bayavahmed/PCB_LIBS/KiCADLibrary/Kütüphane İlk Entegrasyon.docx

KiCad’e AKL pluginini yükle.

Sembol Kütüphanelerini kicade ekle.

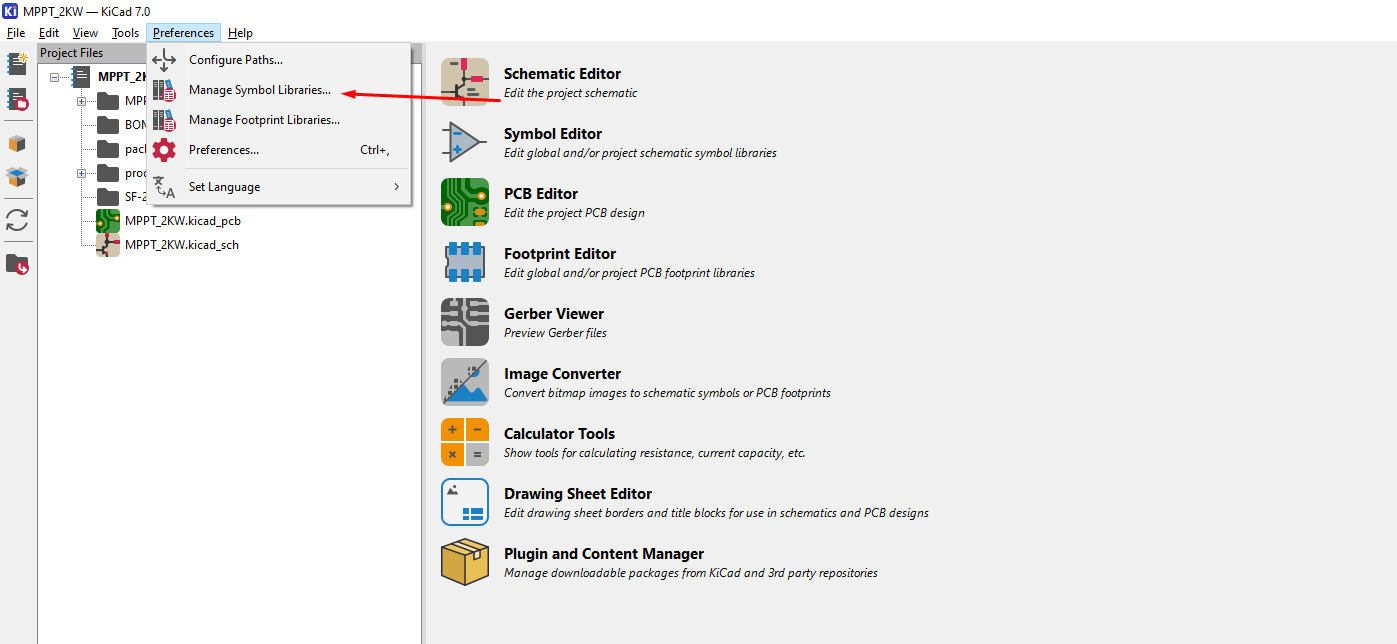
[picture p1: figure]
metin içeren bir resim Açıklama otomatik olarak oluşturuldu

AKL Kütüphanesi:

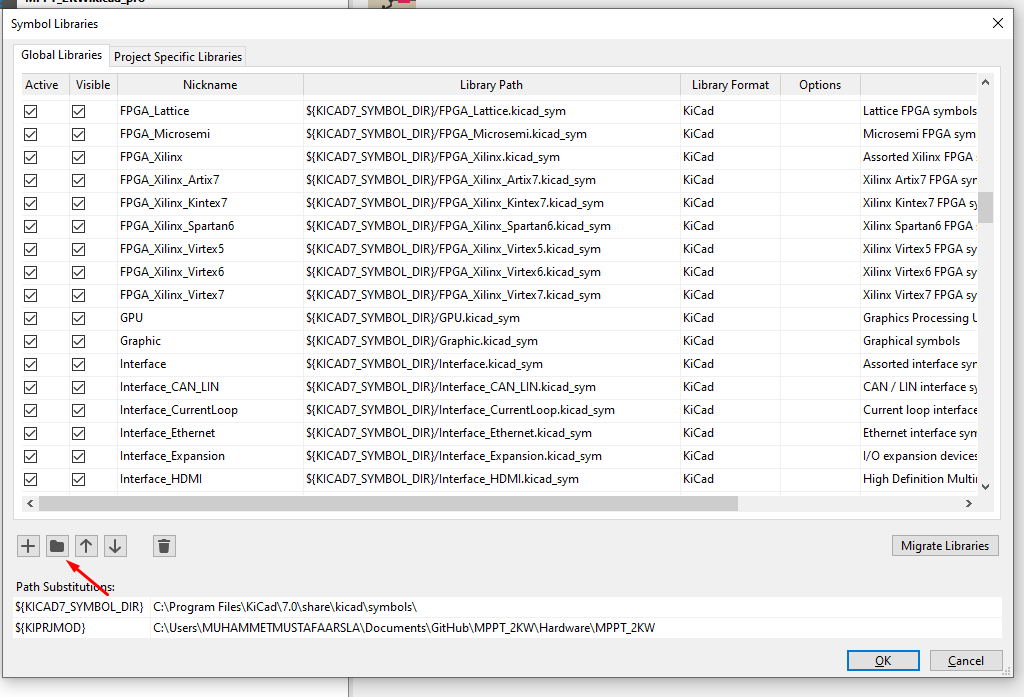
[picture p2: figure]
metin içeren bir resim Açıklama otomatik olarak oluşturuldu

\Documents\KiCad\7.0\3rdparty\symbols\com_github_dawidcislo_alternate-kicad-library

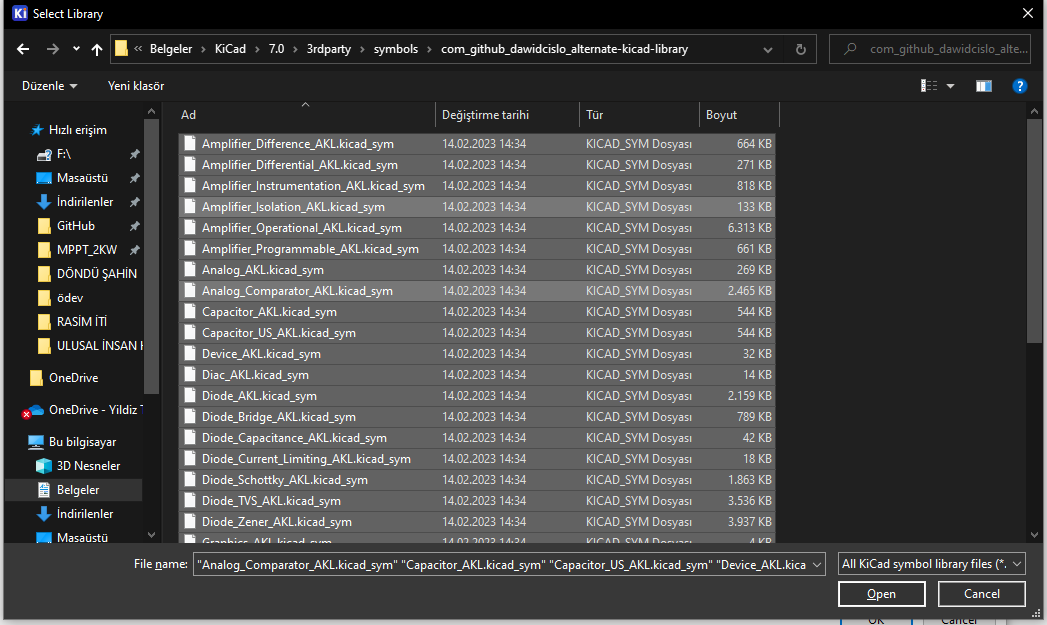
[picture p3: figure]

Hepsini seç

Personal kütüphanesi ekle.

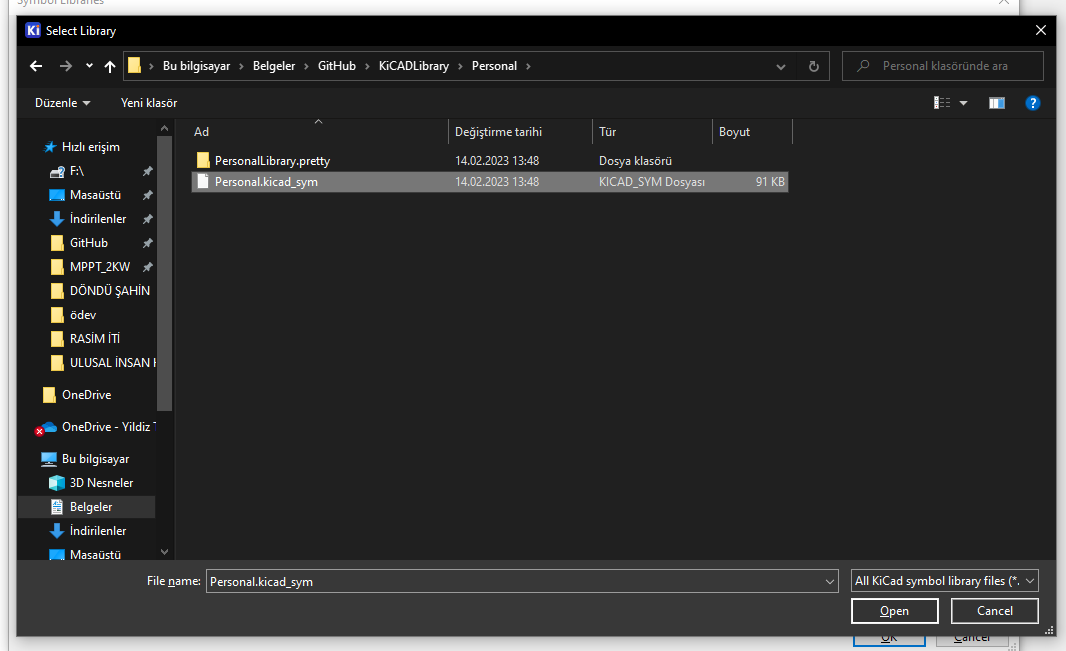
[picture p4: figure]
metin, ekran, ekran görüntüsü, iç mekan içeren bir resim Açıklama otomatik olarak oluşturuldu

~/Documents/GitHub/KiCADLibrary/Personal/Personal.kicad_sym

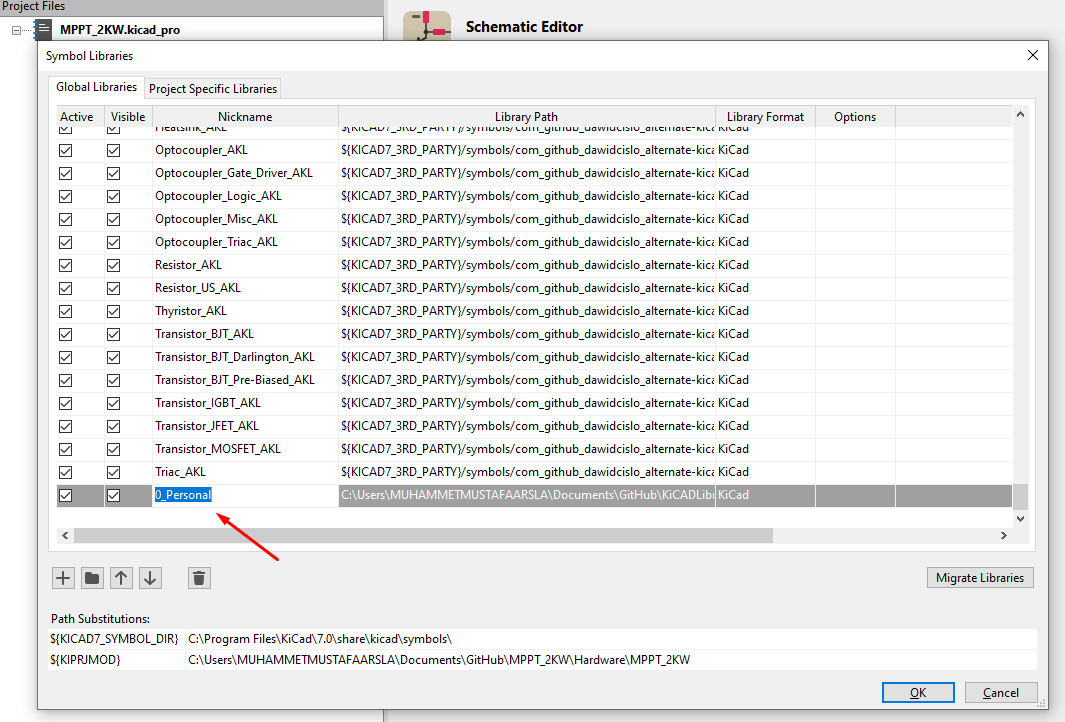
[picture p5: figure]
metin içeren bir resim Açıklama otomatik olarak oluşturuldu

İsmini “0_Personal” olarak değiştir.

SamacSYS kütüphanesini de ekle.

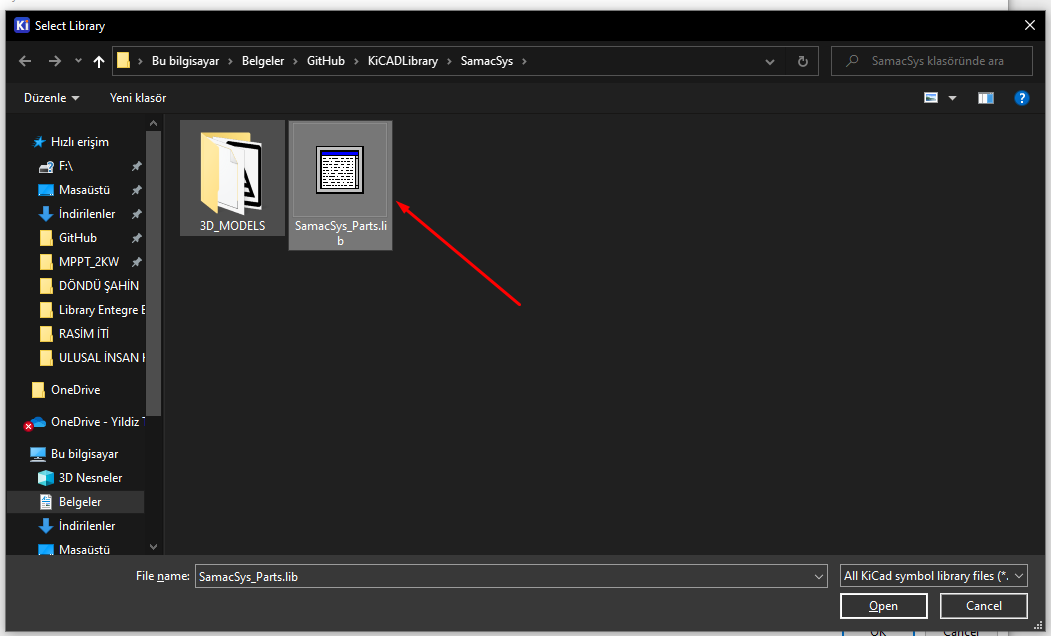
[picture p6: figure]

~~\Documents\GitHub\KiCADLibrary\SamacSys

Footprint Kütüphaneleri eklenmeli:

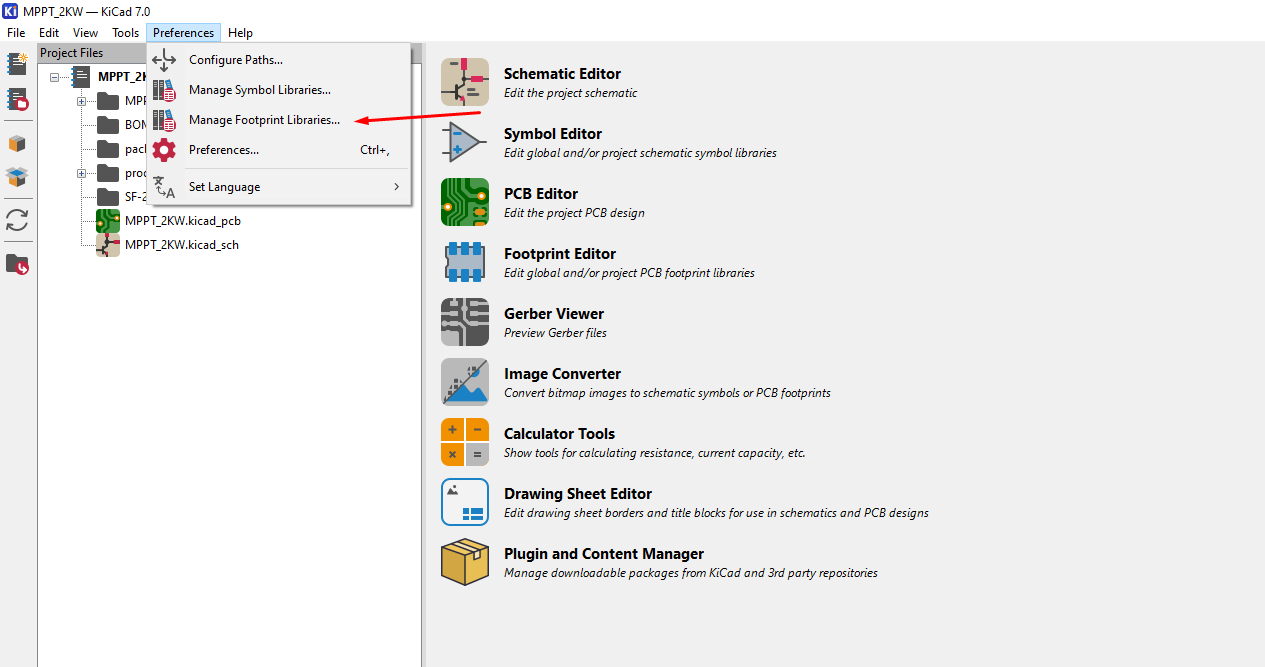
[picture p7: figure]

AKL kütüphanesi eklenmeli. Klasör seçeneğinden eklenir. Hepsini seç.

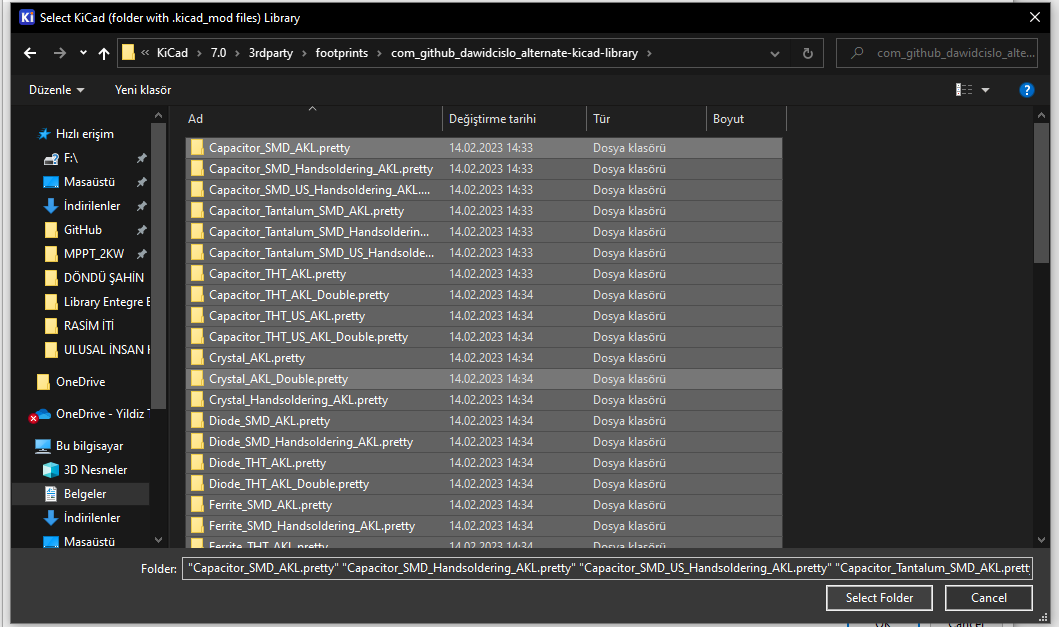
[picture p8: figure]

~ \Documents\KiCad\7.0\3rdparty\footprints\com_github_dawidcislo_alternate-kicad-library

Personal Kütüphanesi eklenmeli ve ismi 0_Personal olarak ayarlanmalı. Klasör seçeneğinden eklenir.

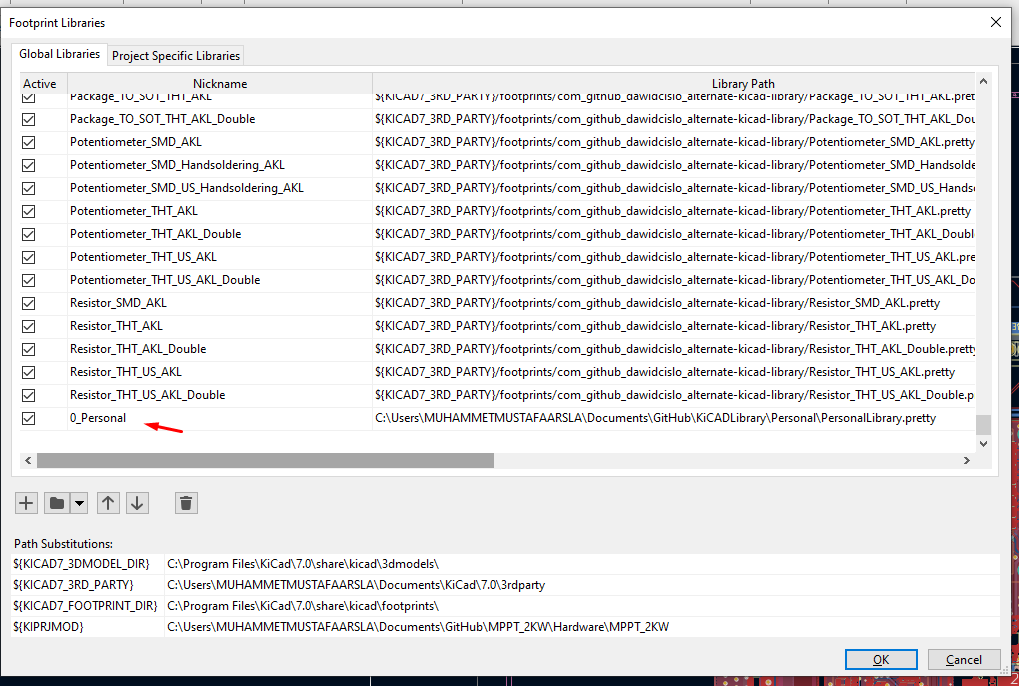
[picture p9: figure]

~~\Documents\GitHub\KiCADLibrary\Personal\PersonalLibrary.pretty

SamaySys kütüphanesini eklemek için klasör yanındaki seçenekten KiCad Legacy seçeneği seçilmeli:

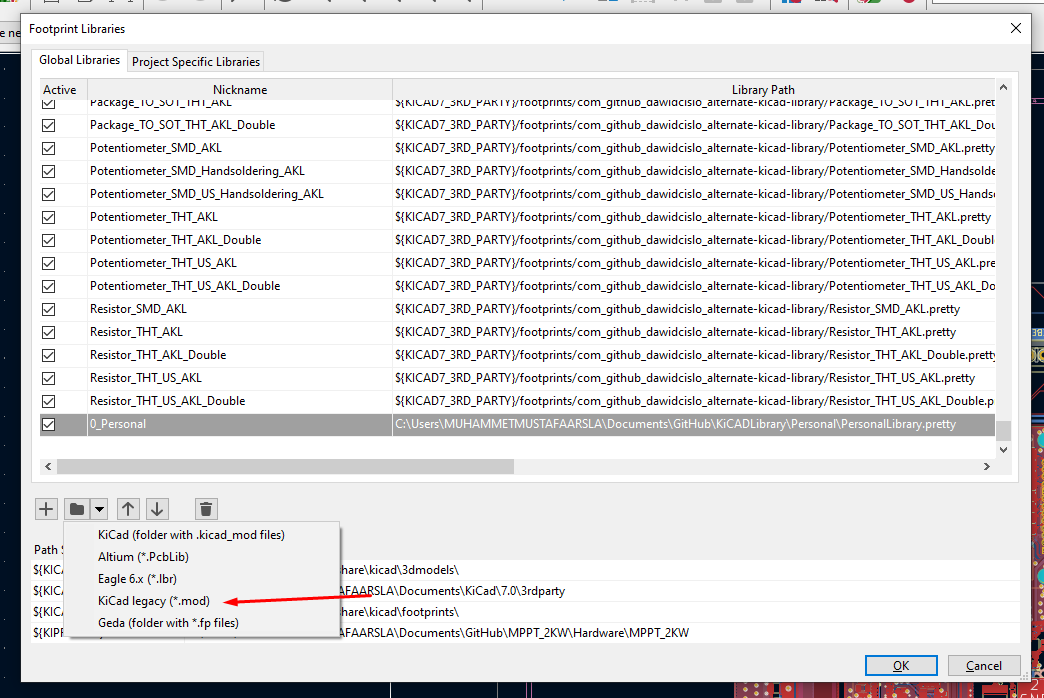
[picture p10: figure]
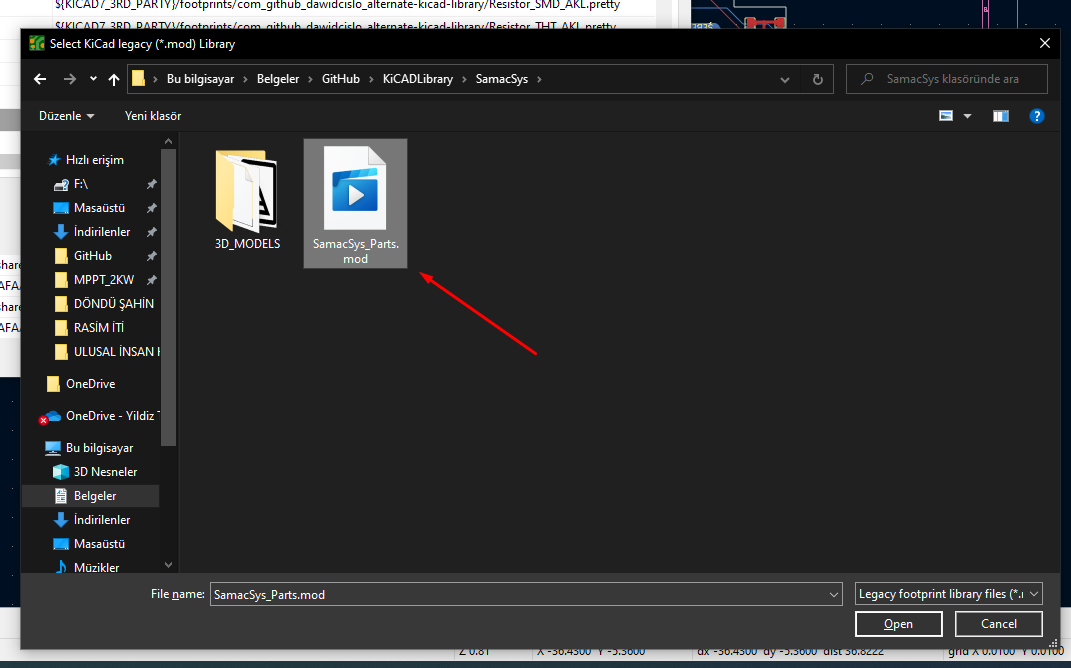
[picture p11: figure]

~\Documents\GitHub\KiCADLibrary\SamacSys\SamacSys_Parts.mod

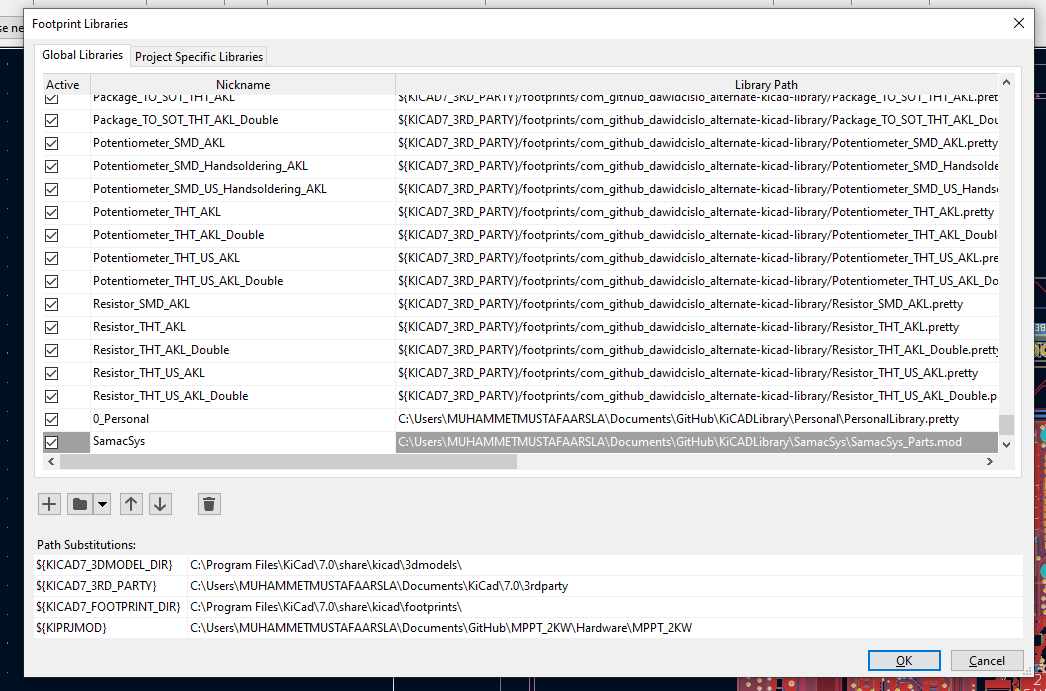
[picture p12: figure]
metin içeren bir resim Açıklama otomatik olarak oluşturuldu

İsmini “SamacSys” olarak değiştir.
