bayavahmed/PCB_LIBS/KiCADLibrary/Sembol Ekleme Formatı.xlsx

Component | Value | Footprint | Datasheet | Part Name | Desciription
Direnç | Direncin değerini giriniz. | Sembol için Footprint ekleyiniz. | Gerekli değil. | Digikeyden örnek bir ürün kodu giriniz. | Digikeyden örnek bir componentin özelliklerini giriniz.
Kondansatör | Kapasitenin değerini ve voltajını giriniz. | Sembol için Footprint ekleyiniz. | Gerekli değil. | Digikeyden örnek bir ürün kodu giriniz. | Digikeyden örnek bir componentin özelliklerini giriniz.
Endüktans | Endüktans değerini ve Akımını giriniz. | Sembol için Footprint ekleyiniz. | Gerekli değil. | Digikeyden örnek bir ürün kodu giriniz. | Digikeyden örnek bir componentin özelliklerini giriniz.
Buzzer | Part nameyi girebilirsiniz. | Sembol için Footprint ekleyiniz. | Digikey datasheet adresini giriniz. | Digikeyden örnek bir ürün kodu giriniz. | Digikeyden örnek bir componentin özelliklerini giriniz.
Entegreler | Part nameyi girebilirsiniz. | Sembol için Footprint ekleyiniz. | Digikey datasheet adresini giriniz. | Digikeyden örnek bir ürün kodu giriniz. | Digikeyden örnek bir componentin özelliklerini giriniz.
Mosfet | Part nameyi girebilirsiniz. | Sembol için Footprint ekleyiniz. | Digikey datasheet adresini giriniz. | Digikeyden örnek bir ürün kodu giriniz. | Digikeyden örnek bir componentin özelliklerini giriniz.
Diyot | Part nameyi girebilirsiniz. | Sembol için Footprint ekleyiniz. | Digikey datasheet adresini giriniz. | Digikeyden örnek bir ürün kodu giriniz. | Digikeyden örnek bir componentin özelliklerini giriniz.
FerriteBeat | Akım değerini ve omajını yazınız. | Sembol için Footprint ekleyiniz. | Digikey datasheet adresini giriniz. | Digikeyden örnek bir ürün kodu giriniz. | Digikeyden örnek bir componentin özelliklerini giriniz.
Konnector | Marka ve Model giriniz. | Sembol için Footprint ekleyiniz. | Digikey datasheet adresini giriniz. | Digikeyden örnek bir ürün kodu giriniz. | Digikeyden örnek bir componentin özelliklerini giriniz.
Relay | Akım ve Sürme Gerilimi | Sembol için Footprint ekleyiniz. | Digikey datasheet adresini giriniz. | Digikeyden örnek bir ürün kodu giriniz. | Digikeyden örnek bir componentin özelliklerini giriniz.
Kristal | Çalışma frekansını giriniz. | Sembol için Footprint ekleyiniz. | Digikey datasheet adresini giriniz. | Digikeyden örnek bir ürün kodu giriniz. | Digikeyden örnek bir componentin özelliklerini giriniz.
 |  |  |  | Not: Digikey yerine özdisan da olur.
