bayavahmed/PCB_LIBS/AltiumLibrary/steps/User Library-TO-92_Str.sldasm

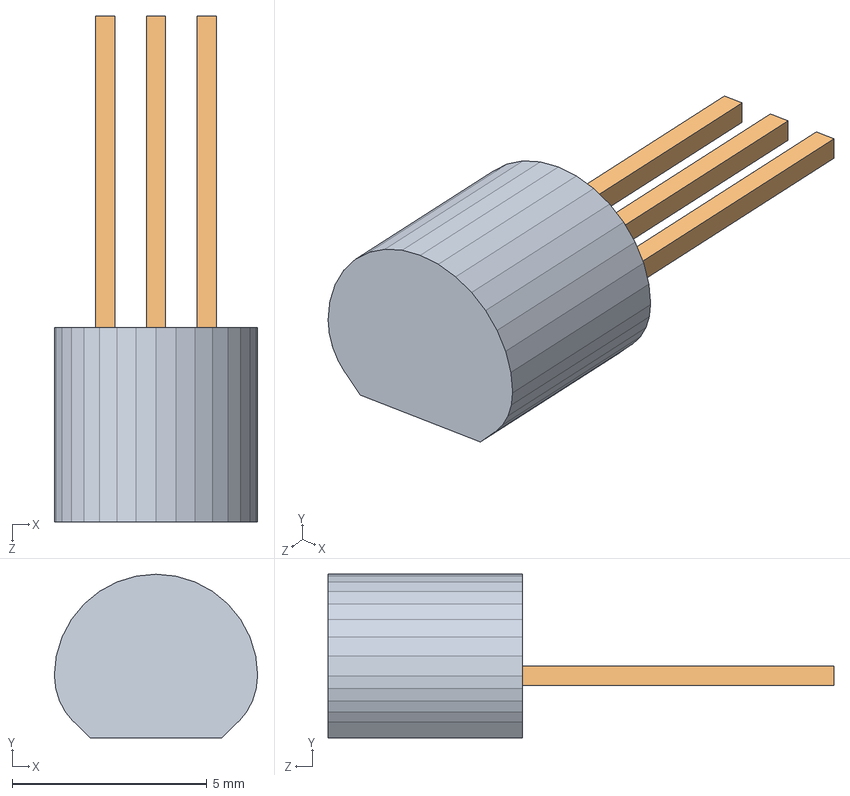
[picture p13: CAD file, 2025-12-09]
AltiumLibrary/steps/User Library-TO-92_Str.sldasm
5.23 x 4.20 x 13.0 mm
User Library-TO-92_Str_Extruded
User Library-TO-92_Str_Extruded_2 x 3
