bayavahmed/PCB_LIBS/AltiumLibrary/steps/User Library-S10K275.sldasm

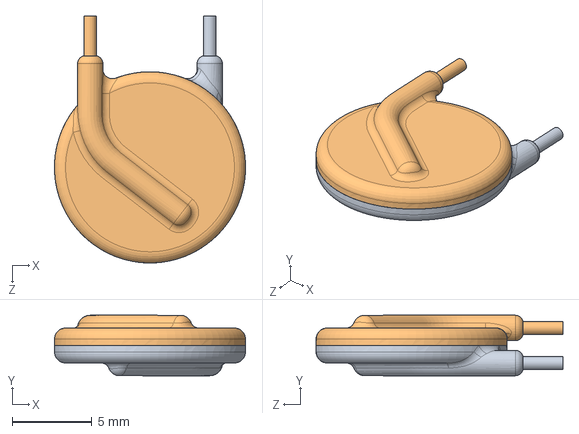
[picture p14: CAD file, 2025-12-09]
AltiumLibrary/steps/User Library-S10K275.sldasm
12.0 x 3.80 x 15.5 mm
User Library-S10K275_1
User Library-S10K275_2
