bayavahmed/PCB_LIBS/AltiumLibrary/steps/DEV09S364GTLF--3DModel-STEP-56544/DEV09S364GTLF--3DModel-STEP-56544.STEP

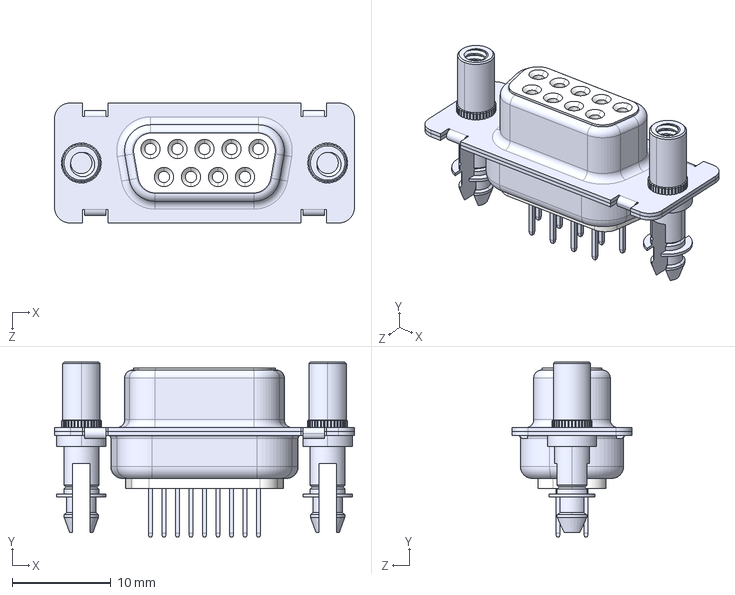
[picture p15: CAD file, 2025-12-09]
AltiumLibrary/steps/DEV09S364GTLF--3DModel-STEP-56544/DEV09S364GTLF--3DModel-STEP-56544.STEP
30.4 x 17.8 x 12.2 mm
