bayavahmed/PCB_LIBS/AltiumLibrary/steps/duba_step/275-DUBA-BASLIGI.DXF

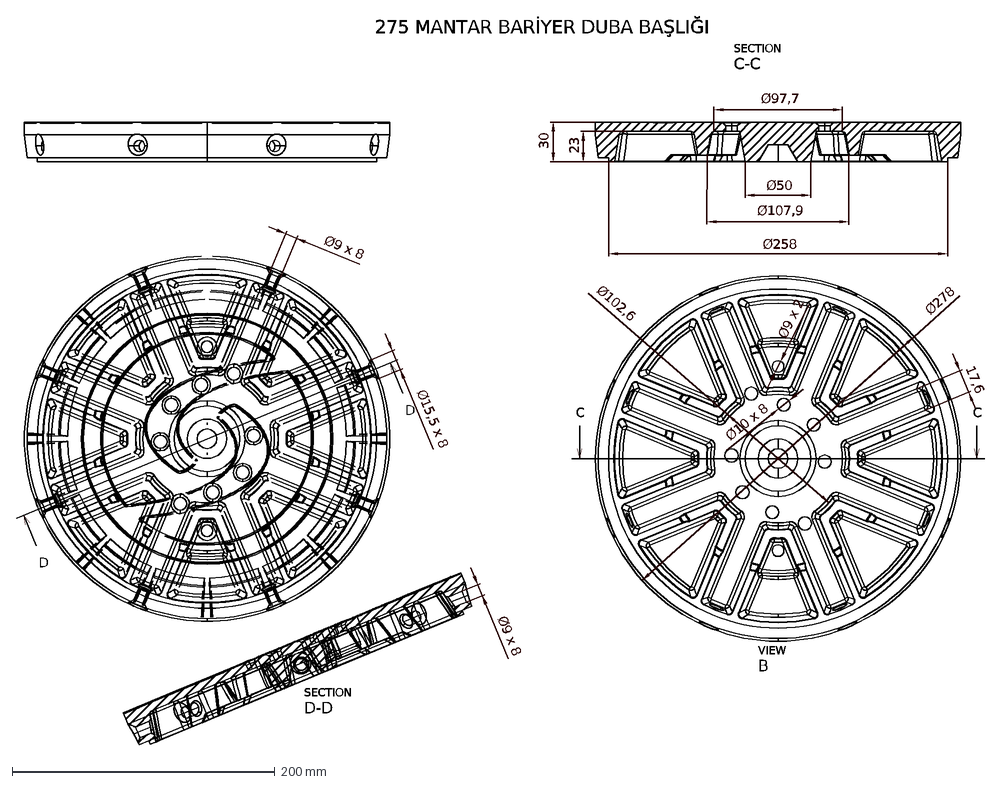
[picture p16: CAD file, 2025-12-09]
AltiumLibrary/steps/duba_step/275-DUBA-BASLIGI.DXF
VIEW B
C
D
SECTION D-D
SECTION C-C
275 MANTAR BARİYER DUBA BAŞLIĞI
Ø278
30
Ø97,7
Ø258
23
Ø107,9
Ø50
Ø9 x 8
Ø15,5 x 8
Ø102,6
17,6
Ø10 x 8
Ø9 x 2
