bayavahmed/PCB_LIBS/AltiumLibrary/steps/STL/G-188-L.stp

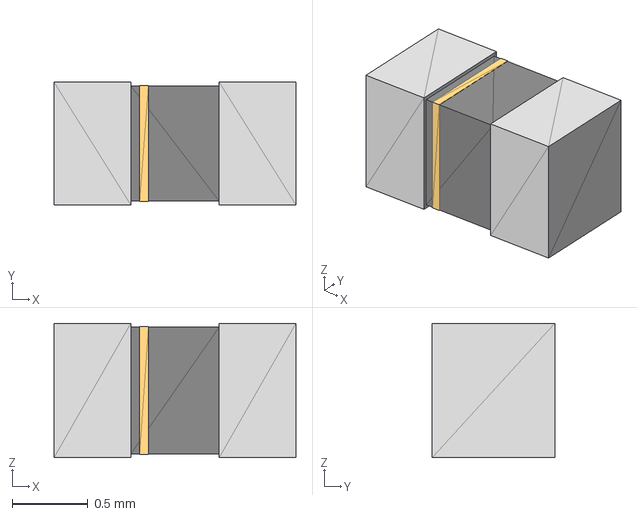
[picture p17: CAD file, 2025-12-09]
AltiumLibrary/steps/STL/G-188-L.stp
1.60 x 0.812 x 0.889 mm
