bayavahmed/PCB_LIBS/KiCADLibrary/Personal/3DMODELS/TB-1712-M5-NOCOVER.step

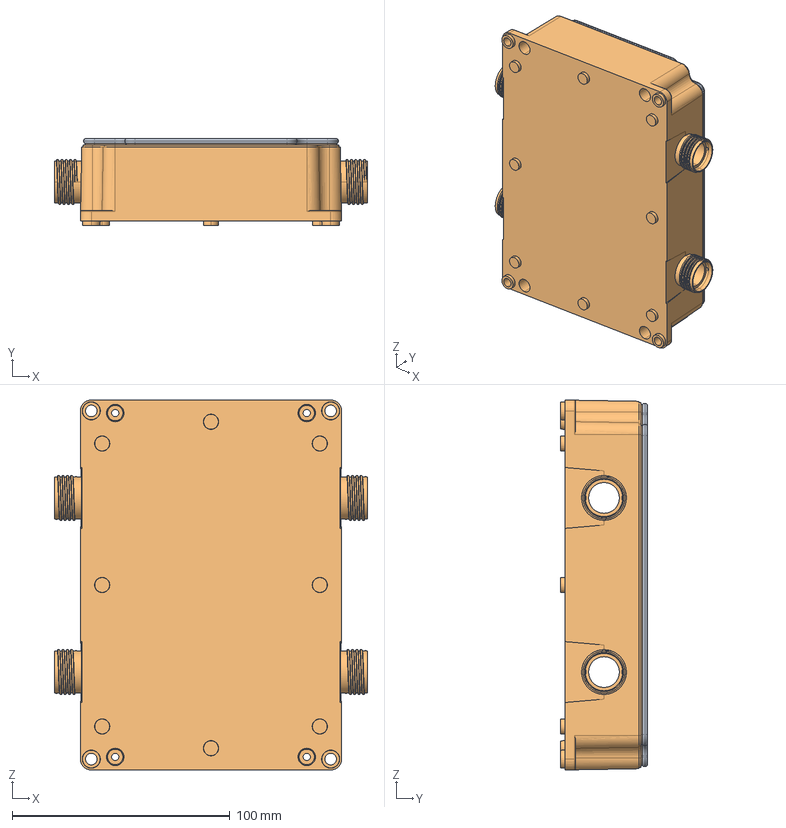
[picture p18: CAD file, 2026-03-17]
KiCADLibrary/Personal/3DMODELS/TB-1712-M5-NOCOVER.step
144.0 x 40.0 x 170.0 mm
TB-1712 - Kopya_M5
TB-1712 - Kopya_M006
