bayavahmed/PCB_LIBS/KiCADLibrary/SamacSys/3D_MODELS/MC3479P.step

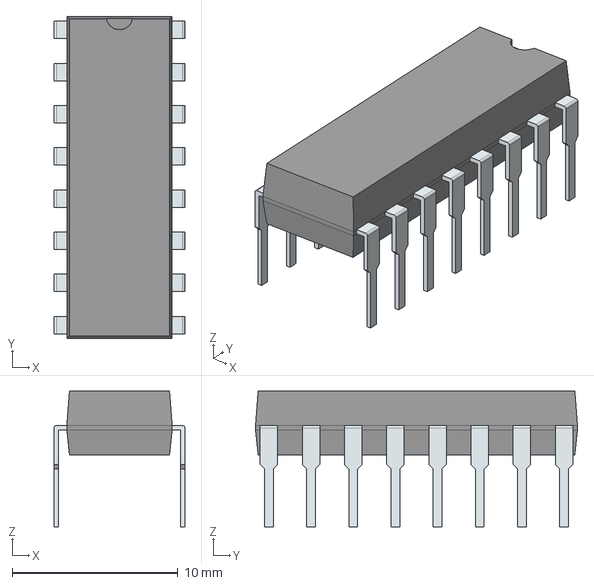
[picture p19: CAD file, 2025-12-09]
KiCADLibrary/SamacSys/3D_MODELS/MC3479P.step
7.88 x 19.4 x 8.19 mm
PinsArrayLR
