bayavahmed/PCB_LIBS/AltiumLibrary/steps/duba_step/DUBA-BASLIGI-Q220.stp

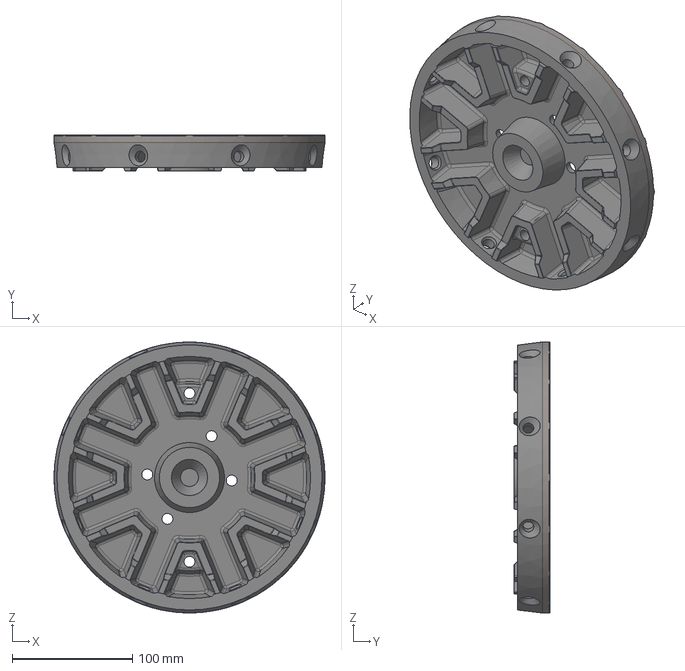
[picture p20: CAD file, 2025-12-09]
AltiumLibrary/steps/duba_step/DUBA-BASLIGI-Q220.stp
225.0 x 30.0 x 225.0 mm
