bayavahmed/PCB_LIBS/AltiumLibrary/steps/pxc_1770908_00_PTSM-0-5-4-2-5-H-THR-R32_3D.stp

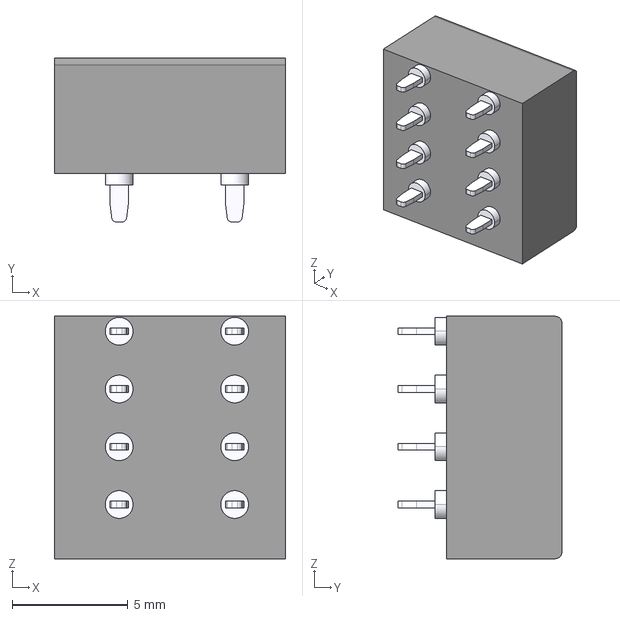
[picture p21: CAD file, 2025-12-09]
AltiumLibrary/steps/pxc_1770908_00_PTSM-0-5-4-2-5-H-THR-R32_3D.stp
10.0 x 7.10 x 10.5 mm
