bayavahmed/PCB_LIBS/KiCADLibrary/Personal/3DMODELS/TB-1712-M5.STEP

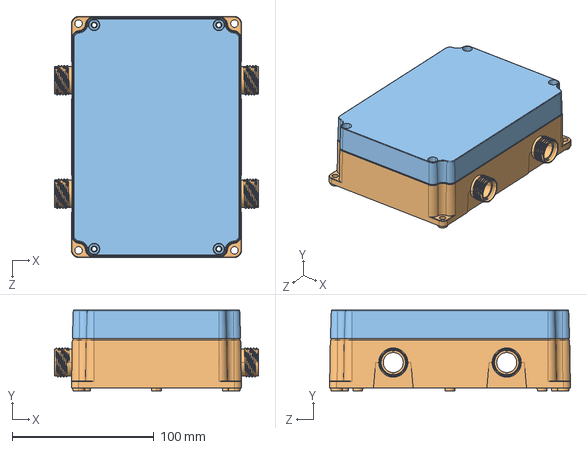
[picture p22: CAD file, 2026-03-17]
KiCADLibrary/Personal/3DMODELS/TB-1712-M5.STEP
144.0 x 57.0 x 170.0 mm
TB-1712 - Kopya_M5
TB-1712-P-2
