bayavahmed/PCB_LIBS/AltiumLibrary/steps/cap20.step

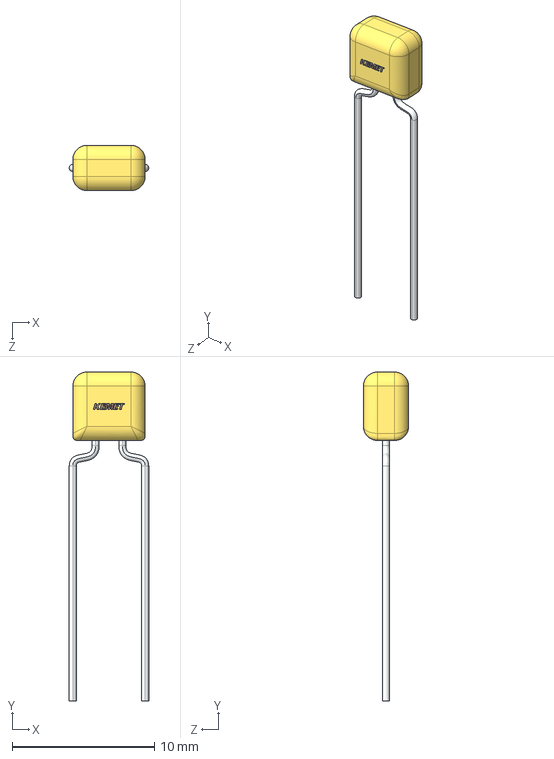
[picture p23: CAD file, 2025-12-09]
AltiumLibrary/steps/cap20.step
5.59 x 23.1 x 3.19 mm
