bayavahmed/PCB_LIBS/AltiumLibrary/steps/duba_step/220-DUBA-BASLIGI.DXF

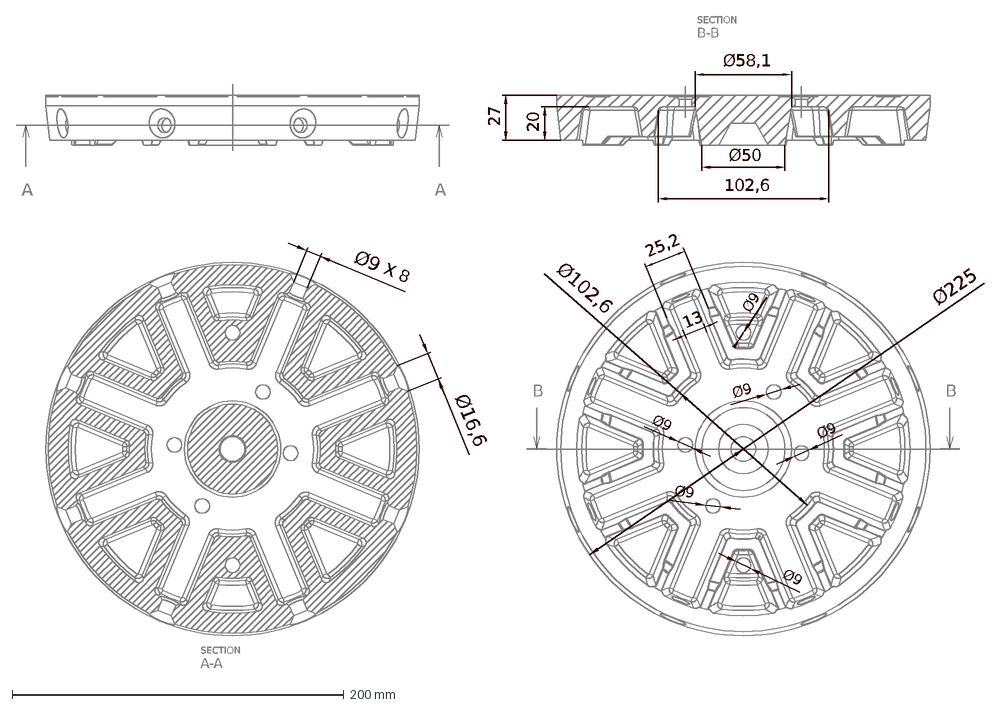
[picture p24: CAD file, 2025-12-09]
AltiumLibrary/steps/duba_step/220-DUBA-BASLIGI.DXF
B
SECTION B-B
A
SECTION A-A
Ø9 X 8
Ø225
Ø102,6
20
Ø9
Ø58,1
Ø50
27
102,6
25,2
13
Ø16,6
