bayavahmed/PCB_LIBS/KiCADLibrary/Personal/3DMODELS/WURTH_USB3_A_F_692122030100.stp

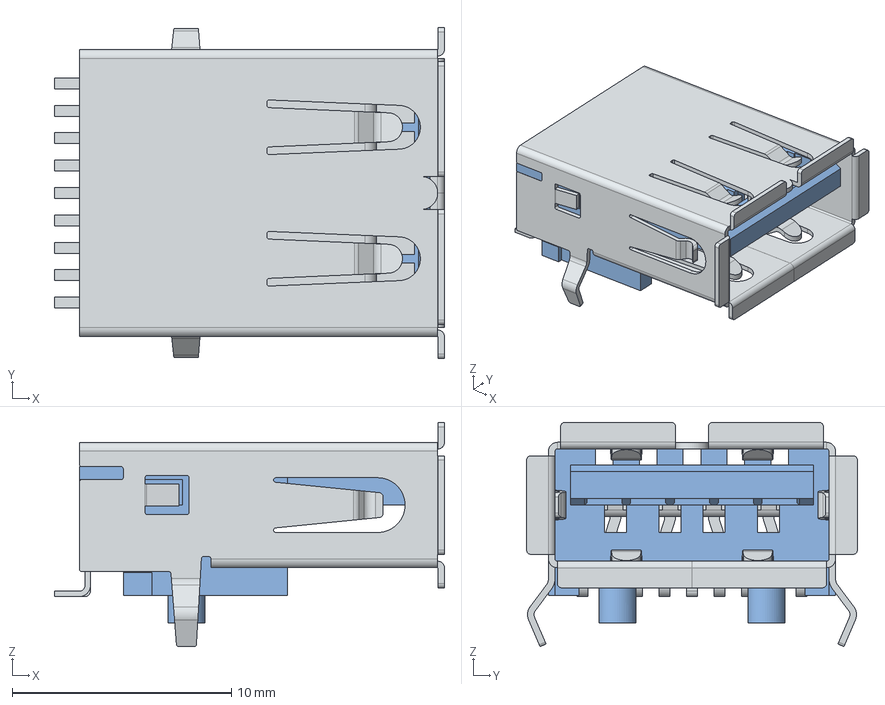
[picture p25: CAD file, 2026-01-18]
KiCADLibrary/Personal/3DMODELS/WURTH_USB3_A_F_692122030100.stp
17.8 x 15.1 x 10.2 mm
pin1
pin3
pin7 x 2
pin2
pin4
pin5
pin6 x 2
Shielding
Housing
