bayavahmed/PCB_LIBS/AltiumLibrary/steps/D-SUB_PCB.stp

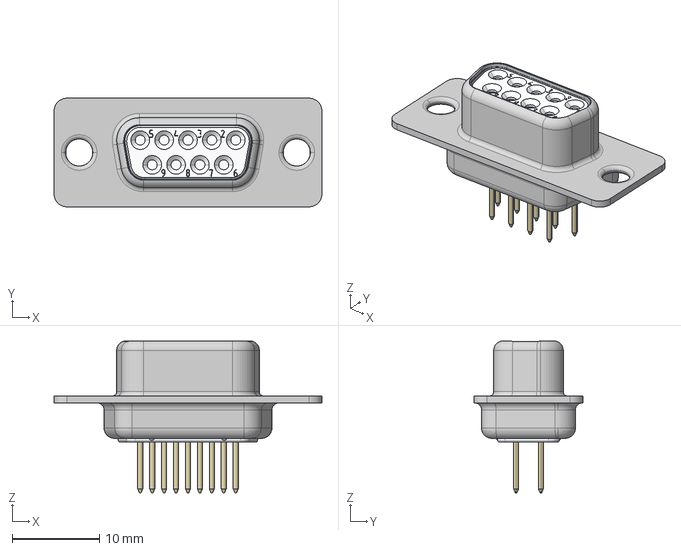
[picture p26: CAD file, 2025-12-09]
AltiumLibrary/steps/D-SUB_PCB.stp
30.8 x 12.5 x 17.4 mm
