bayavahmed/PCB_LIBS/KiCADLibrary/SamacSys/3D_MODELS/NFM18PC105R0J3D.step

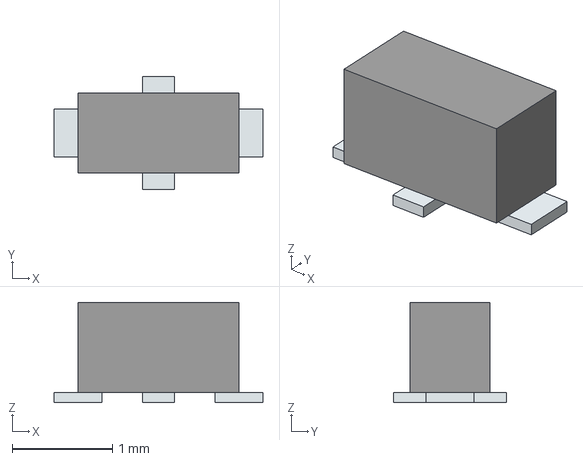
[picture p27: CAD file, 2025-12-09]
KiCADLibrary/SamacSys/3D_MODELS/NFM18PC105R0J3D.step
2.08 x 1.12 x 1.00 mm
Pins
