bayavahmed/PCB_LIBS/AltiumLibrary/steps/molex_009481054.stp

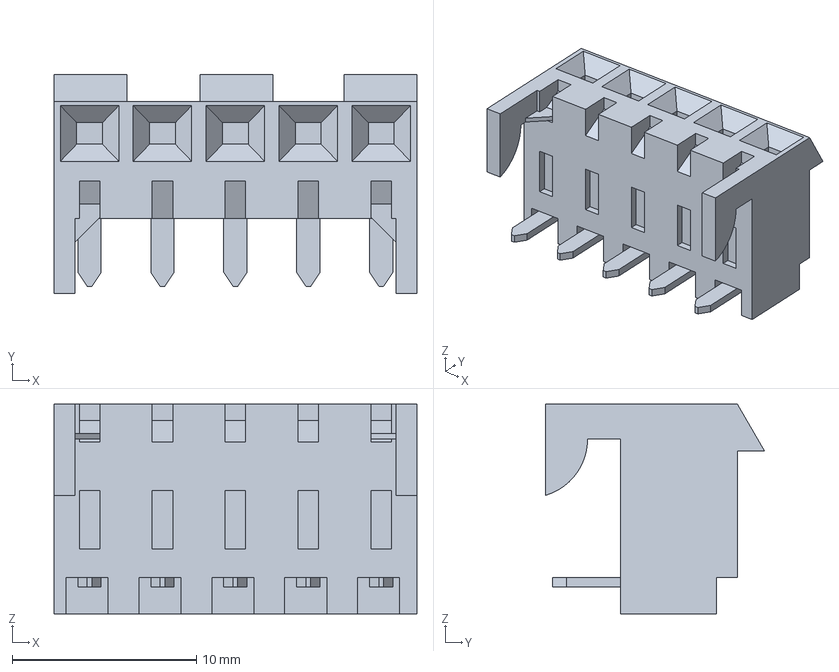
[picture p28: CAD file, 2025-12-09]
AltiumLibrary/steps/molex_009481054.stp
19.7 x 11.9 x 11.4 mm
