bayavahmed/PCB_LIBS/KiCADLibrary/Personal/3DMODELS/MS3102E16-10P.STEP

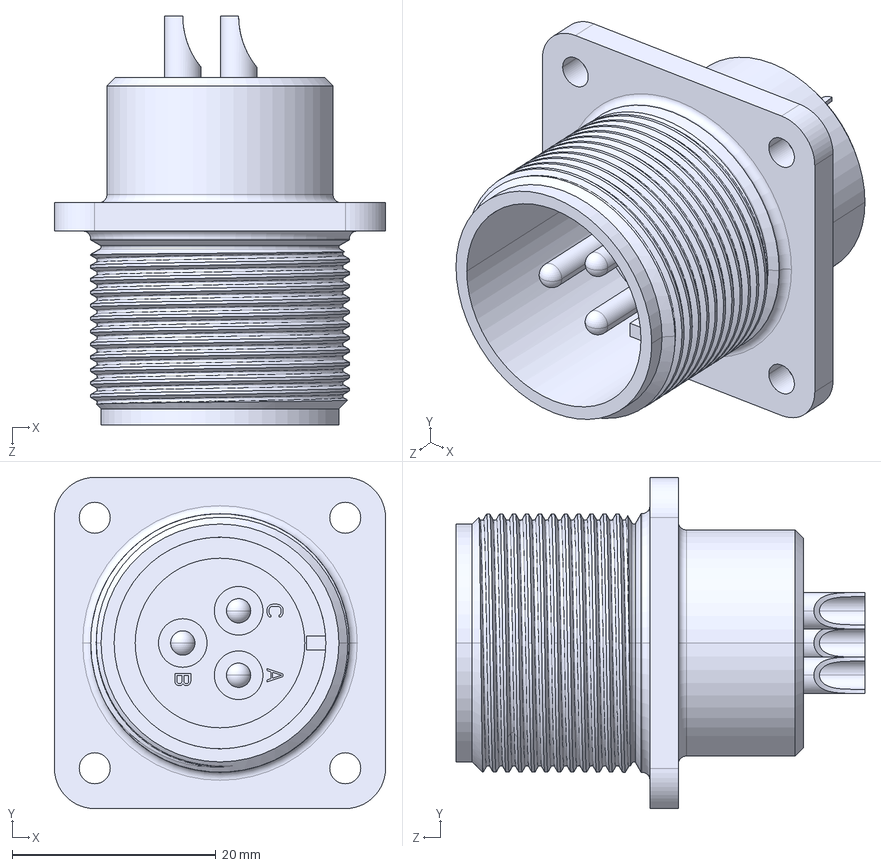
[picture p29: CAD file, 2025-12-09]
KiCADLibrary/Personal/3DMODELS/MS3102E16-10P.STEP
32.5 x 32.5 x 40.2 mm
