bayavahmed/PCB_LIBS/AltiumLibrary/steps/SFH11-xxPC-D03-RA-BK.STEP

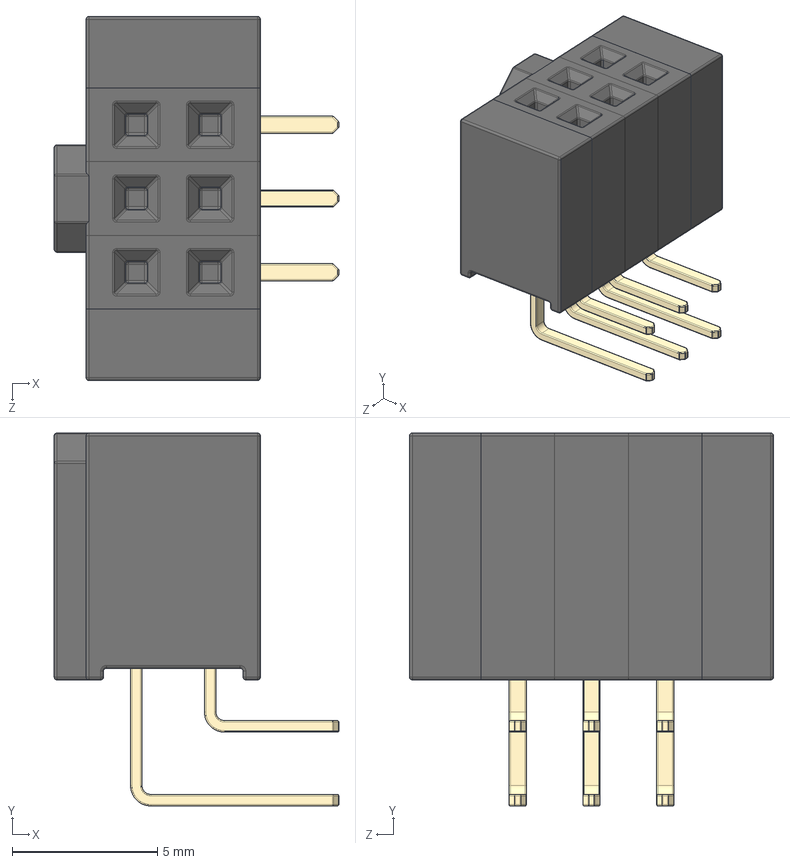
[picture p30: CAD file, 2025-12-09]
AltiumLibrary/steps/SFH11-xxPC-D03-RA-BK.STEP
9.80 x 12.8 x 12.5 mm
body section with RA gold pins x 3
end x 2
Polarizing Key
