bayavahmed/PCB_LIBS/KiCADLibrary/Personal/3DMODELS/HH-044_UST.step

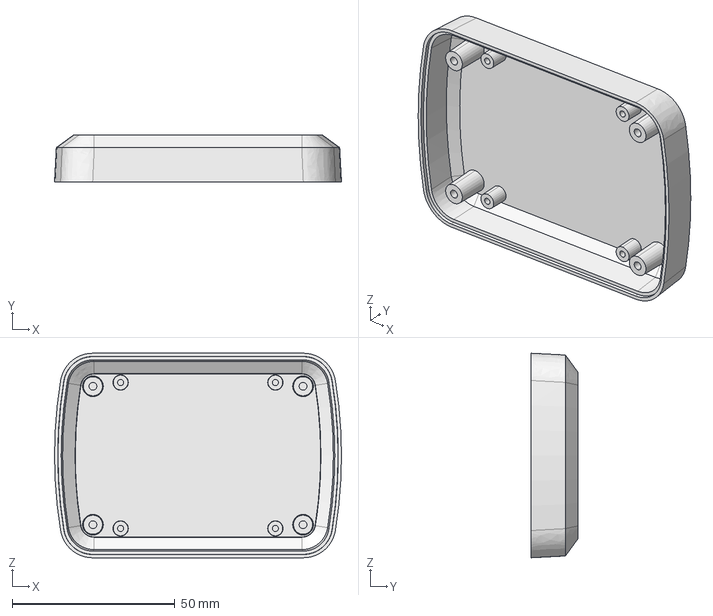
[picture p31: CAD file, 2025-12-09]
KiCADLibrary/Personal/3DMODELS/HH-044_UST.step
88.1 x 14.3 x 62.8 mm
