bayavahmed/PCB_LIBS/KiCADLibrary/SamacSys/3D_MODELS/MJTP1212.step

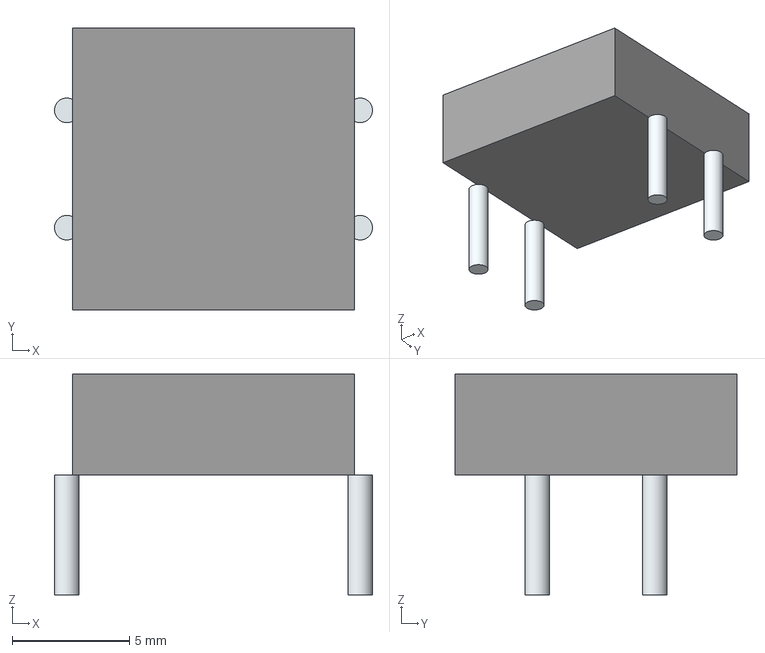
[picture p32: CAD file, 2025-12-09]
KiCADLibrary/SamacSys/3D_MODELS/MJTP1212.step
13.5 x 12.0 x 9.40 mm
Leads x 4
