bayavahmed/PCB_LIBS/AltiumLibrary/steps/STEP-WE-MK-0603A-rev1.stp

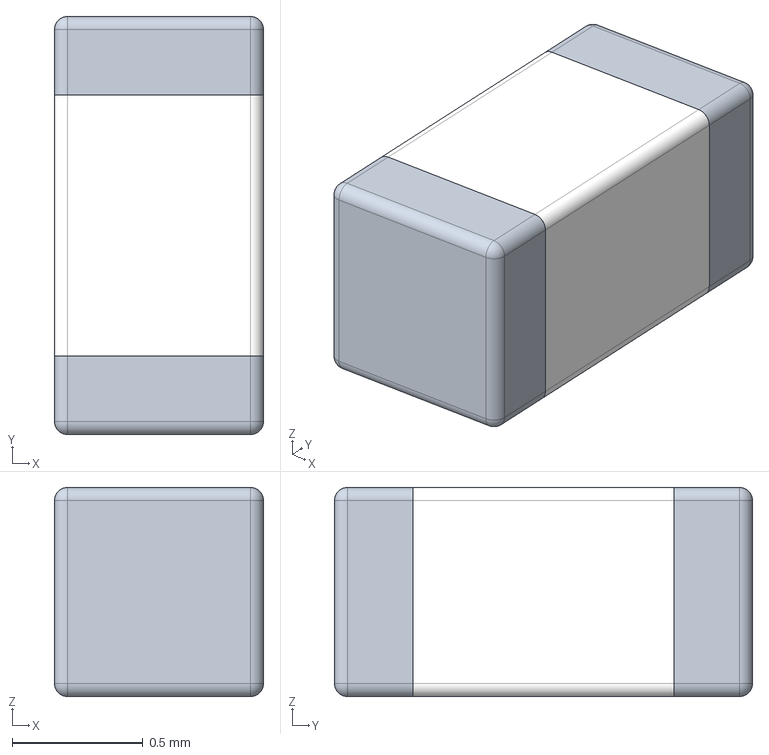
[picture p33: CAD file, 2025-12-09]
AltiumLibrary/steps/STEP-WE-MK-0603A-rev1.stp
0.8 x 1.60 x 0.8 mm
