bayavahmed/PCB_LIBS/KiCADLibrary/Personal/3DMODELS/D2F-L3.stp

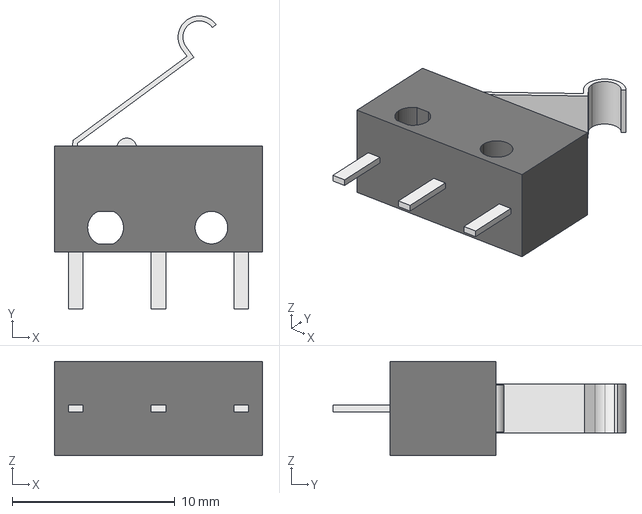
[picture p34: CAD file, 2025-12-09]
KiCADLibrary/Personal/3DMODELS/D2F-L3.stp
12.8 x 18.0 x 5.80 mm
