bayavahmed/PCB_LIBS/KiCADLibrary/SamacSys/3D_MODELS/M031LD2AE.step

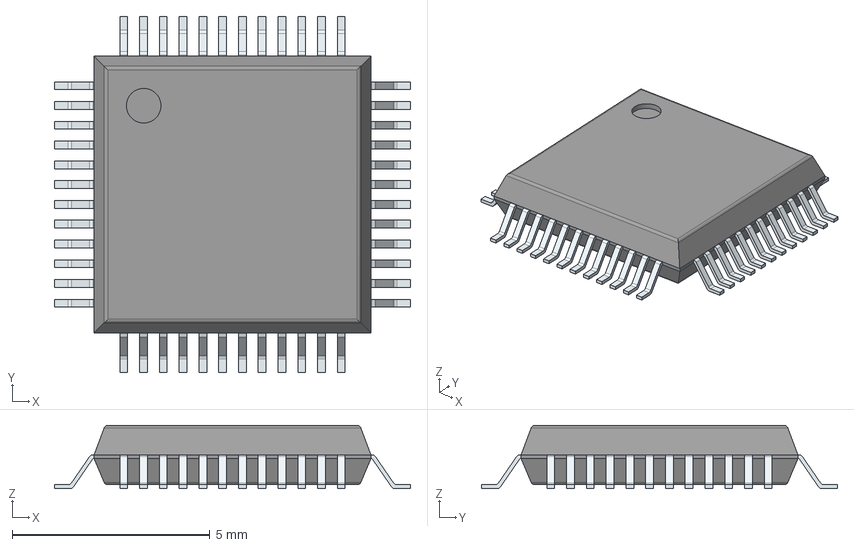
[picture p35: CAD file, 2025-12-09]
KiCADLibrary/SamacSys/3D_MODELS/M031LD2AE.step
9.00 x 9.00 x 1.60 mm
PinsArrayLR
PinsArrayTB
