bayavahmed/PCB_LIBS/AltiumLibrary/steps/FB_0603-1.STEP

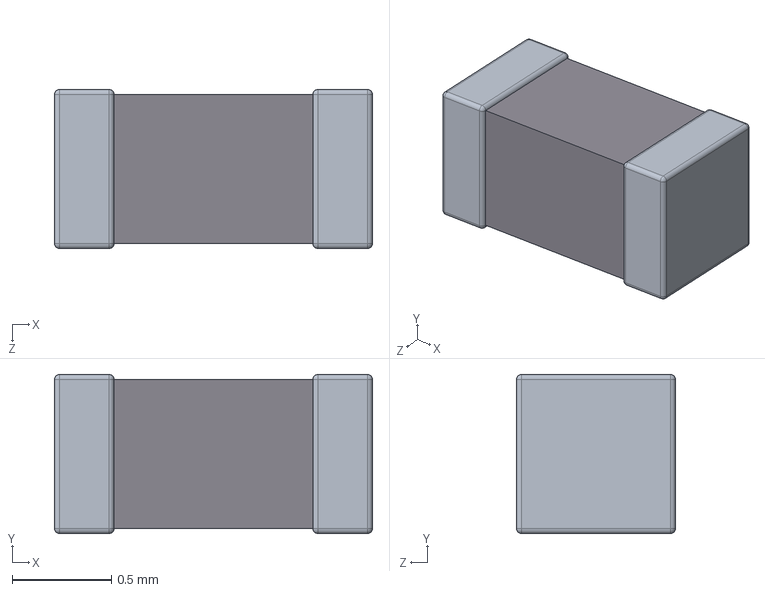
[picture p36: CAD file, 2025-12-09]
AltiumLibrary/steps/FB_0603-1.STEP
1.60 x 0.8 x 0.8 mm
User Library-FB_1608-1_Pad001
User Library-FB_1608-1_Cut
