bayavahmed/PCB_LIBS/KiCADLibrary/Personal/3DMODELS/RF-022.STEP

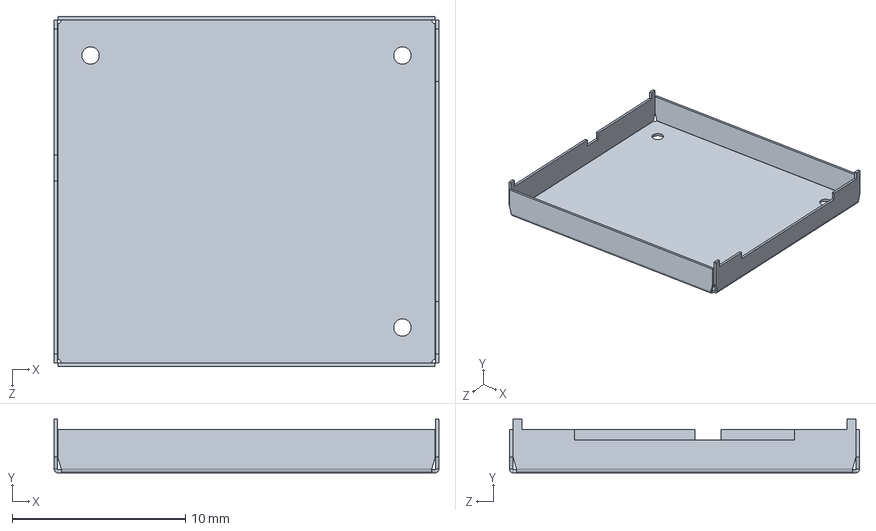
[picture p37: CAD file, 2025-12-09]
KiCADLibrary/Personal/3DMODELS/RF-022.STEP
22.2 x 3.10 x 20.2 mm
