bayavahmed/PCB_LIBS/AltiumLibrary/steps/CAP_UHC_4X7_NCH.step

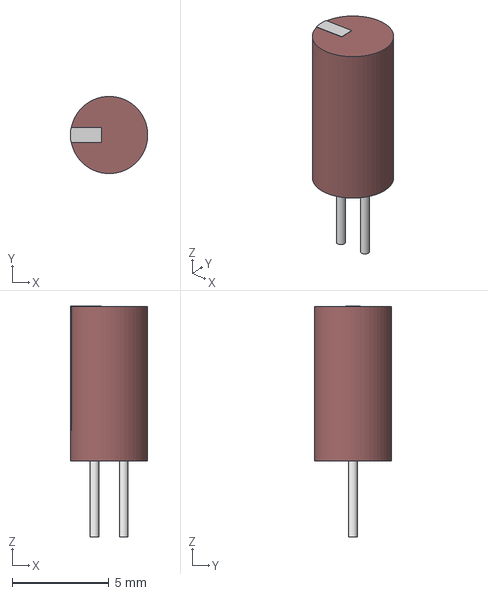
[picture p38: CAD file, 2025-12-09]
AltiumLibrary/steps/CAP_UHC_4X7_NCH.step
4.00 x 3.99 x 11.9 mm
