bayavahmed/PCB_LIBS/KiCADLibrary/Personal/3DMODELS/250-206.stp

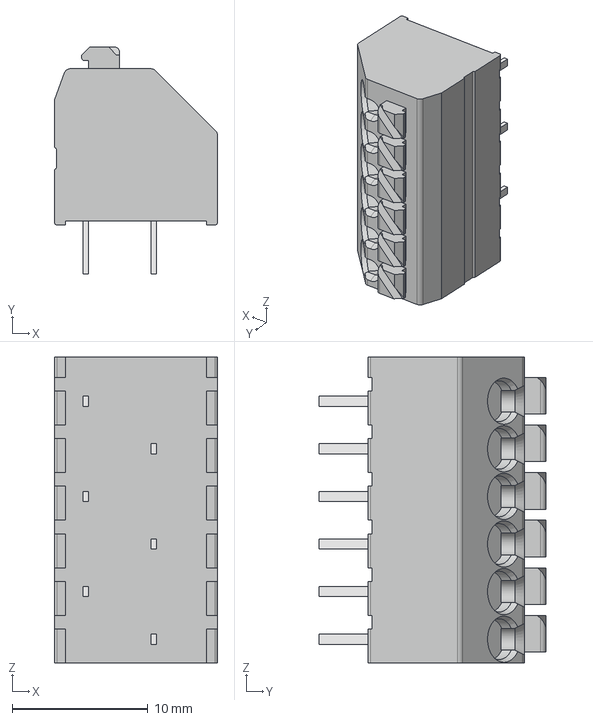
[picture p39: CAD file, 2025-12-09]
KiCADLibrary/Personal/3DMODELS/250-206.stp
12.0 x 16.7 x 22.5 mm
