bayavahmed/PCB_LIBS/AltiumLibrary/steps/SOD523F.step

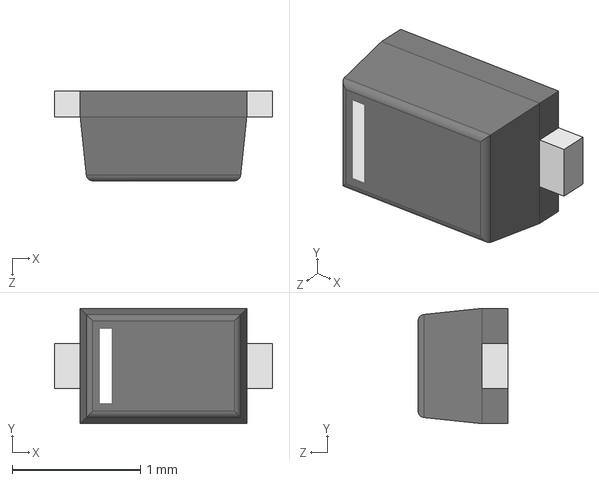
[picture p41: CAD file, 2025-12-09]
AltiumLibrary/steps/SOD523F.step
1.70 x 0.9 x 0.7 mm
