bayavahmed/PCB_LIBS/KiCADLibrary/Personal/3DMODELS/ss-01gl2d.stp

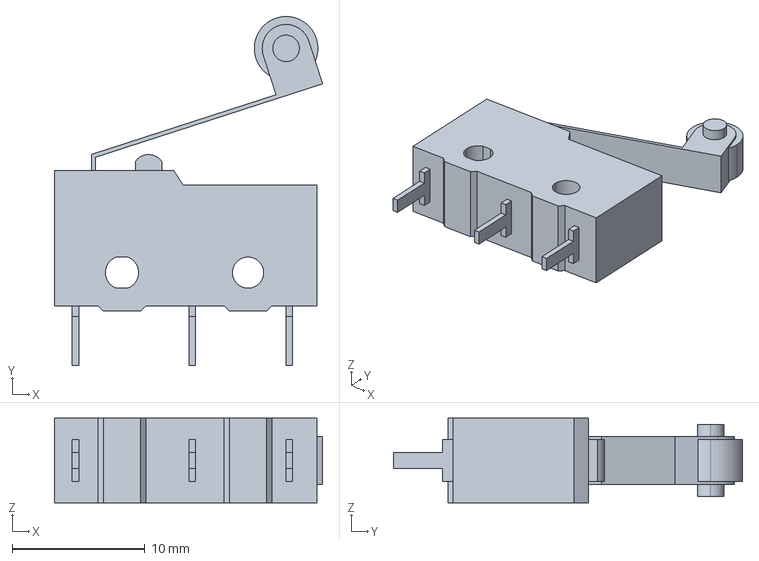
[picture p42: CAD file, 2025-12-09]
KiCADLibrary/Personal/3DMODELS/ss-01gl2d.stp
20.2 x 26.3 x 6.40 mm
