bayavahmed/PCB_LIBS/KiCADLibrary/SamacSys/3D_MODELS/PD3S120L-7.step

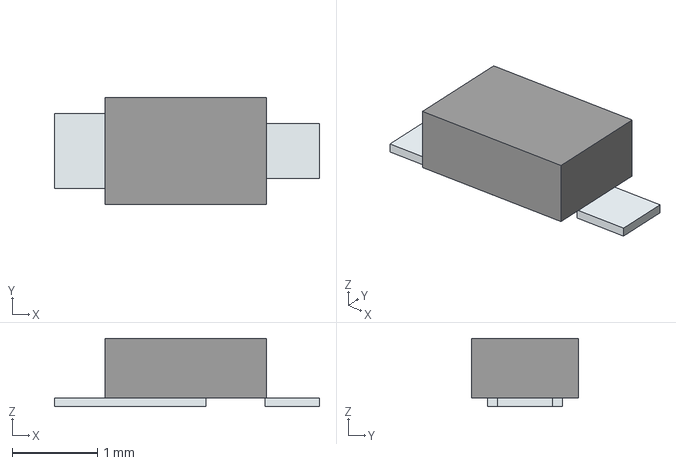
[picture p43: CAD file, 2025-12-09]
KiCADLibrary/SamacSys/3D_MODELS/PD3S120L-7.step
3.11 x 1.25 x 0.8 mm
Pins
