bayavahmed/PCB_LIBS/AltiumLibrary/steps/c-1-770969-1-e-3d.stp

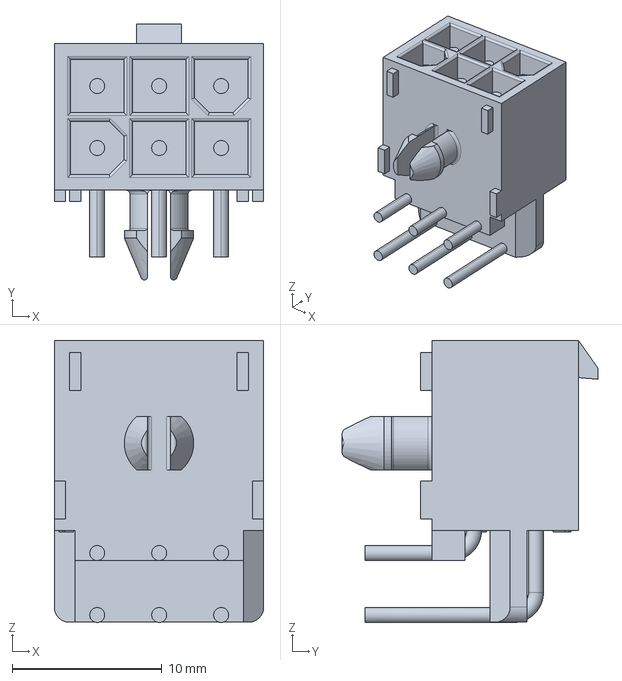
[picture p44: CAD file, 2025-12-09]
AltiumLibrary/steps/c-1-770969-1-e-3d.stp
14.0 x 17.1 x 18.8 mm
