bayavahmed/PCB_LIBS/KiCADLibrary/Personal/3DMODELS/driverBox.step

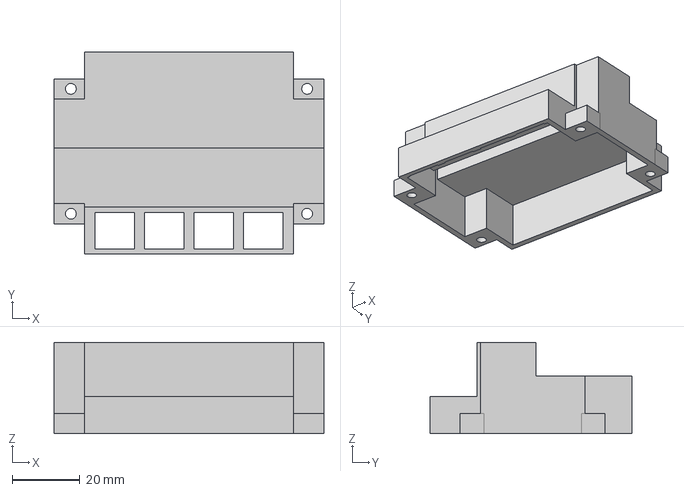
[picture p45: CAD file, 2025-12-09]
KiCADLibrary/Personal/3DMODELS/driverBox.step
80.0 x 60.0 x 27.0 mm
