bayavahmed/PCB_LIBS/AltiumLibrary/steps/DS1040-01 (DIP_switch).stp

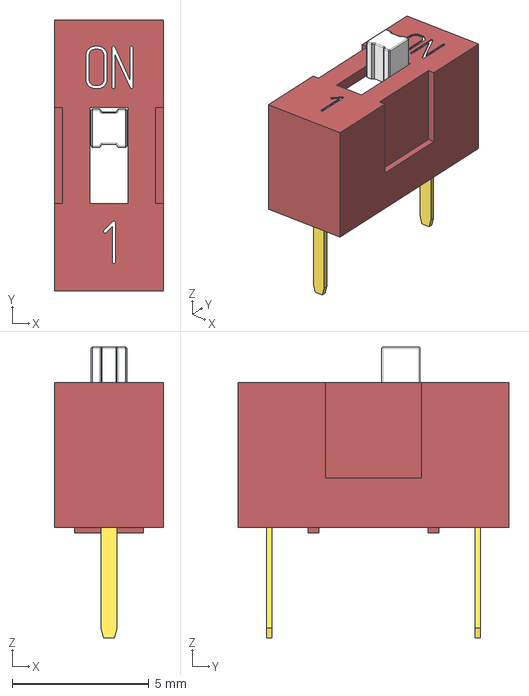
[picture p46: CAD file, 2025-12-09]
AltiumLibrary/steps/DS1040-01 (DIP_switch).stp
4.00 x 9.90 x 10.7 mm
