bayavahmed/PCB_LIBS/KiCADLibrary/Personal/3DMODELS/User Library-TB5_08-3R.step

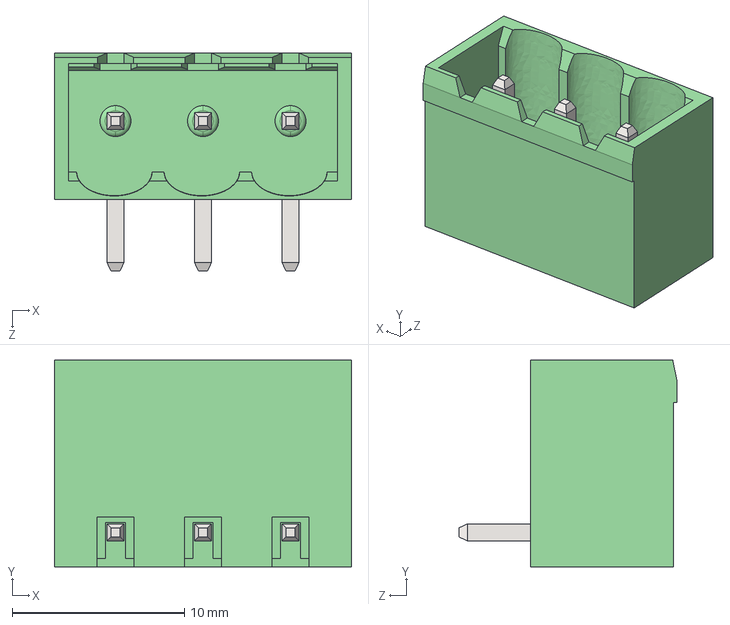
[picture p47: CAD file, 2025-12-09]
KiCADLibrary/Personal/3DMODELS/User Library-TB5_08-3R.step
17.2 x 12.0 x 12.7 mm
