bayavahmed/PCB_LIBS/KiCADLibrary/SamacSys/3D_MODELS/NUC131SD2AE.step

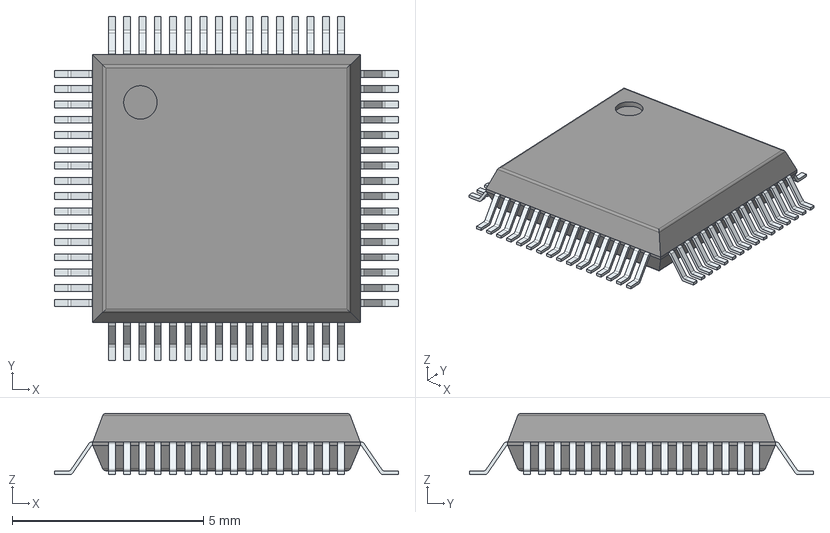
[picture p48: CAD file, 2025-12-09]
KiCADLibrary/SamacSys/3D_MODELS/NUC131SD2AE.step
9.00 x 9.00 x 1.60 mm
PinsArrayLR
PinsArrayTB
