bayavahmed/PCB_LIBS/AltiumLibrary/steps/res_1206.step

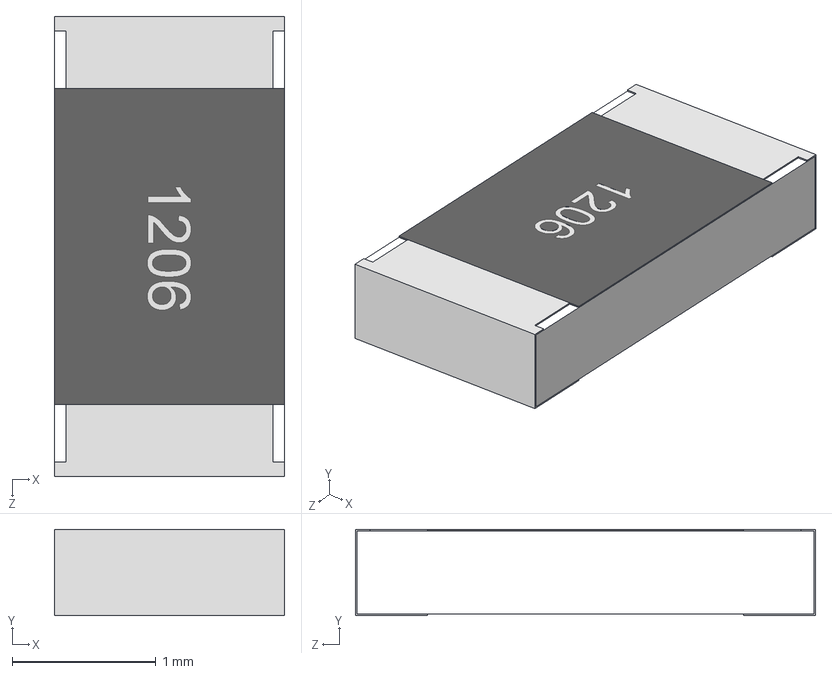
[picture p49: CAD file, 2025-12-09]
AltiumLibrary/steps/res_1206.step
1.60 x 0.6 x 3.20 mm
