bayavahmed/PCB_LIBS/KiCADLibrary/Personal/3DMODELS/BCAAPC.step

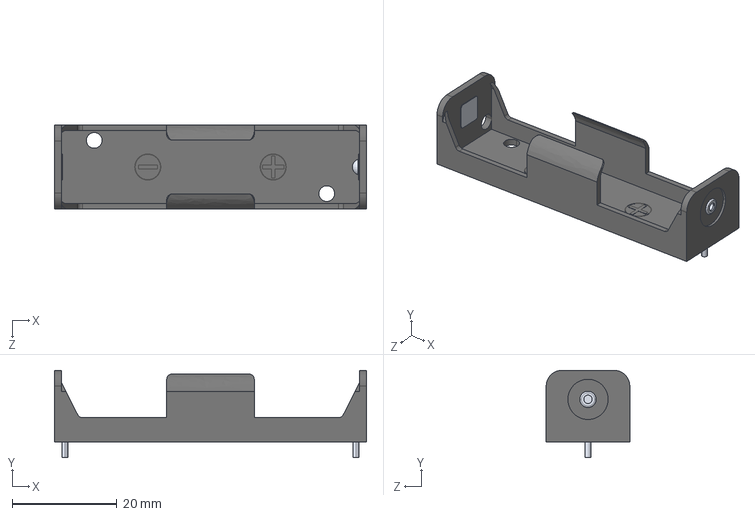
[picture p50: CAD file, 2025-12-09]
KiCADLibrary/Personal/3DMODELS/BCAAPC.step
59.7 x 16.7 x 16.0 mm
