bayavahmed/PCB_LIBS/KiCADLibrary/SamacSys/3D_MODELS/2222.step

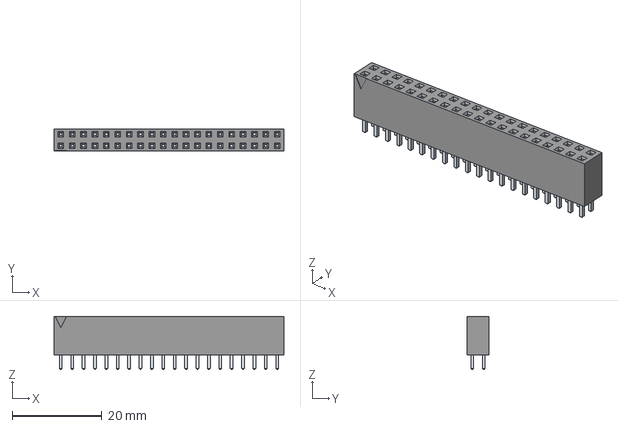
[picture p51: CAD file, 2025-12-09]
KiCADLibrary/SamacSys/3D_MODELS/2222.step
51.3 x 5.00 x 11.9 mm
LeadsArray
