bayavahmed/PCB_LIBS/AltiumLibrary/steps/DCJ250-10-A-K1-K.stp

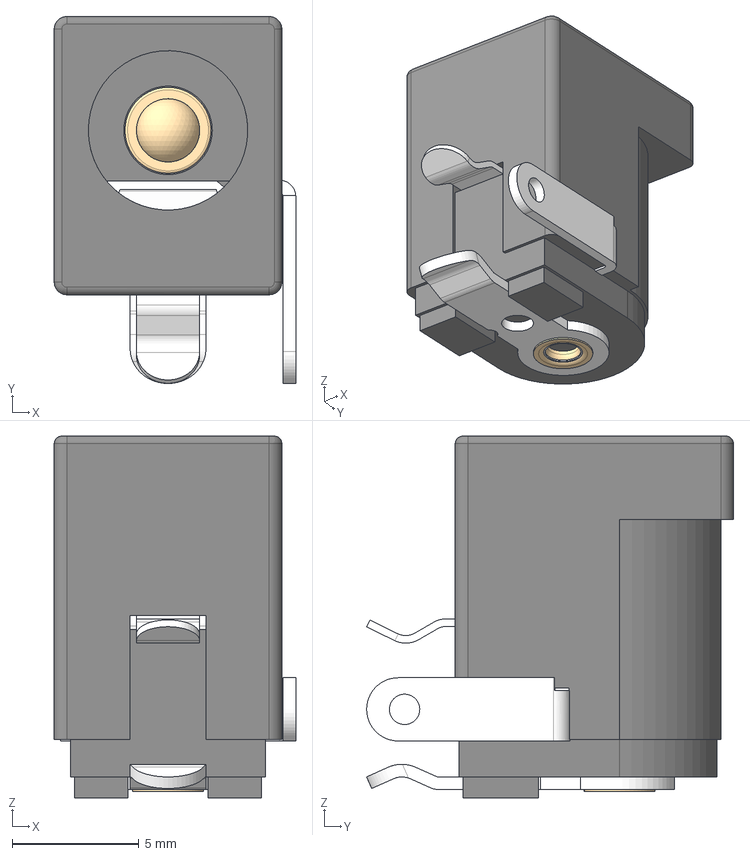
[picture p52: CAD file, 2025-12-09]
AltiumLibrary/steps/DCJ250-10-A-K1-K.stp
9.55 x 14.5 x 14.3 mm
?2??1
?D3y-¨¤-¨¦¨¬3 x 2
?D3y-Dy¡Áa2
?D3y-¨¤-¨¦¨¬1
¨ª1¨¬¡§-¨¤-¨¦¨¬1
