bayavahmed/PCB_LIBS/KiCADLibrary/SamacSys/3D_MODELS/J115F1K1AH12VDCSK2.25.step

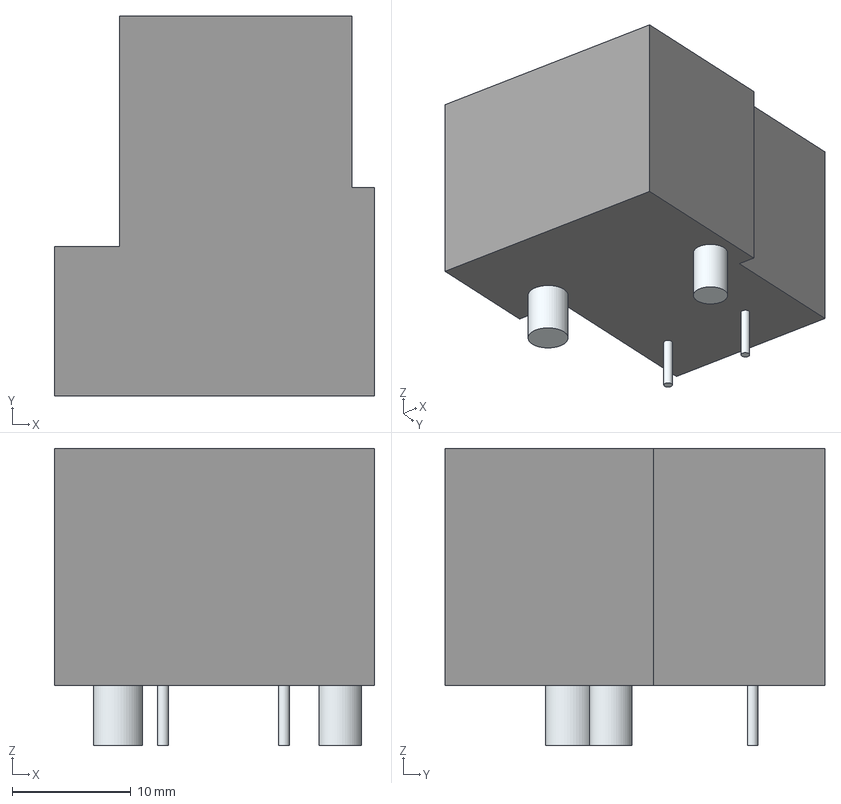
[picture p53: CAD file, 2025-12-09]
KiCADLibrary/SamacSys/3D_MODELS/J115F1K1AH12VDCSK2.25.step
27.0 x 32.0 x 25.1 mm
Leads
