bayavahmed/PCB_LIBS/AltiumLibrary/steps/QFN4_3P2X2P5_MCH-L.step

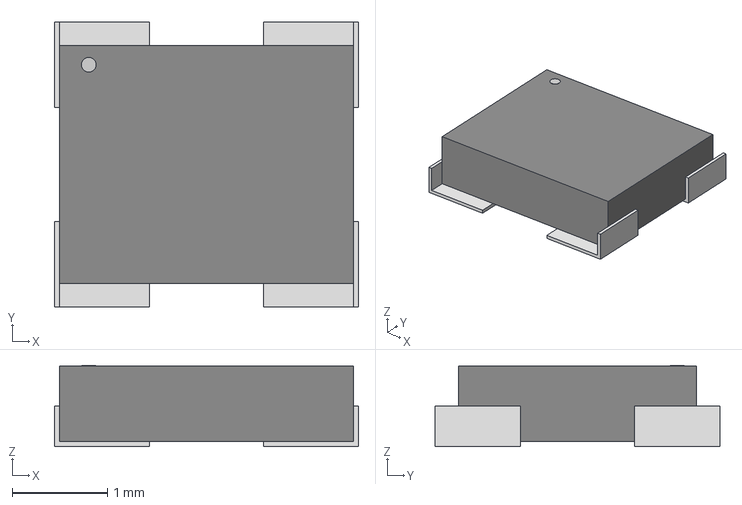
[picture p54: CAD file, 2025-12-09]
AltiumLibrary/steps/QFN4_3P2X2P5_MCH-L.step
3.20 x 3.00 x 0.853 mm
