bayavahmed/PCB_LIBS/KiCADLibrary/Personal/3DMODELS/SW_Push_Tact.STEP

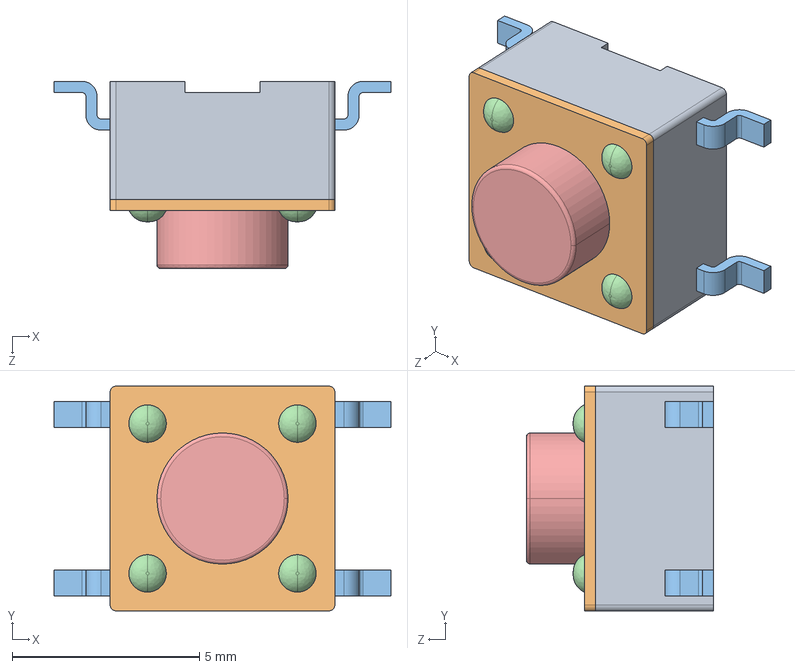
[picture p55: CAD file, 2025-12-09]
KiCADLibrary/Personal/3DMODELS/SW_Push_Tact.STEP
9.00 x 6.00 x 5.00 mm
