bayavahmed/PCB_LIBS/KiCADLibrary/SamacSys/3D_MODELS/DGD0506AM10-13.step

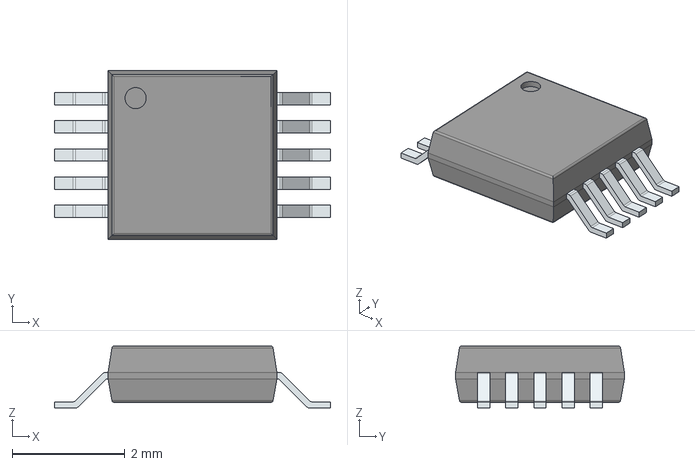
[picture p56: CAD file, 2025-12-09]
KiCADLibrary/SamacSys/3D_MODELS/DGD0506AM10-13.step
4.90 x 3.00 x 1.10 mm
PinsArrayLR
