bayavahmed/PCB_LIBS/AltiumLibrary/steps/7.62mm_4way_90DRC.stp

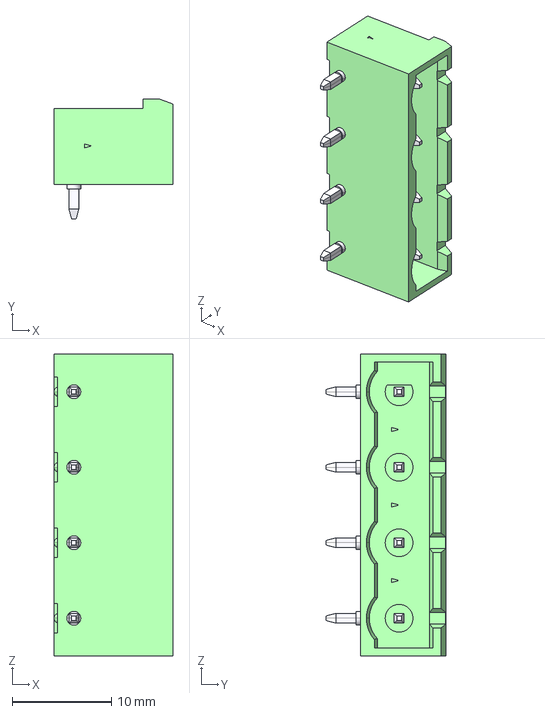
[picture p57: CAD file, 2025-12-09]
AltiumLibrary/steps/7.62mm_4way_90DRC.stp
12.0 x 12.1 x 30.5 mm
