bayavahmed/PCB_LIBS/KiCADLibrary/Personal/3DMODELS/250-205.stp

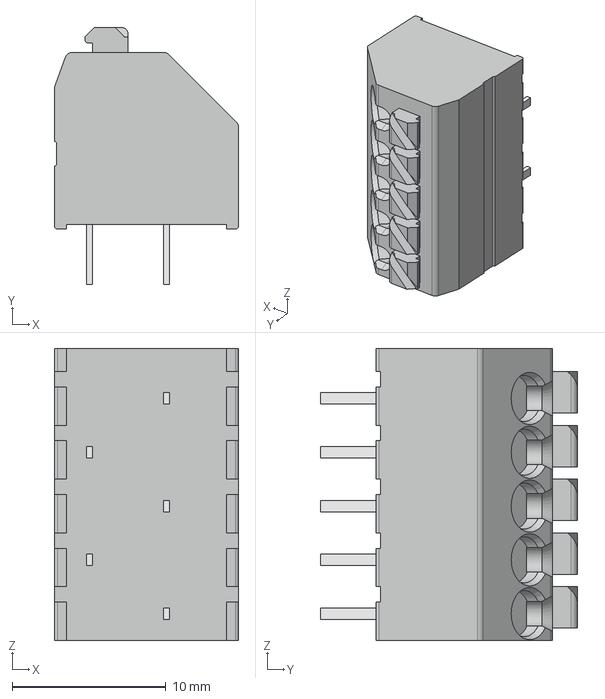
[picture p58: CAD file, 2025-12-09]
KiCADLibrary/Personal/3DMODELS/250-205.stp
12.0 x 16.7 x 19.0 mm
