bayavahmed/PCB_LIBS/AltiumLibrary/steps/TSSOP-16.STEP

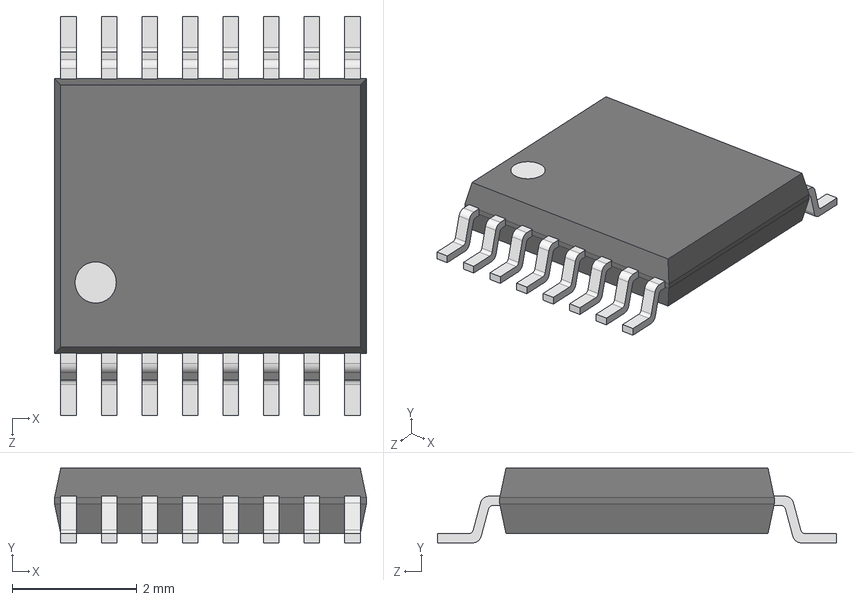
[picture p59: CAD file, 2025-12-09]
AltiumLibrary/steps/TSSOP-16.STEP
5.00 x 1.20 x 6.40 mm
_X2_041A043E0440043F04430441_X0_
_X2_041C04350442043A0430_X0_
_X2_041D043E0436043A0430_X0_ x 8
