bayavahmed/PCB_LIBS/KiCADLibrary/SamacSys/3D_MODELS/ATMEGA16A-AU.step

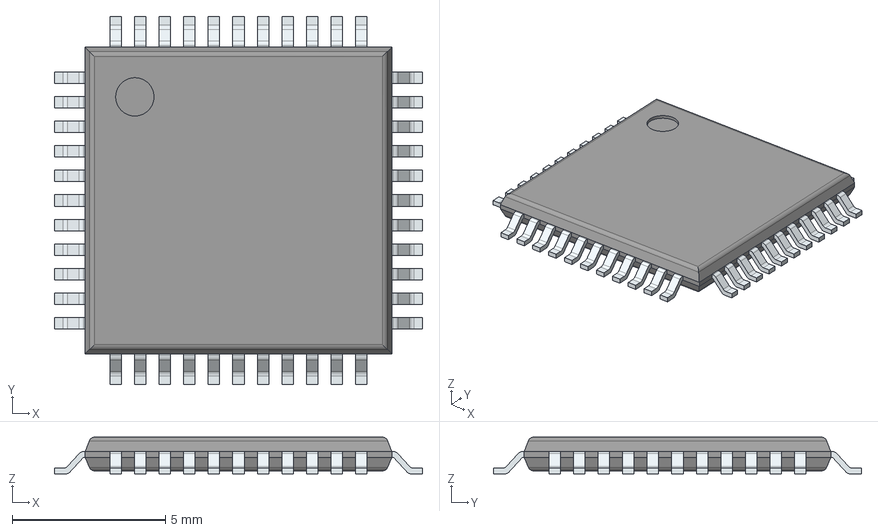
[picture p60: CAD file, 2025-12-09]
KiCADLibrary/SamacSys/3D_MODELS/ATMEGA16A-AU.step
12.0 x 12.0 x 1.20 mm
PinsArrayLR
PinsArrayTB
