bayavahmed/PCB_LIBS/AltiumLibrary/steps/TO-220AB.STEP

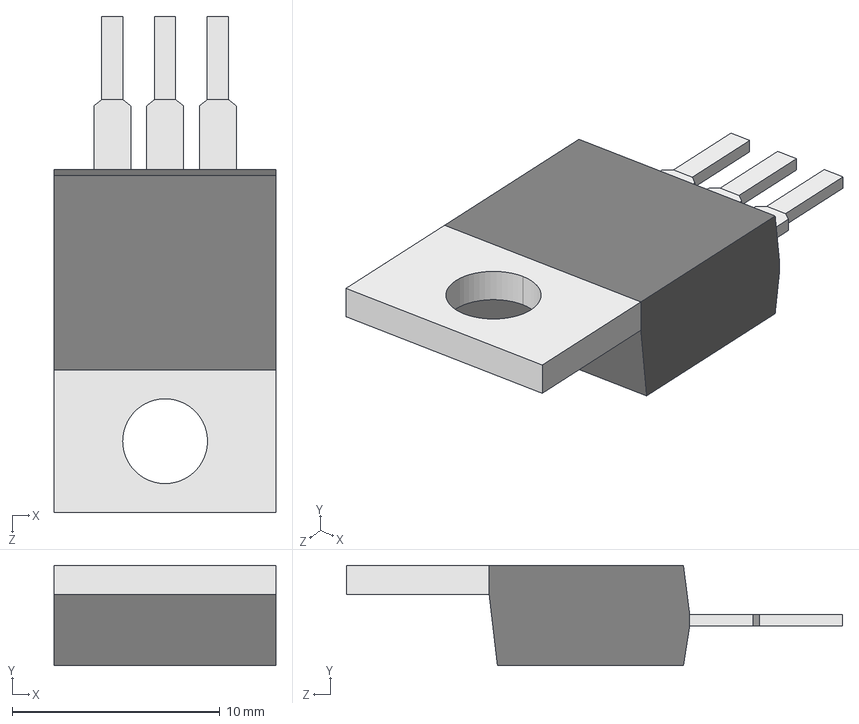
[picture p61: CAD file, 2025-12-09]
AltiumLibrary/steps/TO-220AB.STEP
10.7 x 4.83 x 23.9 mm
User Library-TO-220AB_Box002
User Library-TO-220AB_Box004
User Library-TO-220AB_Box006
User Library-TO-220AB_Cut
User Library-TO-220AB_Chamfer003
User Library-TO-220AB_Chamfer004
User Library-TO-220AB_Chamfer005
User Library-TO-220AB_Cylinder002
User Library-TO-220AB_Cut001
