bayavahmed/PCB_LIBS/KiCADLibrary/Personal/3DMODELS/K15-00A(H).step

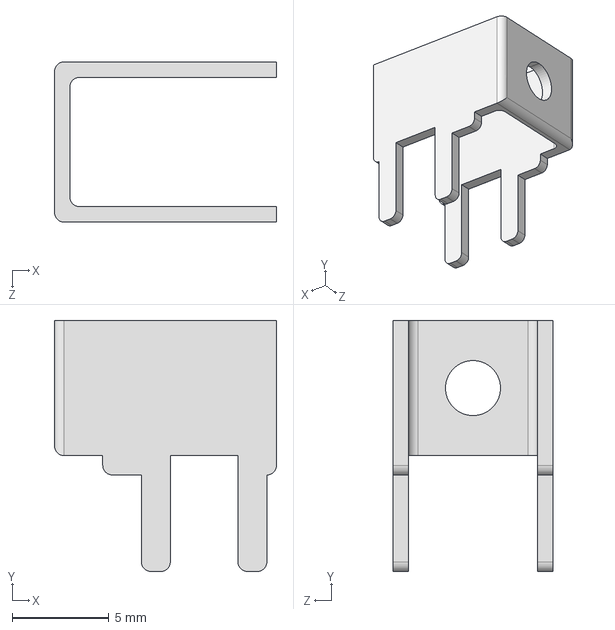
[picture p62: CAD file, 2025-12-09]
KiCADLibrary/Personal/3DMODELS/K15-00A(H).step
11.5 x 13.0 x 8.30 mm
