bayavahmed/PCB_LIBS/KiCADLibrary/SamacSys/3D_MODELS/MS51FB9AE.step

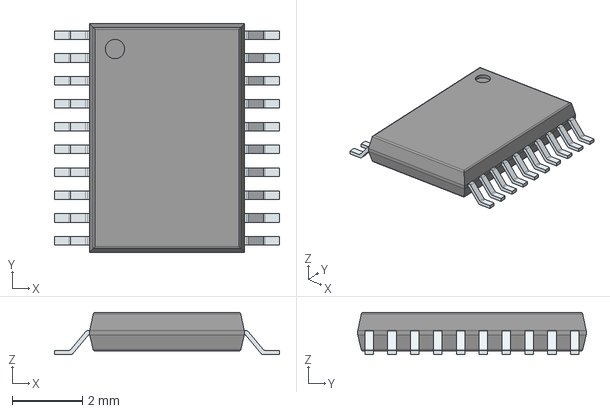
[picture p63: CAD file, 2025-12-09]
KiCADLibrary/SamacSys/3D_MODELS/MS51FB9AE.step
6.40 x 6.50 x 1.20 mm
PinsArrayLR
