bayavahmed/PCB_LIBS/AltiumLibrary/steps/T491C107M006AT.step

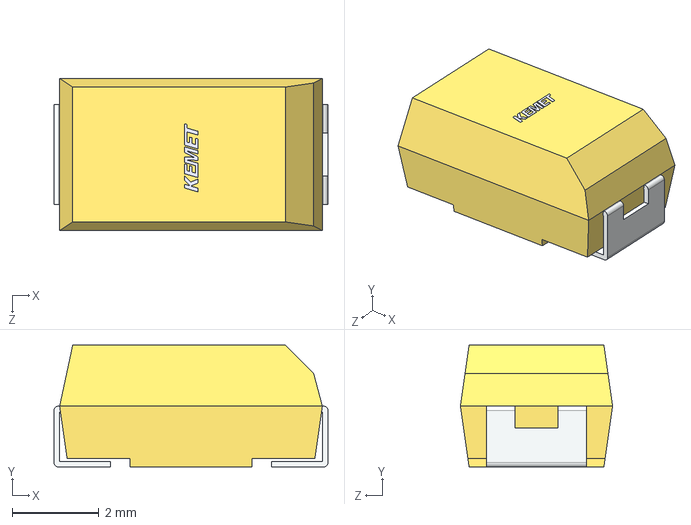
[picture p64: CAD file, 2025-12-09]
AltiumLibrary/steps/T491C107M006AT.step
6.30 x 2.80 x 3.50 mm
