bayavahmed/PCB_LIBS/KiCADLibrary/Personal/3DMODELS/KEYSTONE 2460.step

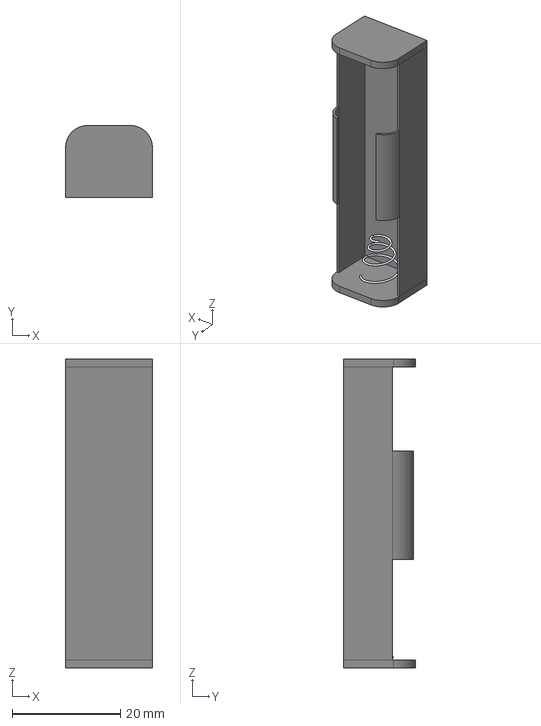
[picture p65: CAD file, 2025-12-09]
KiCADLibrary/Personal/3DMODELS/KEYSTONE 2460.step
16.0 x 13.3 x 57.0 mm
