bayavahmed/PCB_LIBS/AltiumLibrary/steps/DS1040-03 (DIP_switch).stp

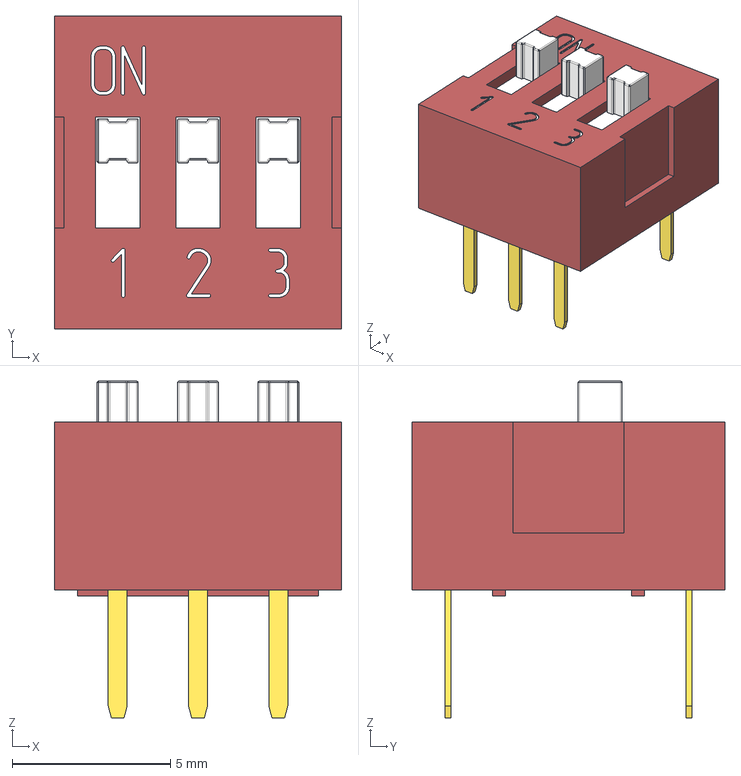
[picture p66: CAD file, 2025-12-09]
AltiumLibrary/steps/DS1040-03 (DIP_switch).stp
9.08 x 9.90 x 10.7 mm
