bayavahmed/PCB_LIBS/KiCADLibrary/Personal/3DMODELS/limitSwitch.step

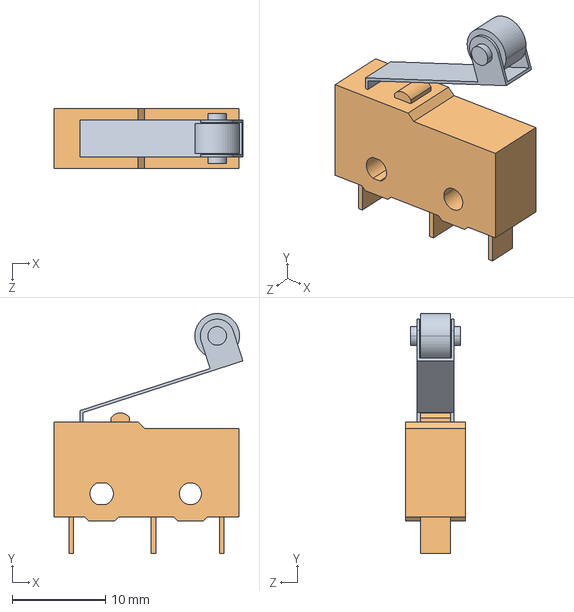
[picture p67: CAD file, 2025-12-09]
KiCADLibrary/Personal/3DMODELS/limitSwitch.step
20.2 x 25.7 x 6.40 mm
SS_5GL2_ACTUATOR
SS_5GL2_BASE
