bayavahmed/PCB_LIBS/AltiumLibrary/steps/PCAP_8x10-ELECT.stp

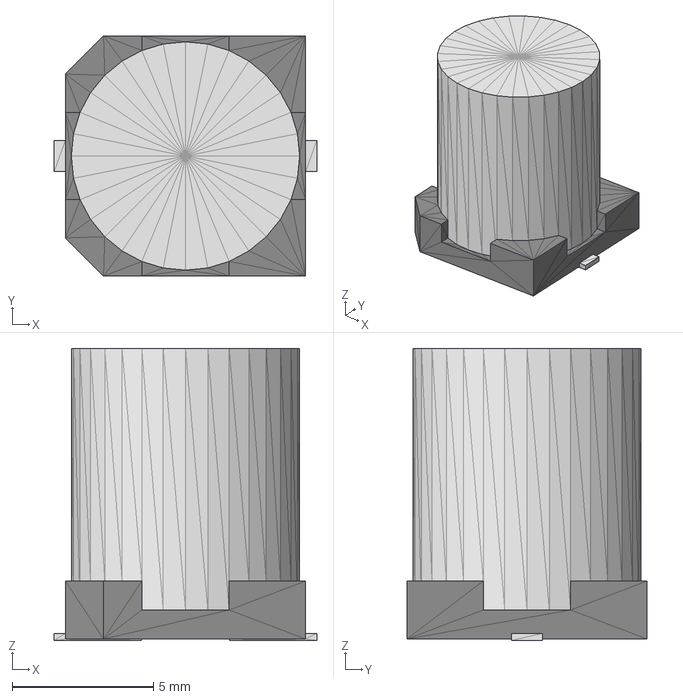
[picture p68: CAD file, 2025-12-09]
AltiumLibrary/steps/PCAP_8x10-ELECT.stp
9.30 x 8.51 x 10.3 mm
