bayavahmed/PCB_LIBS/KiCADLibrary/Personal/3DMODELS/VQFN-32.step

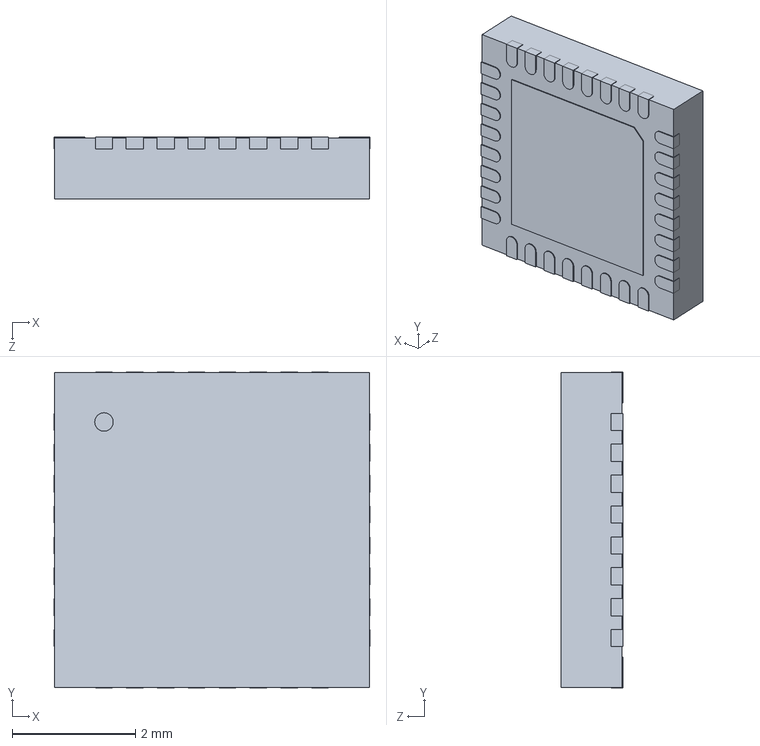
[picture p69: CAD file, 2025-12-09]
KiCADLibrary/Personal/3DMODELS/VQFN-32.step
5.12 x 5.12 x 1.01 mm
