bayavahmed/PCB_LIBS/AltiumLibrary/steps/HDLS_Series_Limit_Switch_LSV7L.stp

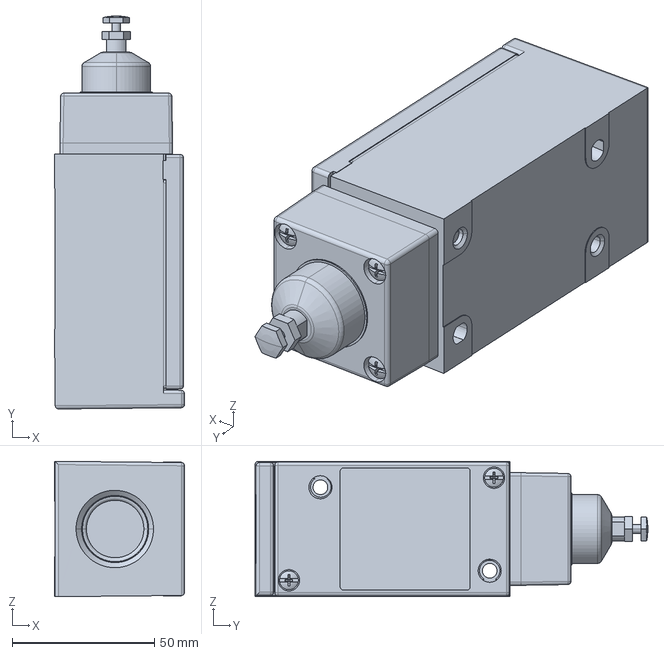
[picture p70: CAD file, 2025-12-09]
AltiumLibrary/steps/HDLS_Series_Limit_Switch_LSV7L.stp
45.7 x 138.2 x 47.6 mm
