bayavahmed/PCB_LIBS/KiCADLibrary/Personal/3DMODELS/quickDisconnectMale.stp

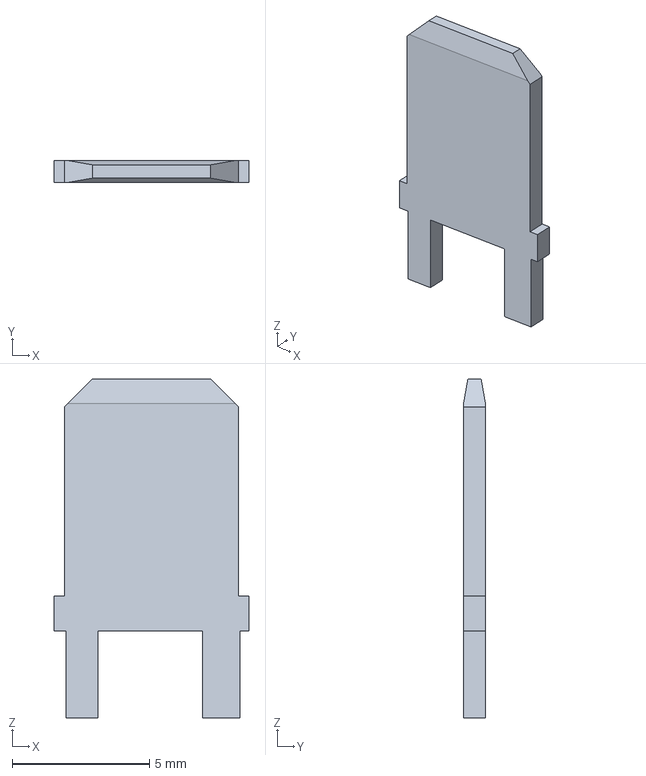
[picture p71: CAD file, 2025-12-09]
KiCADLibrary/Personal/3DMODELS/quickDisconnectMale.stp
7.11 x 0.8 x 12.4 mm
