bayavahmed/PCB_LIBS/KiCADLibrary/SamacSys/3D_MODELS/DMPH6250SQ-7.step

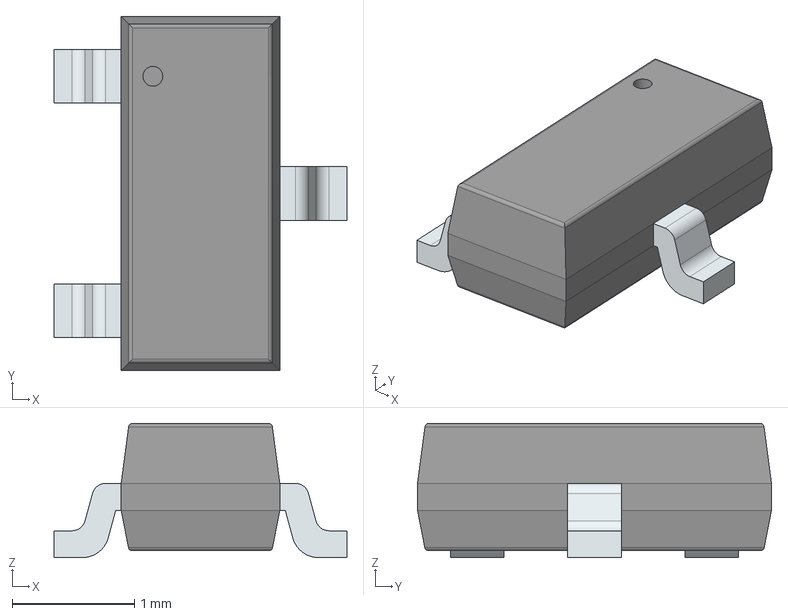
[picture p72: CAD file, 2025-12-09]
KiCADLibrary/SamacSys/3D_MODELS/DMPH6250SQ-7.step
2.40 x 2.90 x 1.10 mm
PinsArrayL
FilletPinR
