bayavahmed/PCB_LIBS/AltiumLibrary/steps/V_155_1C25.step

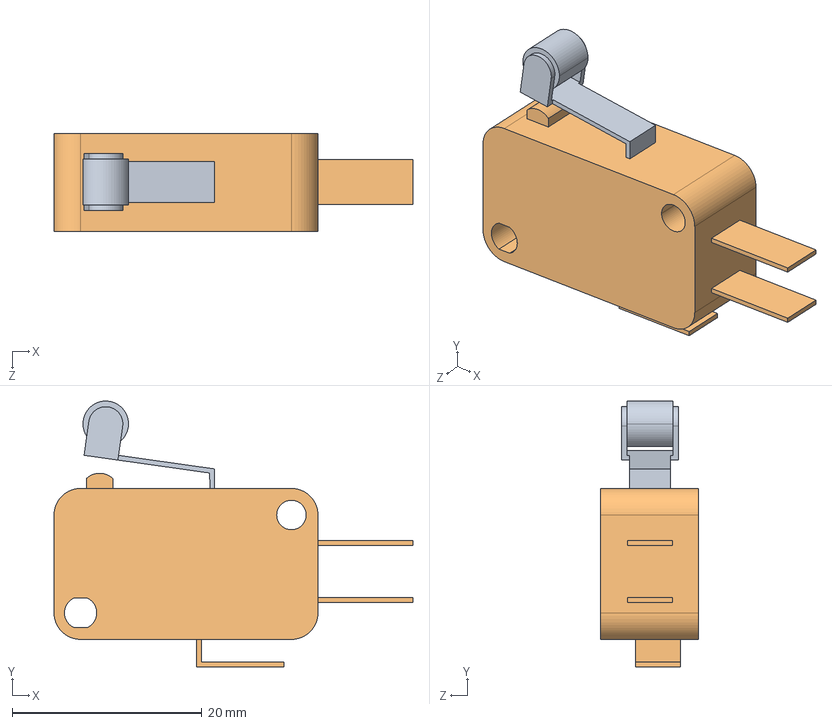
[picture p73: CAD file, 2025-12-09]
AltiumLibrary/steps/V_155_1C25.step
37.8 x 28.0 x 10.3 mm
V_155_1C25_ACTUATOR
V_155_1C25_BASE
