bayavahmed/PCB_LIBS/KiCADLibrary/Personal/3DMODELS/term Block 180 - 8.stp

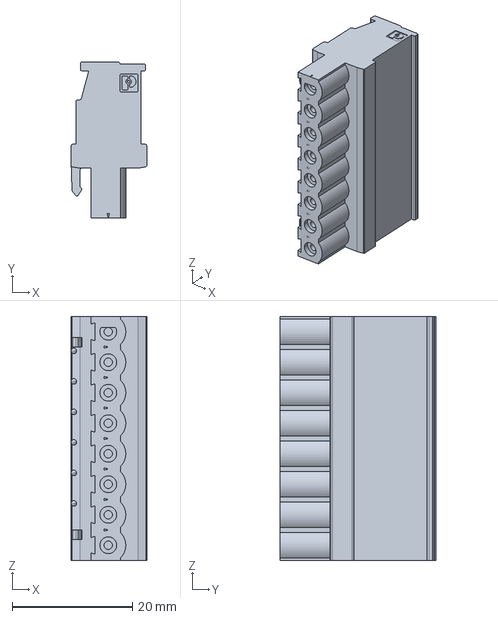
[picture p74: CAD file, 2025-12-09]
KiCADLibrary/Personal/3DMODELS/term Block 180 - 8.stp
12.6 x 26.0 x 40.6 mm
