bayavahmed/PCB_LIBS/KiCADLibrary/SamacSys/3D_MODELS/ECS-240-12-37B2-CKM-TR.step

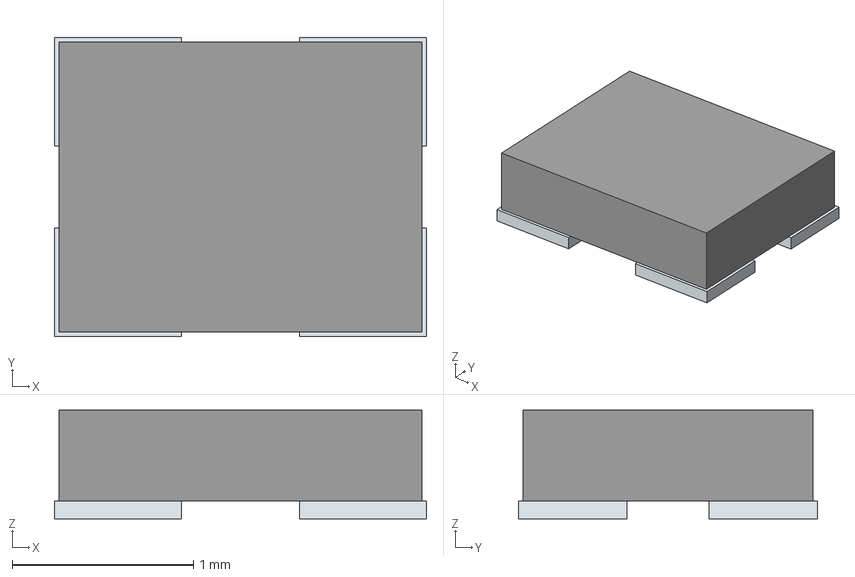
[picture p75: CAD file, 2025-12-09]
KiCADLibrary/SamacSys/3D_MODELS/ECS-240-12-37B2-CKM-TR.step
2.05 x 1.65 x 0.6 mm
Pins
