bayavahmed/PCB_LIBS/AltiumLibrary/steps/E_2750-2210_03new.STEP

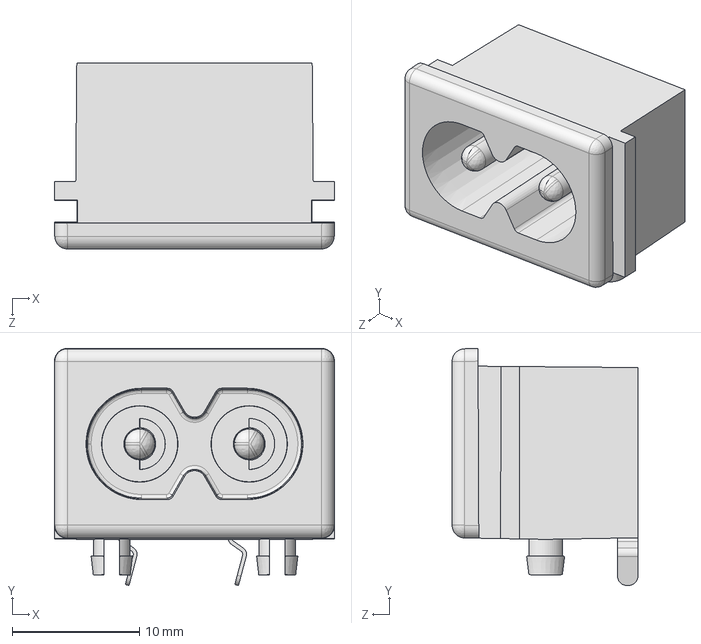
[picture p76: CAD file, 2025-12-09]
AltiumLibrary/steps/E_2750-2210_03new.STEP
22.0 x 18.6 x 14.6 mm
