bayavahmed/PCB_LIBS/KiCADLibrary/Personal/3DMODELS/oled091.step

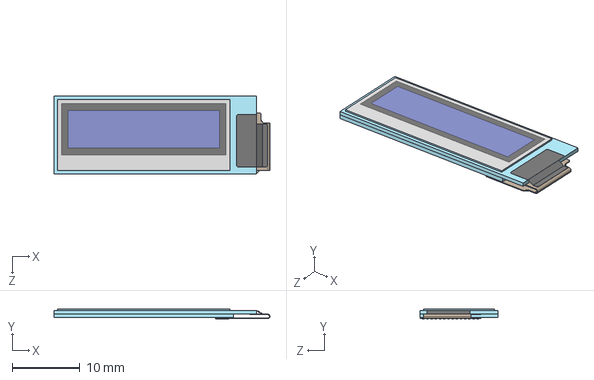
[picture p77: CAD file, 2025-12-09]
KiCADLibrary/Personal/3DMODELS/oled091.step
32.0 x 1.42 x 11.5 mm
