bayavahmed/PCB_LIBS/KiCADLibrary/SamacSys/3D_MODELS/ADUM3190WSRQZ.step

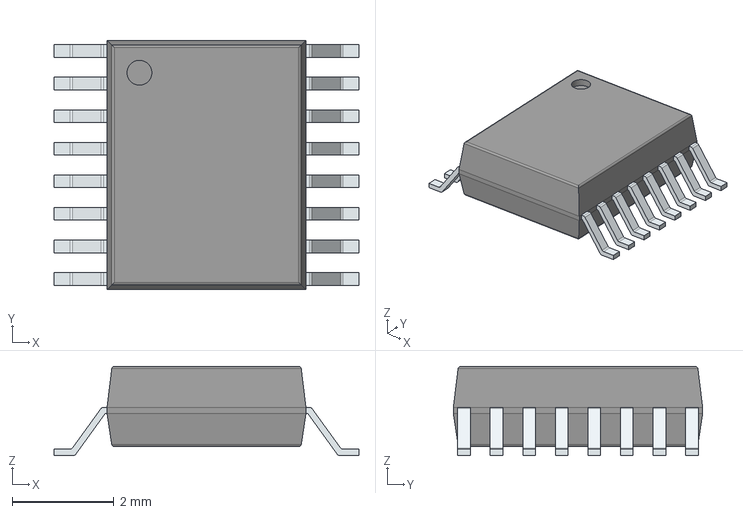
[picture p78: CAD file, 2025-12-09]
KiCADLibrary/SamacSys/3D_MODELS/ADUM3190WSRQZ.step
6.00 x 4.90 x 1.75 mm
PinsArrayLR
