bayavahmed/PCB_LIBS/AltiumLibrary/steps/socket_ic_8pin 0_3inch 2_54mm IC DIP Socket.step

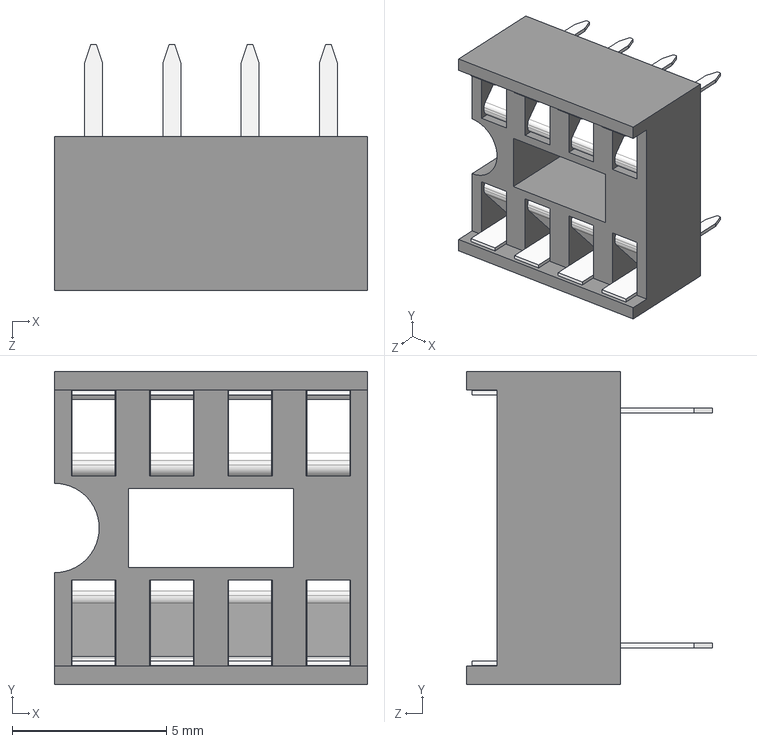
[picture p79: CAD file, 2025-12-09]
AltiumLibrary/steps/socket_ic_8pin 0_3inch 2_54mm IC DIP Socket.step
10.2 x 10.2 x 8.00 mm
