bayavahmed/PCB_LIBS/KiCADLibrary/Personal/3DMODELS/molex_0039288040.stp

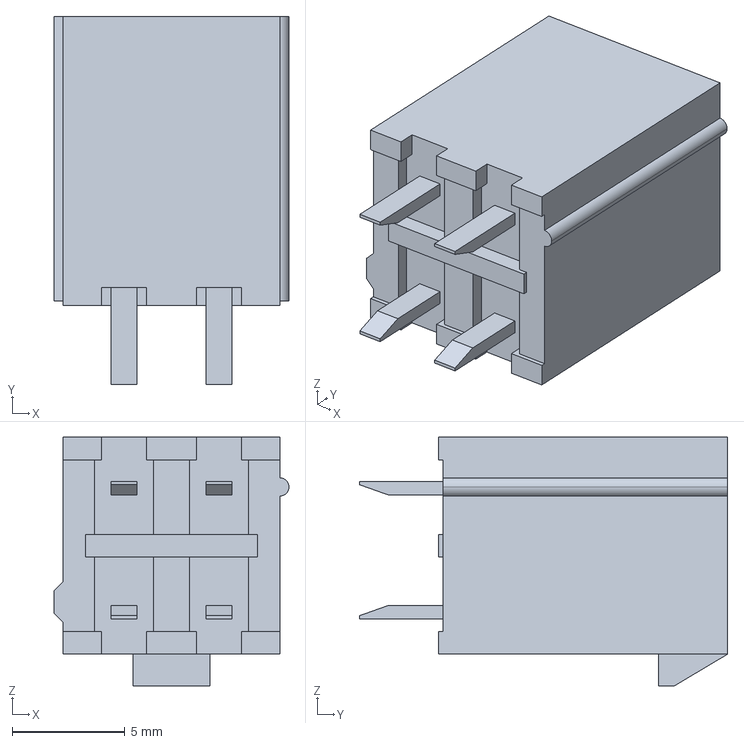
[picture p80: CAD file, 2025-12-09]
KiCADLibrary/Personal/3DMODELS/molex_0039288040.stp
10.4 x 16.3 x 11.0 mm
