bayavahmed/PCB_LIBS/AltiumLibrary/steps/RES_0201.step

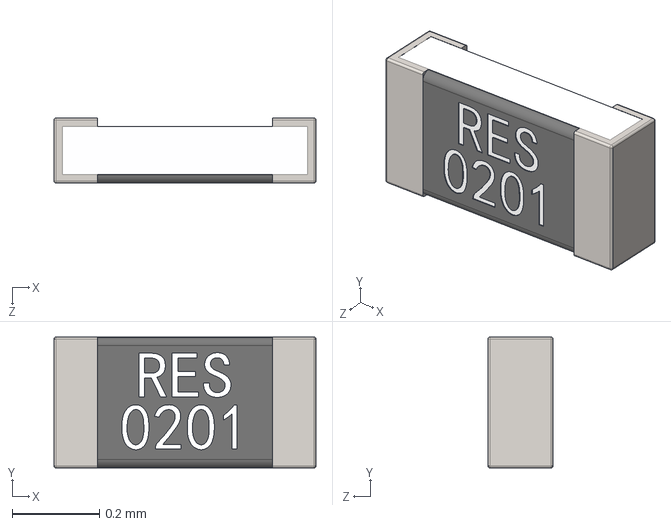
[picture p81: CAD file, 2025-12-09]
AltiumLibrary/steps/RES_0201.step
0.6 x 0.3 x 0.15 mm
