bayavahmed/PCB_LIBS/KiCADLibrary/Personal/3DMODELS/User Library-TB5_08-4R.step

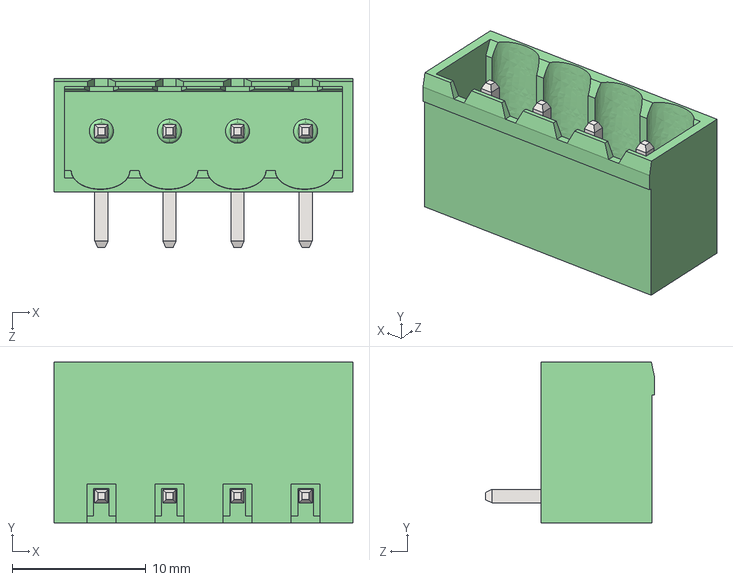
[picture p82: CAD file, 2025-12-09]
KiCADLibrary/Personal/3DMODELS/User Library-TB5_08-4R.step
22.3 x 12.0 x 12.7 mm
