bayavahmed/PCB_LIBS/AltiumLibrary/steps/cap_6.3x7.7.step

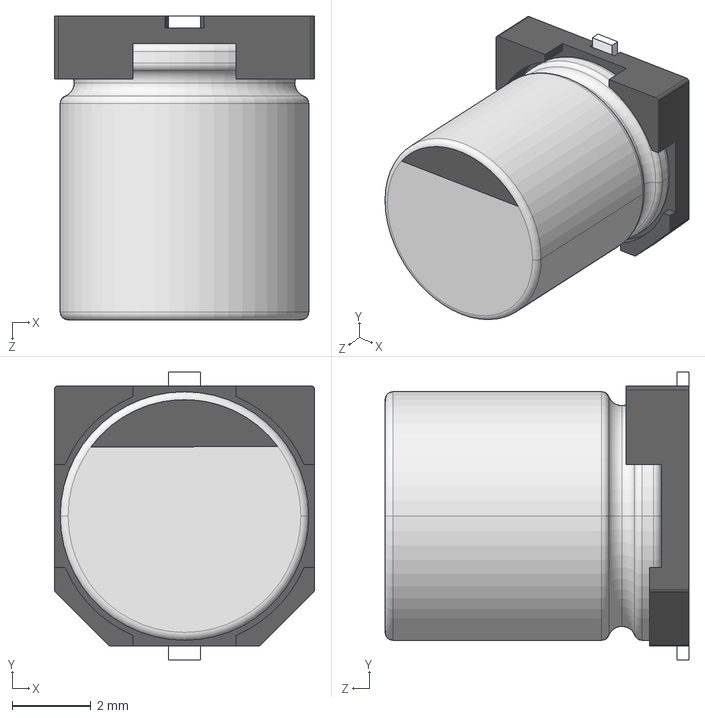
[picture p83: CAD file, 2025-12-09]
AltiumLibrary/steps/cap_6.3x7.7.step
6.60 x 7.30 x 7.70 mm
