bayavahmed/PCB_LIBS/KiCADLibrary/Personal/3DMODELS/term Block 180 - 2b.stp

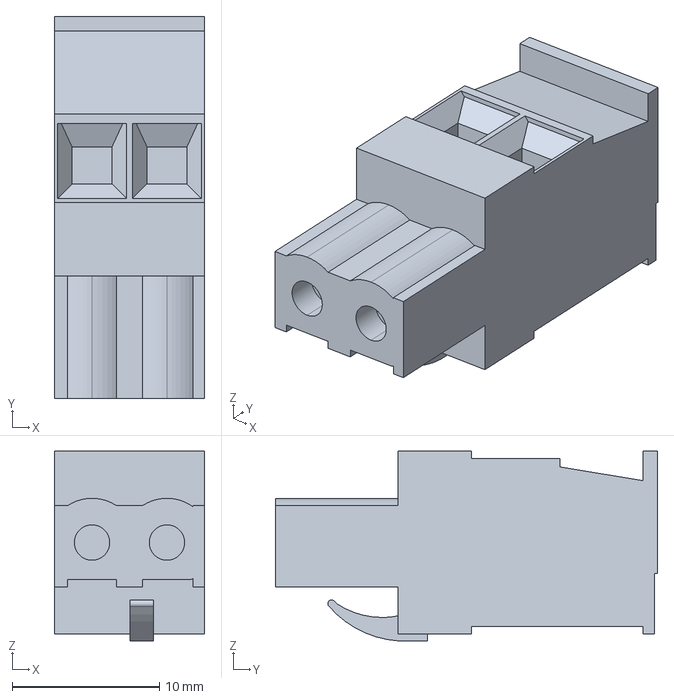
[picture p84: CAD file, 2025-12-09]
KiCADLibrary/Personal/3DMODELS/term Block 180 - 2b.stp
10.2 x 25.9 x 12.9 mm
