bayavahmed/PCB_LIBS/KiCADLibrary/SamacSys/3D_MODELS/SZESD7462N2T5G.step

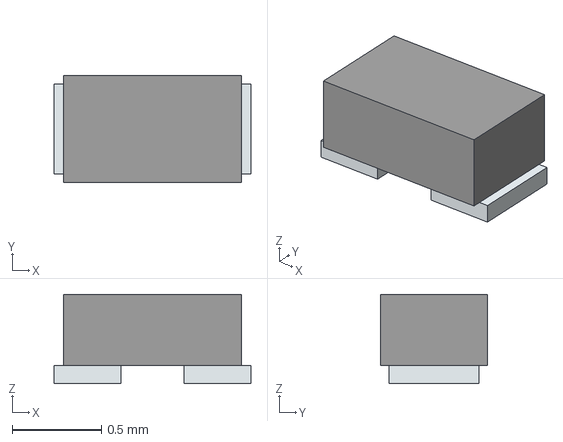
[picture p85: CAD file, 2025-12-09]
KiCADLibrary/SamacSys/3D_MODELS/SZESD7462N2T5G.step
1.11 x 0.6 x 0.5 mm
Pins
