bayavahmed/PCB_LIBS/AltiumLibrary/steps/G5LE_1A4.step

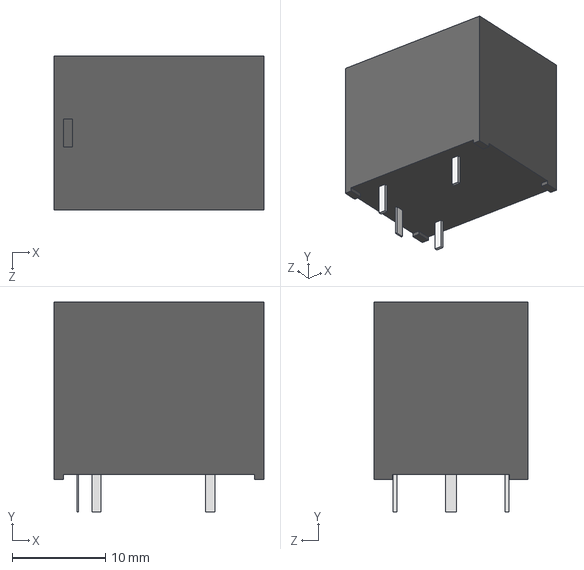
[picture p86: CAD file, 2025-12-09]
AltiumLibrary/steps/G5LE_1A4.step
22.5 x 22.5 x 16.5 mm
