bayavahmed/PCB_LIBS/AltiumLibrary/steps/Nextion 2.4 v15.step

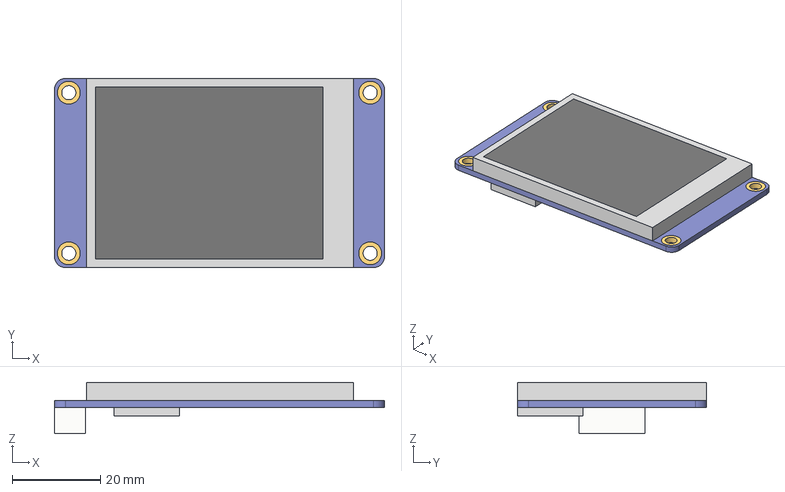
[picture p87: CAD file, 2025-12-09]
AltiumLibrary/steps/Nextion 2.4 v15.step
75.0 x 43.0 x 11.7 mm
