bayavahmed/PCB_LIBS/KiCADLibrary/Personal/3DMODELS/SO-8FL.STEP

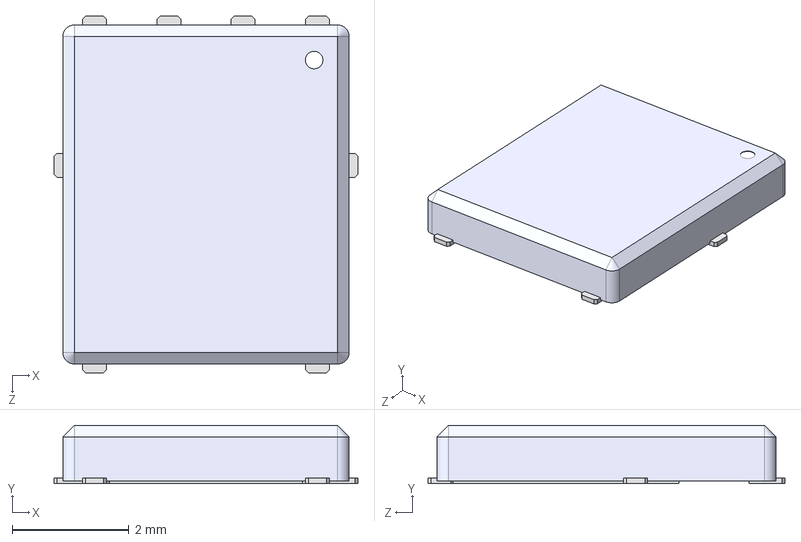
[picture p88: CAD file, 2025-12-09]
KiCADLibrary/Personal/3DMODELS/SO-8FL.STEP
5.20 x 1.00 x 6.10 mm
