bayavahmed/PCB_LIBS/AltiumLibrary/steps/SOIC28-300.step

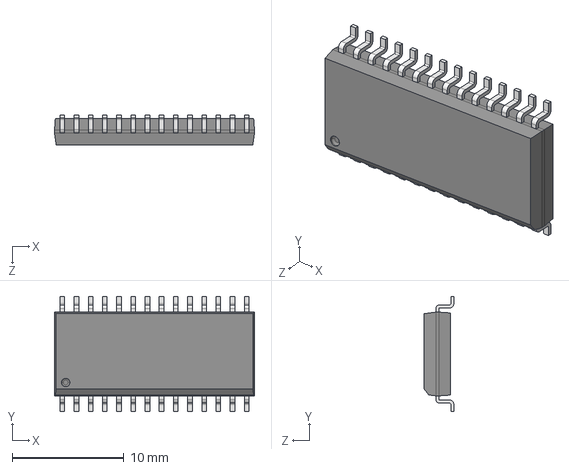
[picture p89: CAD file, 2025-12-09]
AltiumLibrary/steps/SOIC28-300.step
17.9 x 10.3 x 2.65 mm
