bayavahmed/PCB_LIBS/KiCADLibrary/Personal/3DMODELS/User Library-TB5_08-6R.step

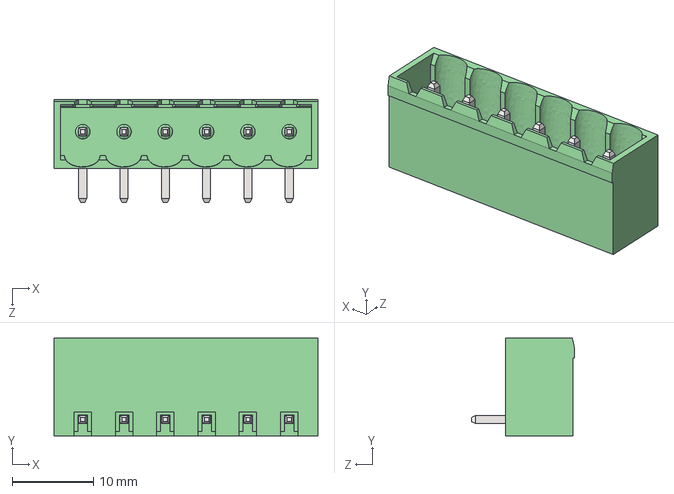
[picture p90: CAD file, 2025-12-09]
KiCADLibrary/Personal/3DMODELS/User Library-TB5_08-6R.step
32.5 x 12.0 x 12.7 mm
