bayavahmed/PCB_LIBS/AltiumLibrary/steps/DFN8_3x3MC_MCH-M.step

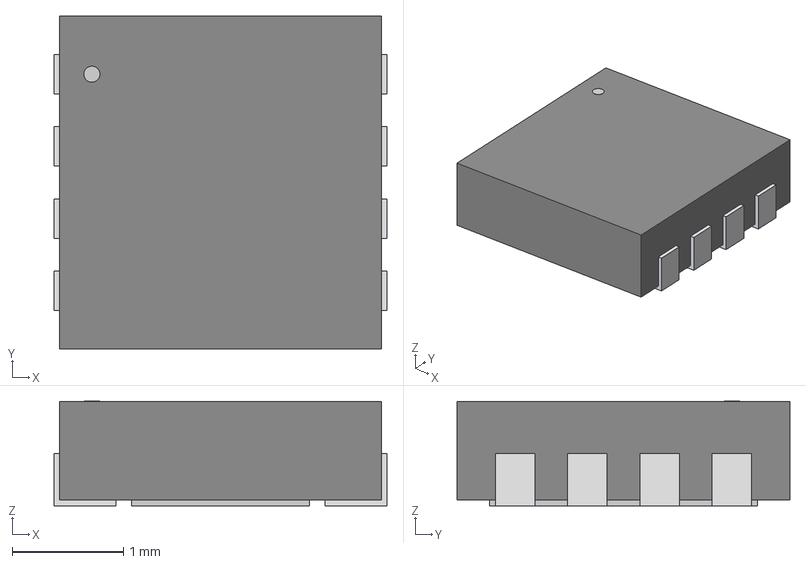
[picture p91: CAD file, 2025-12-09]
AltiumLibrary/steps/DFN8_3x3MC_MCH-M.step
3.00 x 3.00 x 0.942 mm
