bayavahmed/PCB_LIBS/KiCADLibrary/Personal/3DMODELS/pj-3062-hd-r.stp

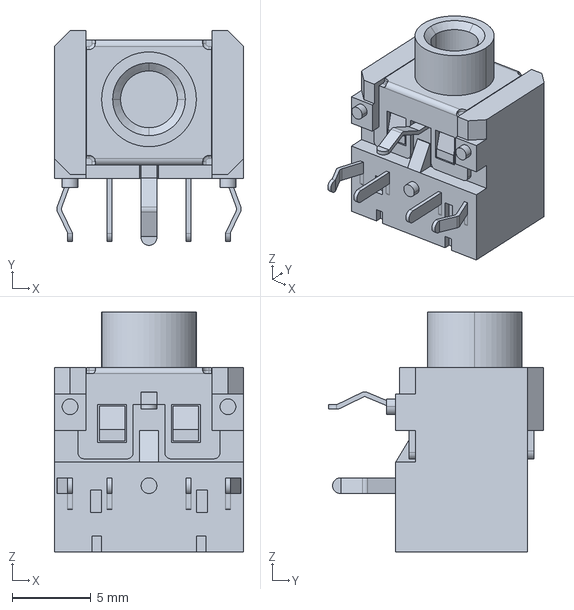
[picture p92: CAD file, 2025-12-09]
KiCADLibrary/Personal/3DMODELS/pj-3062-hd-r.stp
12.0 x 13.6 x 15.2 mm
