bayavahmed/PCB_LIBS/AltiumLibrary/steps/MSOP-8_MS_LIT-L.step

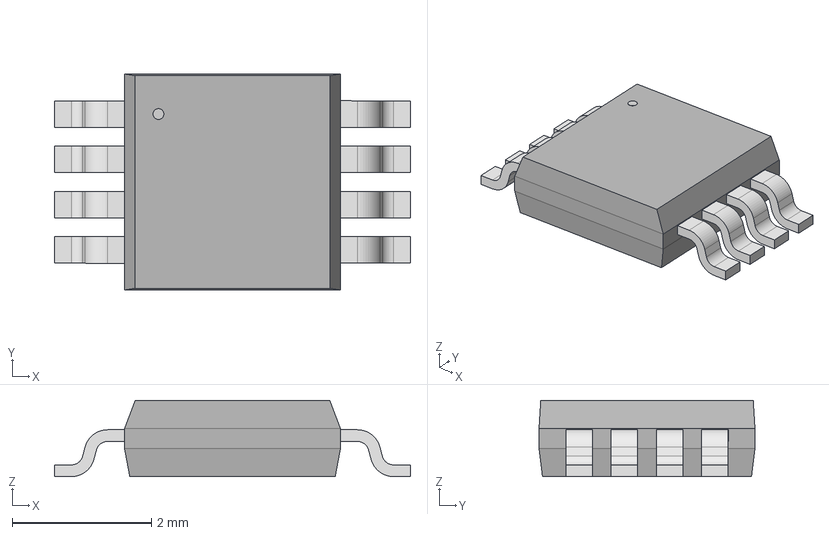
[picture p93: CAD file, 2025-12-09]
AltiumLibrary/steps/MSOP-8_MS_LIT-L.step
5.11 x 3.10 x 1.09 mm
