bayavahmed/PCB_LIBS/KiCADLibrary/Personal/3DMODELS/2.8TFT_DWIN.stp

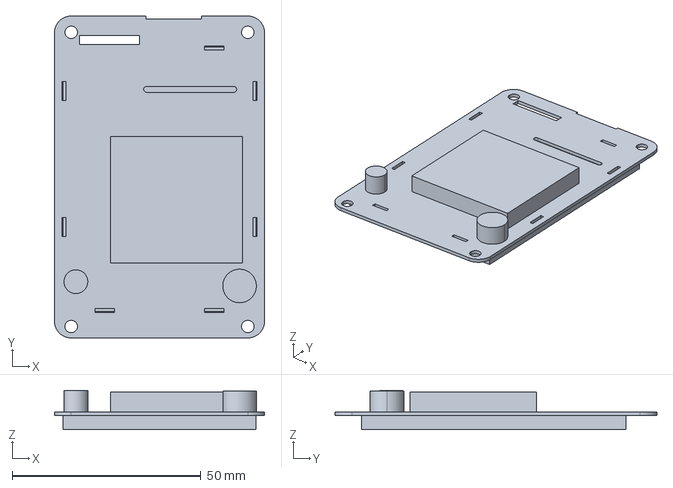
[picture p94: CAD file, 2025-12-09]
KiCADLibrary/Personal/3DMODELS/2.8TFT_DWIN.stp
55.6 x 85.2 x 10.4 mm
