bayavahmed/PCB_LIBS/AltiumLibrary/steps/MOLEX_FEMALE_022152056.stp

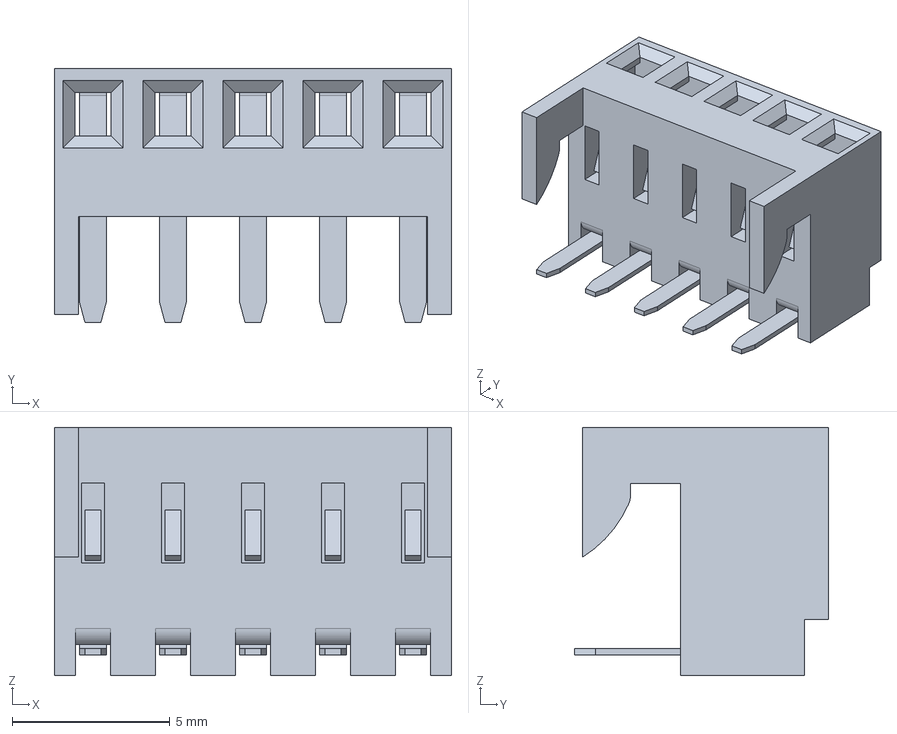
[picture p95: CAD file, 2025-12-09]
AltiumLibrary/steps/MOLEX_FEMALE_022152056.stp
12.6 x 8.05 x 7.87 mm
