bayavahmed/PCB_LIBS/AltiumLibrary/steps/pxc_1755778_04_MSTBVA-2-5-6-G-5-08_3D.stp

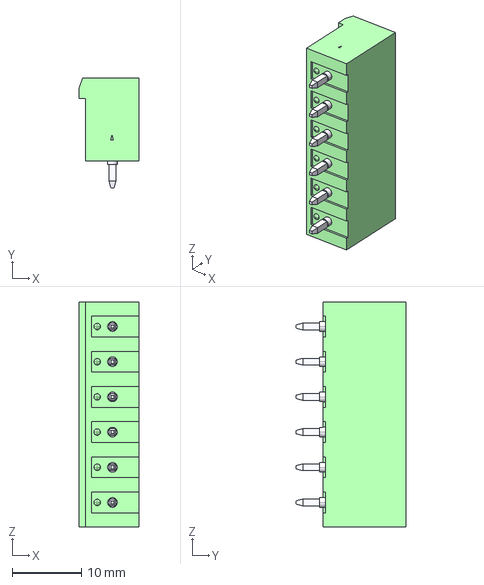
[picture p97: CAD file, 2025-12-09]
AltiumLibrary/steps/pxc_1755778_04_MSTBVA-2-5-6-G-5-08_3D.stp
8.60 x 15.9 x 32.5 mm
