bayavahmed/PCB_LIBS/KiCADLibrary/Personal/3DMODELS/HH-044.STEP

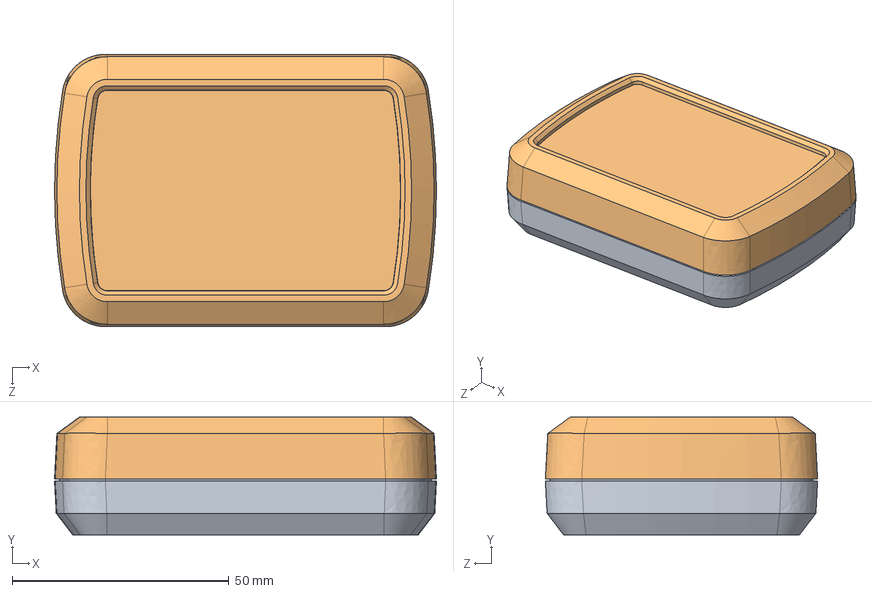
[picture p98: CAD file, 2025-12-09]
KiCADLibrary/Personal/3DMODELS/HH-044.STEP
88.1 x 27.2 x 62.8 mm
HH-044-P-2
HH-044-P-1
