bayavahmed/PCB_LIBS/AltiumLibrary/steps/LQFP-32-M.step

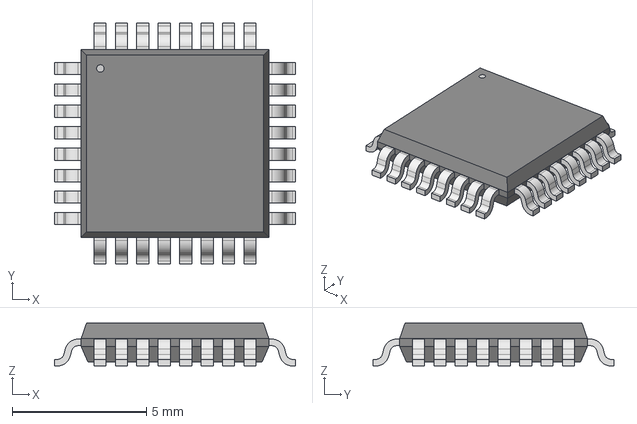
[picture p99: CAD file, 2025-12-09]
AltiumLibrary/steps/LQFP-32-M.step
8.99 x 8.99 x 1.60 mm
