bayavahmed/PCB_LIBS/KiCADLibrary/Personal/3DMODELS/heatsink.stp

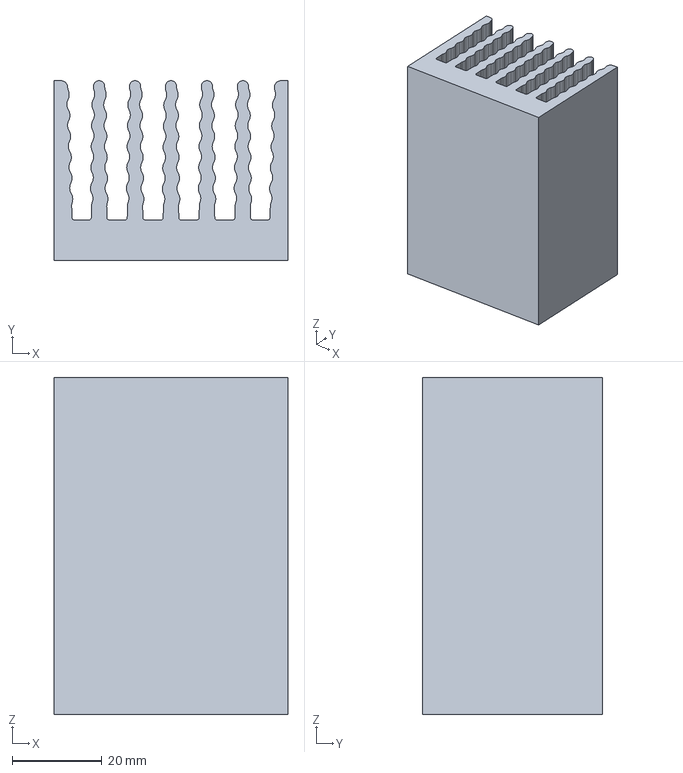
[picture p100: CAD file, 2025-12-09]
KiCADLibrary/Personal/3DMODELS/heatsink.stp
52.0 x 40.0 x 75.0 mm
