bayavahmed/PCB_LIBS/AltiumLibrary/steps/206-6.STEP

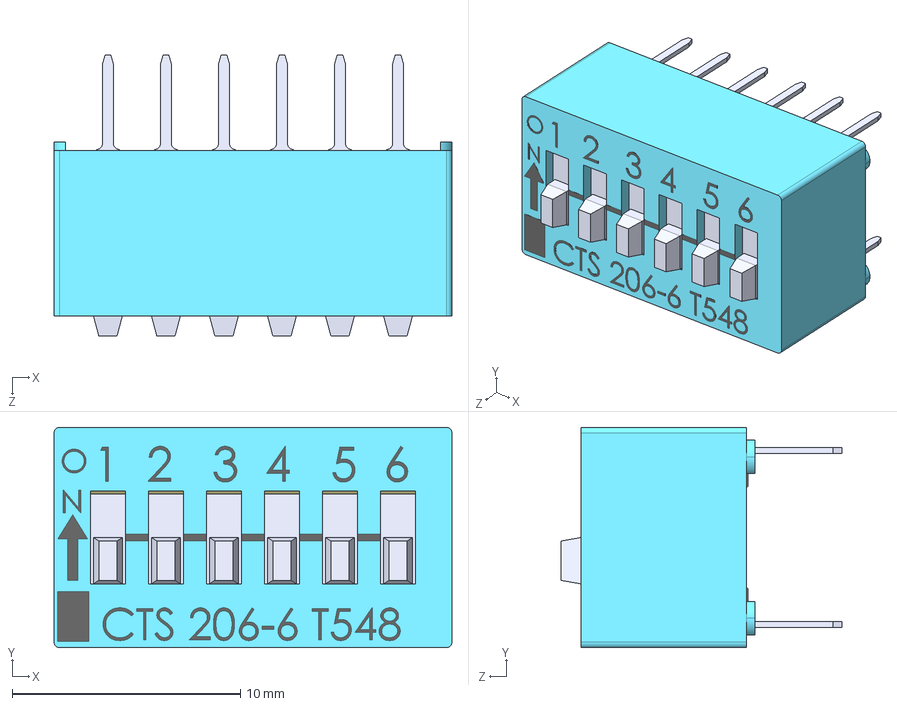
[picture p101: CAD file, 2025-12-09]
AltiumLibrary/steps/206-6.STEP
17.4 x 9.65 x 12.3 mm
206-40-036(for 206006)
206-93&94-6pole
