bayavahmed/PCB_LIBS/KiCADLibrary/Personal/3DMODELS/B1212S-2W.step

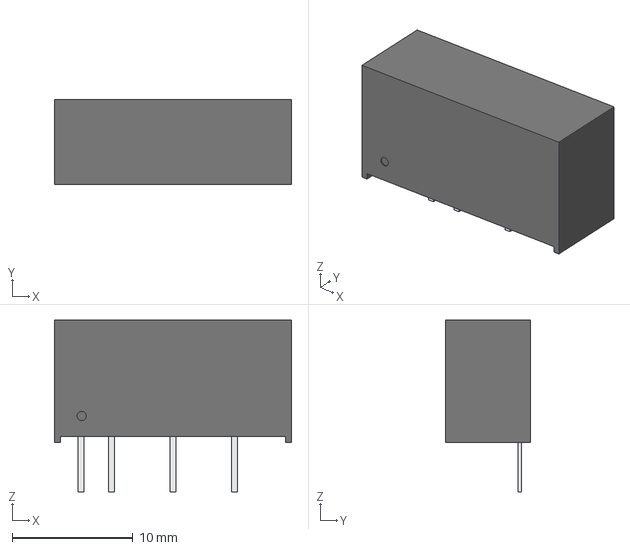
[picture p102: CAD file, 2025-12-09]
KiCADLibrary/Personal/3DMODELS/B1212S-2W.step
19.6 x 7.05 x 14.3 mm
