bayavahmed/PCB_LIBS/AltiumLibrary/steps/CAPPR500-1250x2000.step

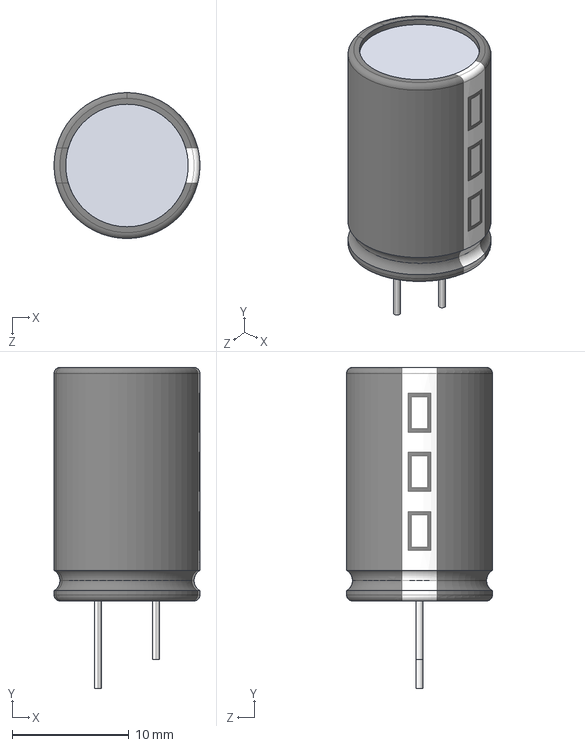
[picture p103: CAD file, 2025-12-09]
AltiumLibrary/steps/CAPPR500-1250x2000.step
12.5 x 27.5 x 12.5 mm
