bayavahmed/PCB_LIBS/KiCADLibrary/Personal/3DMODELS/250-208.stp

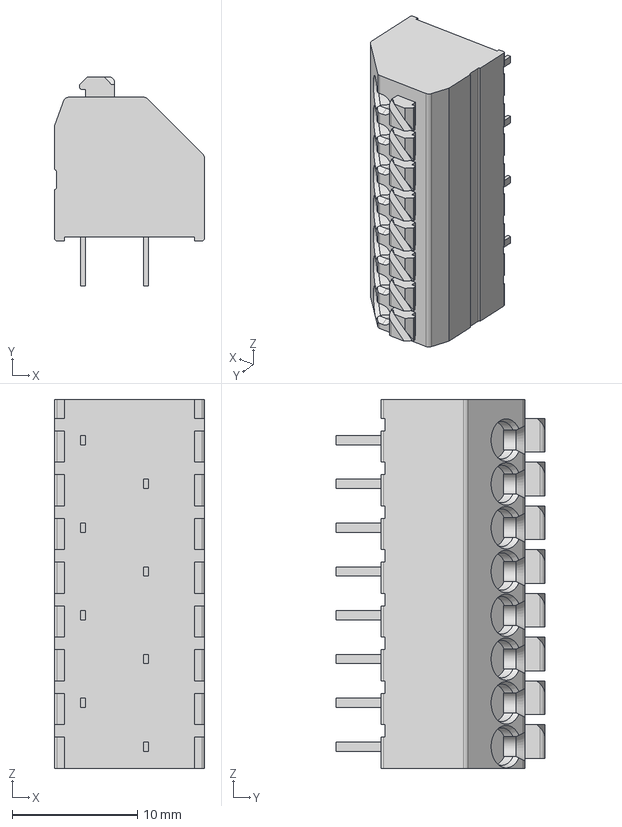
[picture p104: CAD file, 2025-12-09]
KiCADLibrary/Personal/3DMODELS/250-208.stp
12.0 x 16.7 x 29.5 mm
