bayavahmed/PCB_LIBS/KiCADLibrary/Personal/3DMODELS/molex_0039288100.stp

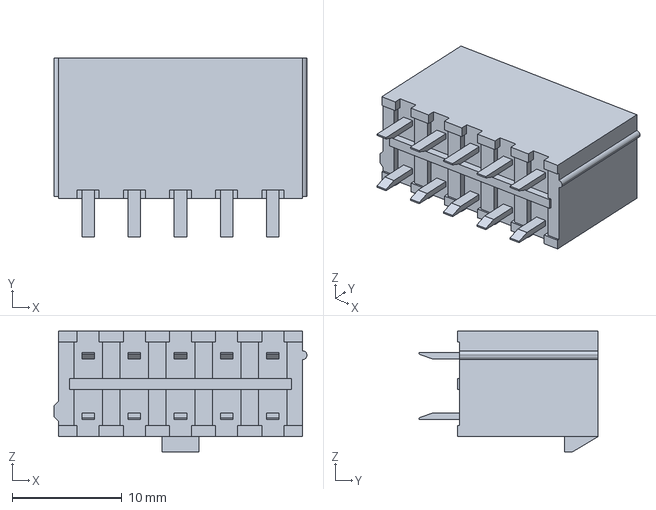
[picture p105: CAD file, 2025-12-09]
KiCADLibrary/Personal/3DMODELS/molex_0039288100.stp
23.0 x 16.3 x 11.0 mm
