bayavahmed/PCB_LIBS/KiCADLibrary/Personal/3DMODELS/Fuse_8.5x4.STEP

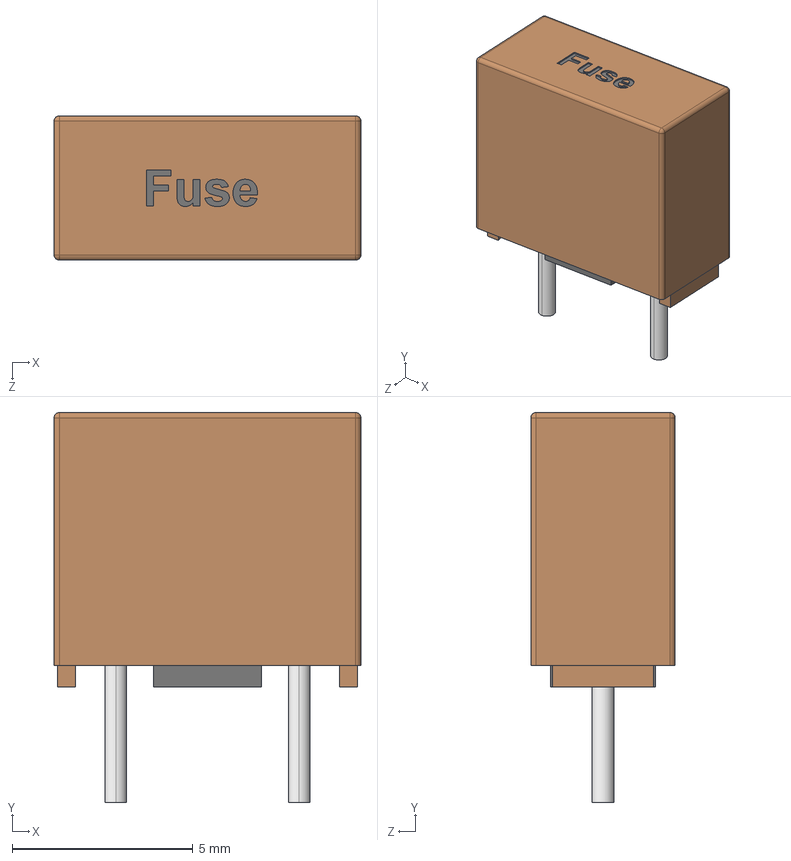
[picture p106: CAD file, 2025-12-09]
KiCADLibrary/Personal/3DMODELS/Fuse_8.5x4.STEP
8.50 x 10.8 x 4.00 mm
