bayavahmed/PCB_LIBS/AltiumLibrary/steps/pxc_1715789_02_MKDS-1-5-8-5-08_3D.stp

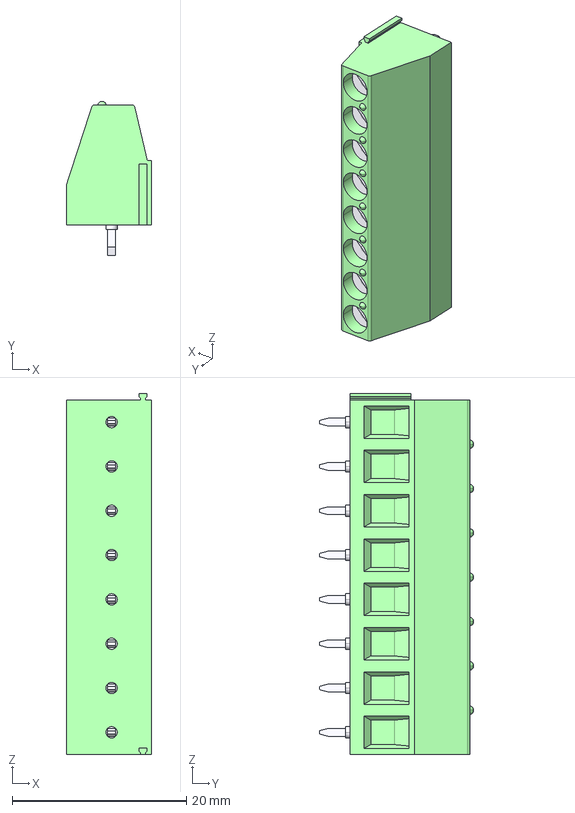
[picture p107: CAD file, 2025-12-09]
AltiumLibrary/steps/pxc_1715789_02_MKDS-1-5-8-5-08_3D.stp
9.80 x 17.7 x 41.4 mm
