bayavahmed/PCB_LIBS/AltiumLibrary/steps/C0402C104Z4VACTU.step

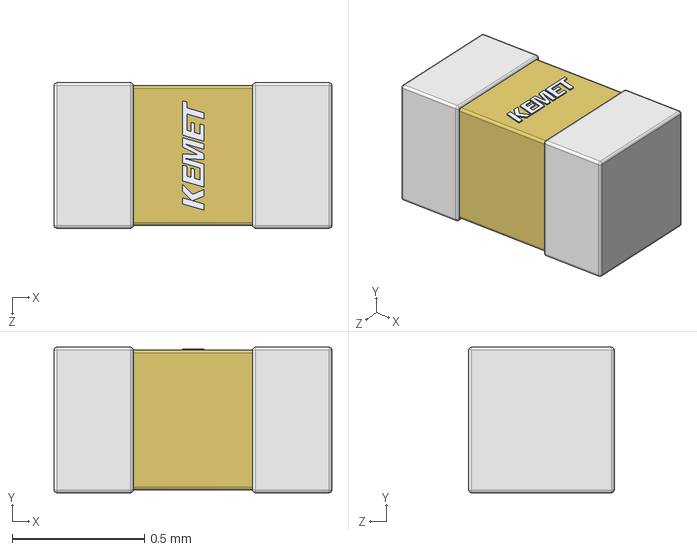
[picture p108: CAD file, 2025-12-09]
AltiumLibrary/steps/C0402C104Z4VACTU.step
1.05 x 0.55 x 0.55 mm
