bayavahmed/PCB_LIBS/KiCADLibrary/Personal/3DMODELS/ptc5.STEP

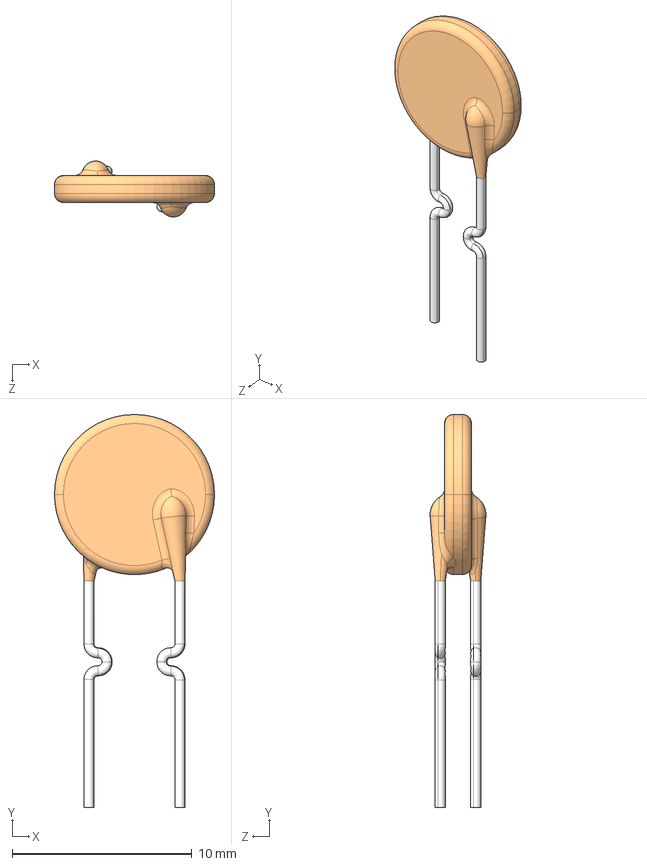
[picture p109: CAD file, 2025-12-09]
KiCADLibrary/Personal/3DMODELS/ptc5.STEP
8.90 x 21.9 x 3.11 mm
