bayavahmed/PCB_LIBS/AltiumLibrary/steps/pxc_1727010_02_MKDS-1-2-3-81_3D.stp

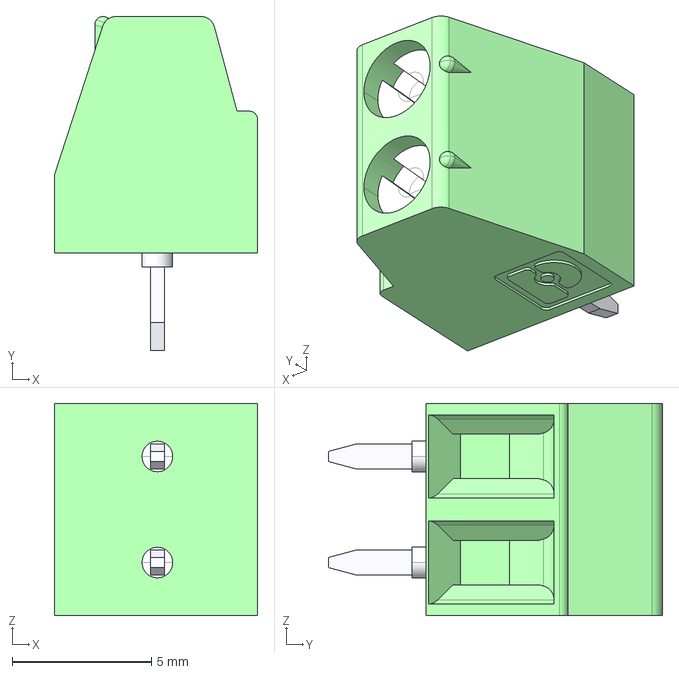
[picture p110: CAD file, 2025-12-09]
AltiumLibrary/steps/pxc_1727010_02_MKDS-1-2-3-81_3D.stp
7.30 x 12.0 x 7.62 mm
