bayavahmed/PCB_LIBS/KiCADLibrary/Personal/3DMODELS/WE_PUSH_3MB.stp

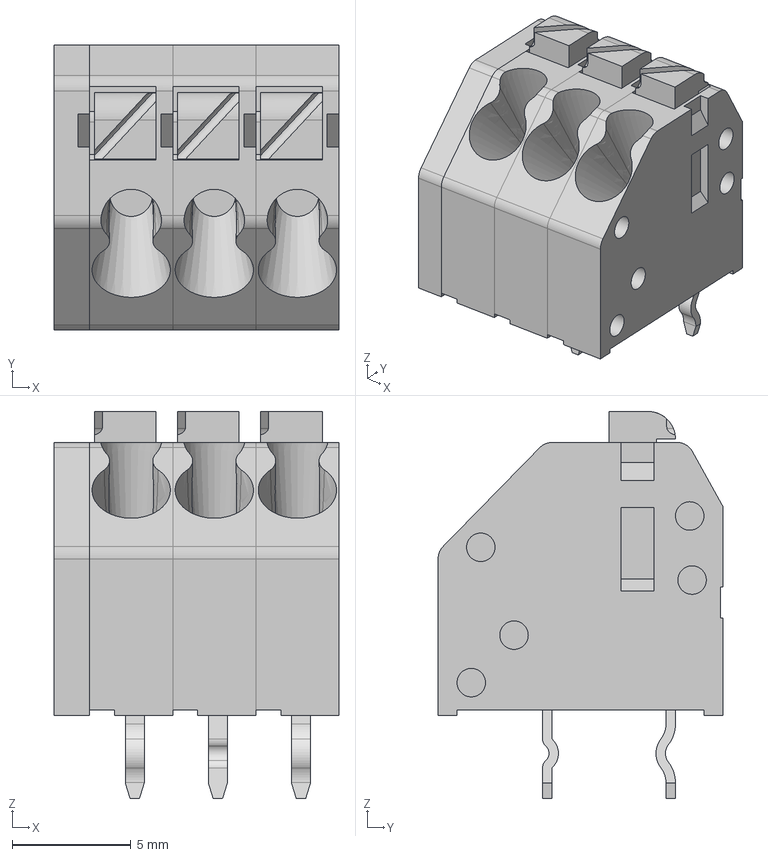
[picture p111: CAD file, 2025-12-09]
KiCADLibrary/Personal/3DMODELS/WE_PUSH_3MB.stp
12.0 x 12.0 x 16.3 mm
6914121200xxB x 3
6914121200xx
6914121200xx_levier x 3
6914121200xx_LONG x 2
6914121200xxB_CAPOT
