bayavahmed/PCB_LIBS/AltiumLibrary/steps/pxc_1757116_05_MSTB-2-5-12-ST-5-08_3D.stp

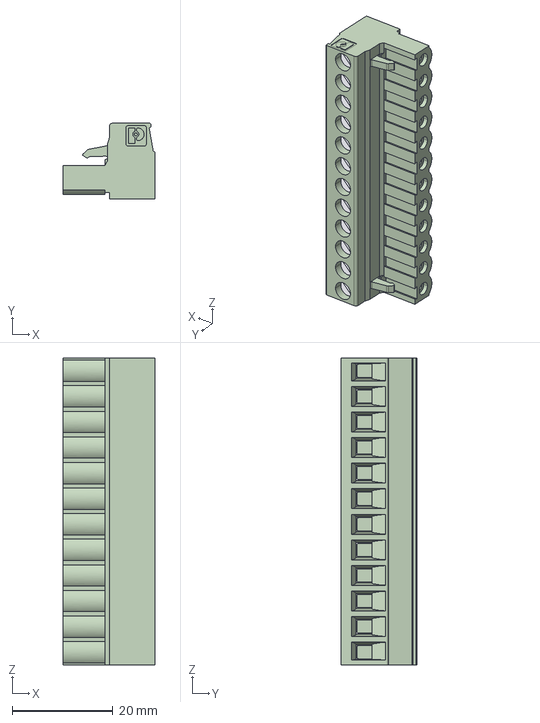
[picture p112: CAD file, 2025-12-09]
AltiumLibrary/steps/pxc_1757116_05_MSTB-2-5-12-ST-5-08_3D.stp
18.2 x 15.0 x 61.0 mm
