bayavahmed/PCB_LIBS/KiCADLibrary/Personal/3DMODELS/usb_b.stp

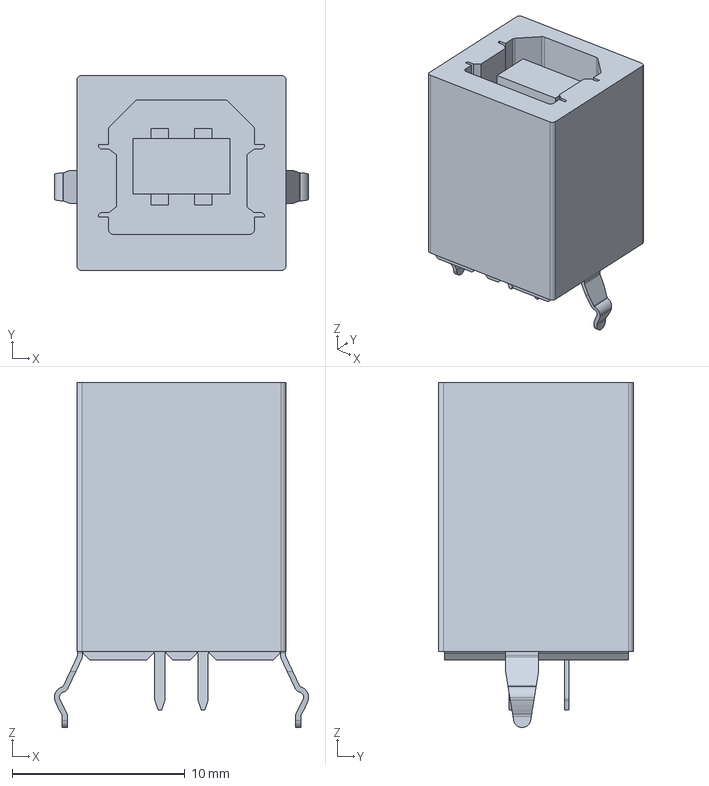
[picture p113: CAD file, 2025-12-09]
KiCADLibrary/Personal/3DMODELS/usb_b.stp
14.7 x 11.3 x 19.9 mm
