bayavahmed/PCB_LIBS/AltiumLibrary/steps/pxc_1803471_03_MCV-1-5-7-G-3-81_3D.stp

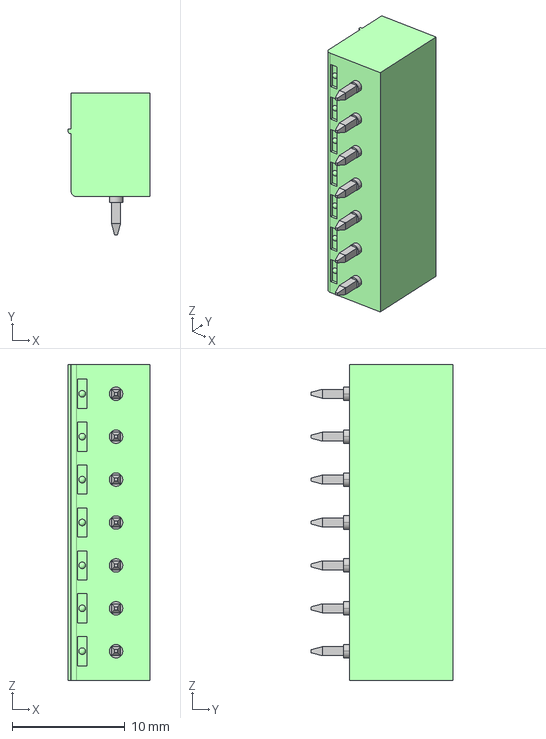
[picture p114: CAD file, 2025-12-09]
AltiumLibrary/steps/pxc_1803471_03_MCV-1-5-7-G-3-81_3D.stp
7.25 x 12.6 x 28.1 mm
