bayavahmed/PCB_LIBS/AltiumLibrary/steps/SFH11-xxPC-D06-RA-BK.STEP

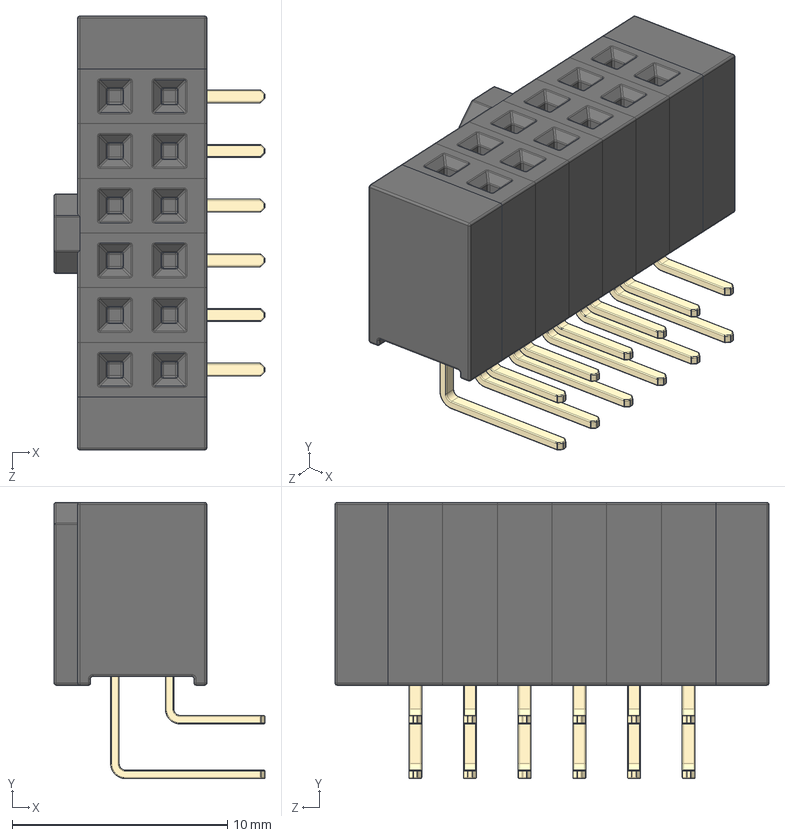
[picture p115: CAD file, 2025-12-09]
AltiumLibrary/steps/SFH11-xxPC-D06-RA-BK.STEP
9.80 x 12.8 x 20.2 mm
body section with RA gold pins x 6
end x 2
Polarizing Key
