bayavahmed/PCB_LIBS/KiCADLibrary/Personal/3DMODELS/tact_switch_6x6x16.stp

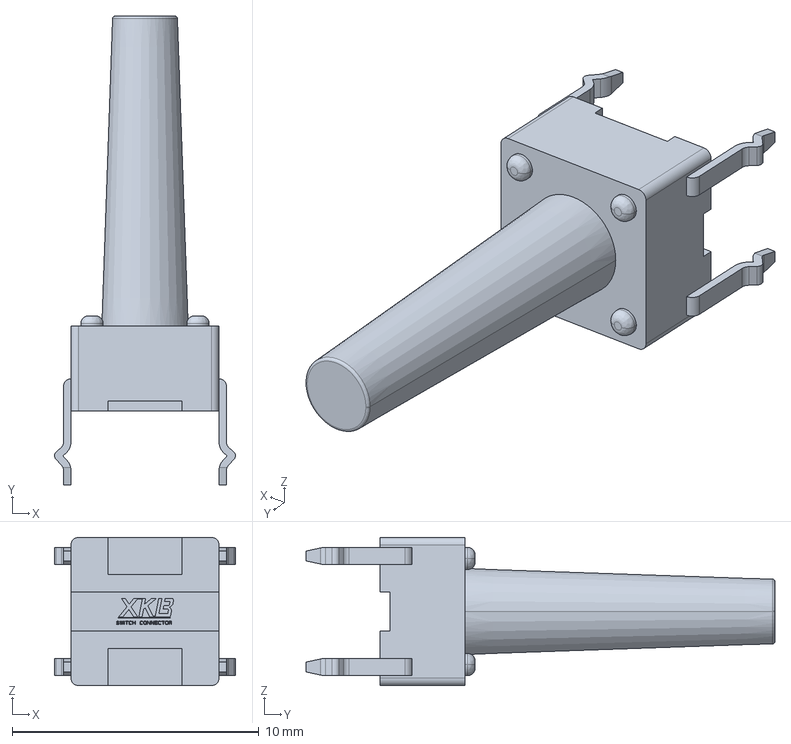
[picture p116: CAD file, 2025-12-09]
KiCADLibrary/Personal/3DMODELS/tact_switch_6x6x16.stp
7.34 x 19.0 x 6.00 mm
