bayavahmed/PCB_LIBS/KiCADLibrary/Personal/3DMODELS/tc-1102-a-z-r.stp

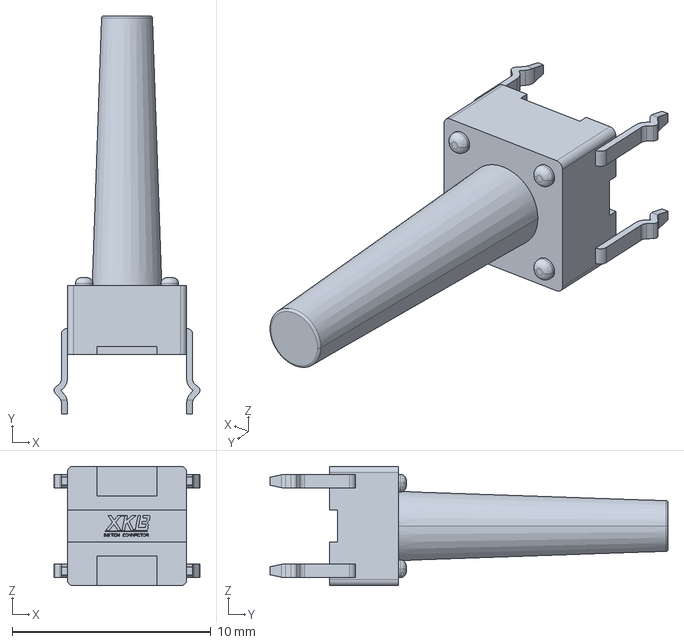
[picture p117: CAD file, 2025-12-09]
KiCADLibrary/Personal/3DMODELS/tc-1102-a-z-r.stp
7.34 x 20.0 x 6.00 mm
