bayavahmed/PCB_LIBS/AltiumLibrary/steps/pxc_1757077_04_MSTB-2-5-8-ST-5-08_3D.stp

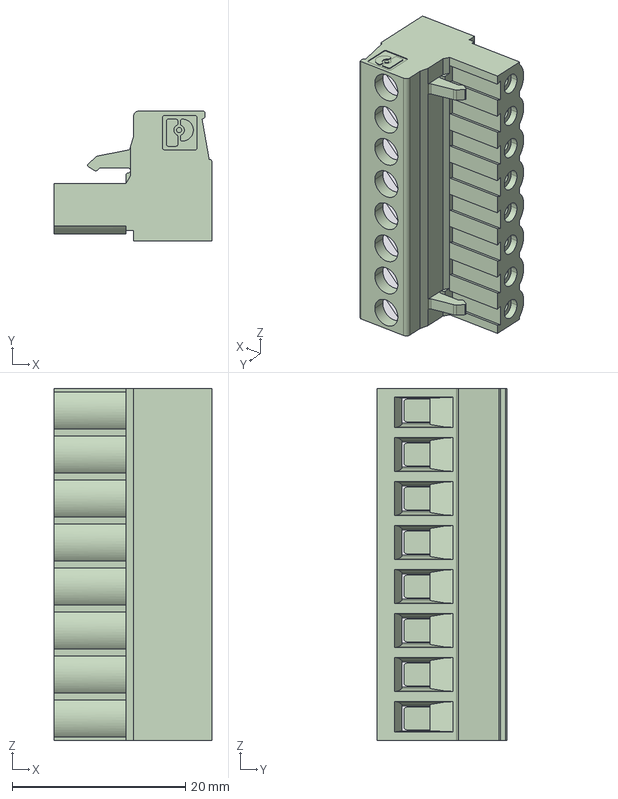
[picture p118: CAD file, 2025-12-09]
AltiumLibrary/steps/pxc_1757077_04_MSTB-2-5-8-ST-5-08_3D.stp
18.2 x 15.0 x 40.6 mm
