bayavahmed/PCB_LIBS/KiCADLibrary/Personal/3DMODELS/term Block 180 - 9.stp

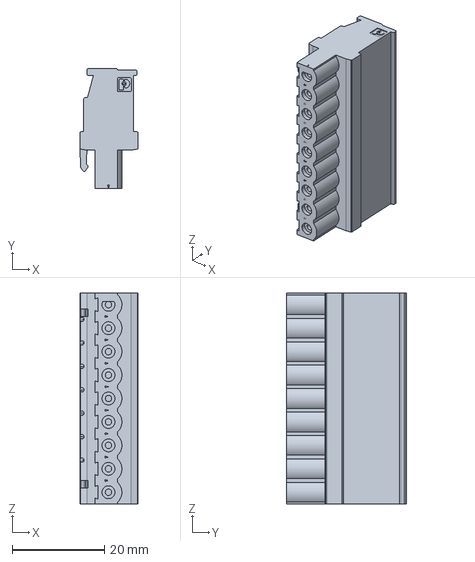
[picture p119: CAD file, 2025-12-09]
KiCADLibrary/Personal/3DMODELS/term Block 180 - 9.stp
12.6 x 26.0 x 45.7 mm
