bayavahmed/PCB_LIBS/KiCADLibrary/Personal/3DMODELS/WE_PUSH_4MB.stp

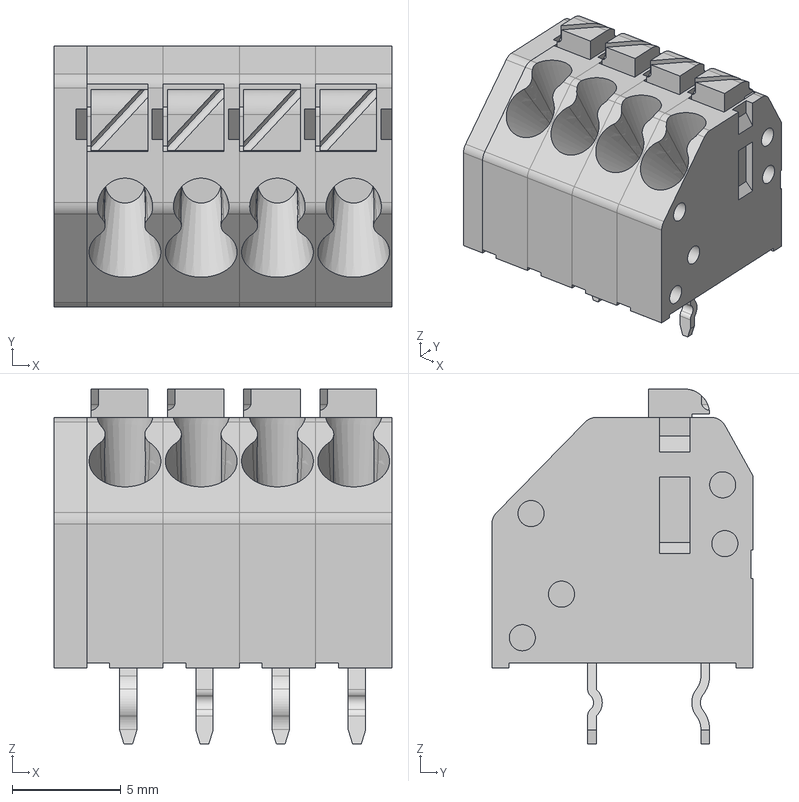
[picture p120: CAD file, 2025-12-09]
KiCADLibrary/Personal/3DMODELS/WE_PUSH_4MB.stp
15.5 x 12.0 x 16.3 mm
6914121200xxB x 4
6914121200xx x 2
6914121200xx_levier x 4
6914121200xx_LONG x 2
6914121200xxB_CAPOT
