bayavahmed/PCB_LIBS/AltiumLibrary/steps/5.08_2way.stp

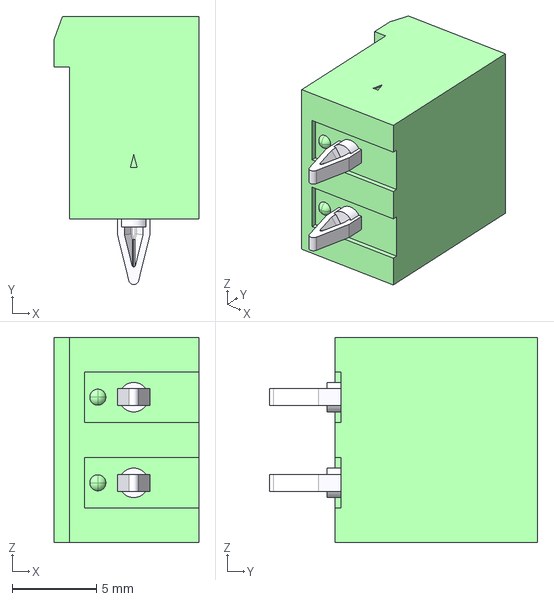
[picture p121: CAD file, 2025-12-09]
AltiumLibrary/steps/5.08_2way.stp
8.60 x 15.9 x 12.2 mm
