bayavahmed/PCB_LIBS/KiCADLibrary/Personal/3DMODELS/molex_0430450412.stp

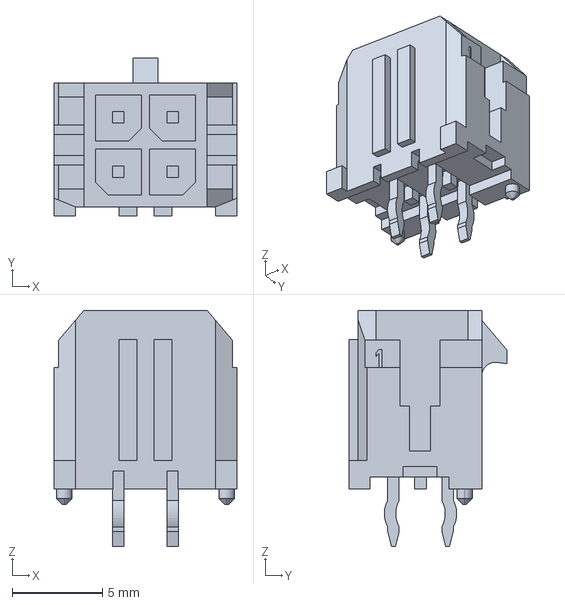
[picture p122: CAD file, 2025-12-09]
KiCADLibrary/Personal/3DMODELS/molex_0430450412.stp
10.2 x 8.77 x 13.1 mm
