bayavahmed/PCB_LIBS/KiCADLibrary/Personal/3DMODELS/250-204.stp

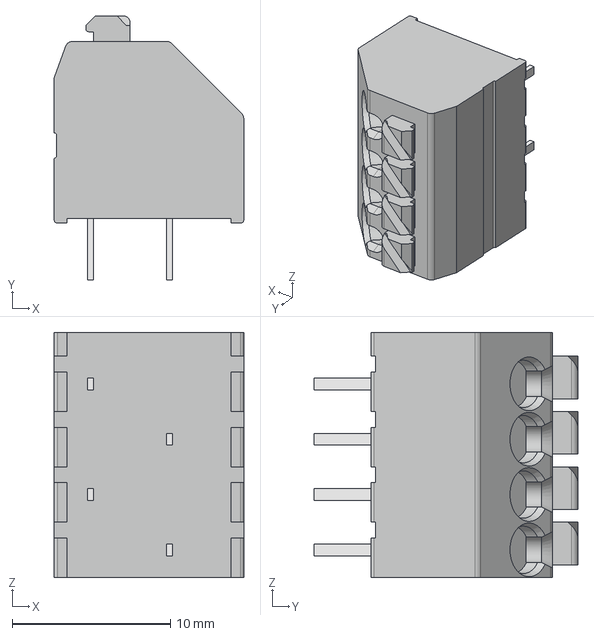
[picture p123: CAD file, 2025-12-09]
KiCADLibrary/Personal/3DMODELS/250-204.stp
12.0 x 16.7 x 15.5 mm
