bayavahmed/PCB_LIBS/AltiumLibrary/steps/mov-10d471klkjhguj.stp

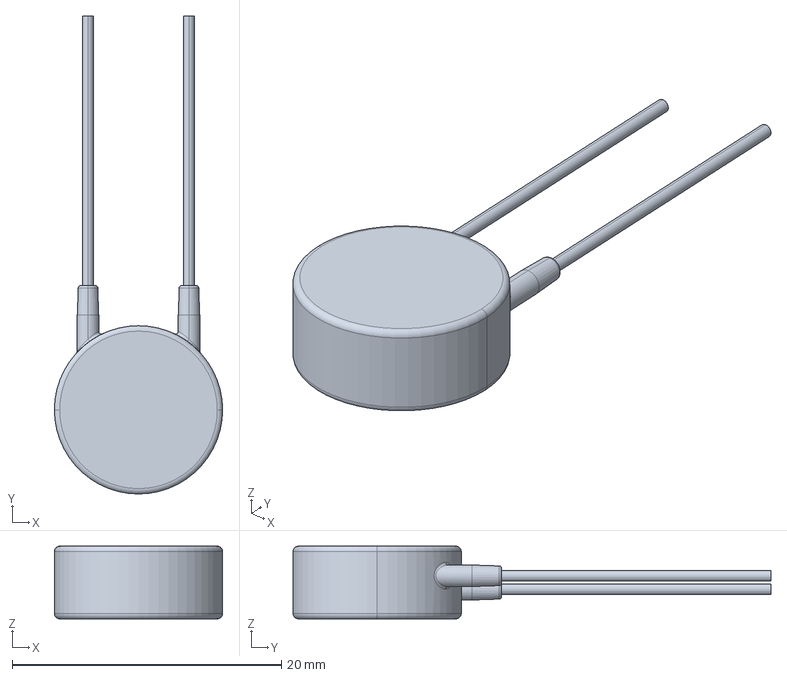
[picture p124: CAD file, 2025-12-09]
AltiumLibrary/steps/mov-10d471klkjhguj.stp
12.5 x 35.5 x 5.40 mm
