bayavahmed/PCB_LIBS/KiCADLibrary/Personal/3DMODELS/250-202.stp

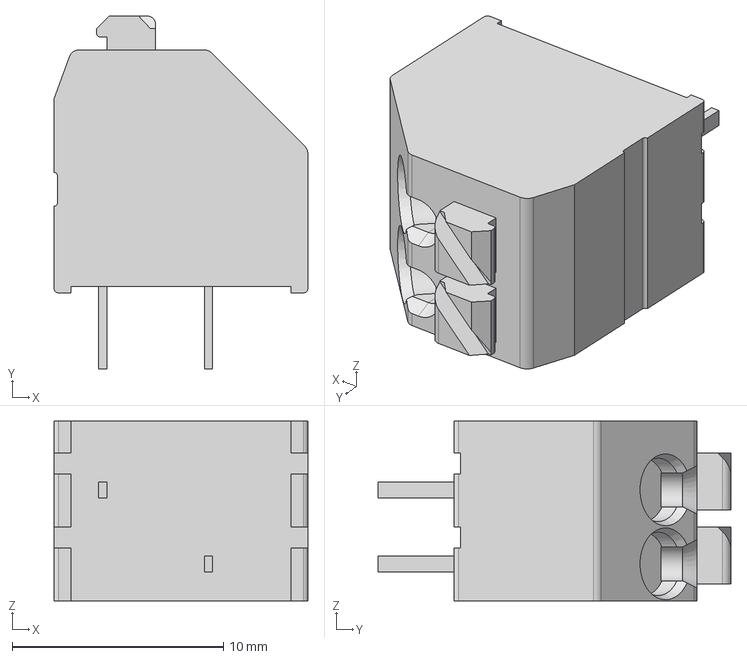
[picture p125: CAD file, 2025-12-09]
KiCADLibrary/Personal/3DMODELS/250-202.stp
12.0 x 16.7 x 8.50 mm
