bayavahmed/PCB_LIBS/AltiumLibrary/steps/PCAP_18x35_5-THRU-ELECT_NCA.step

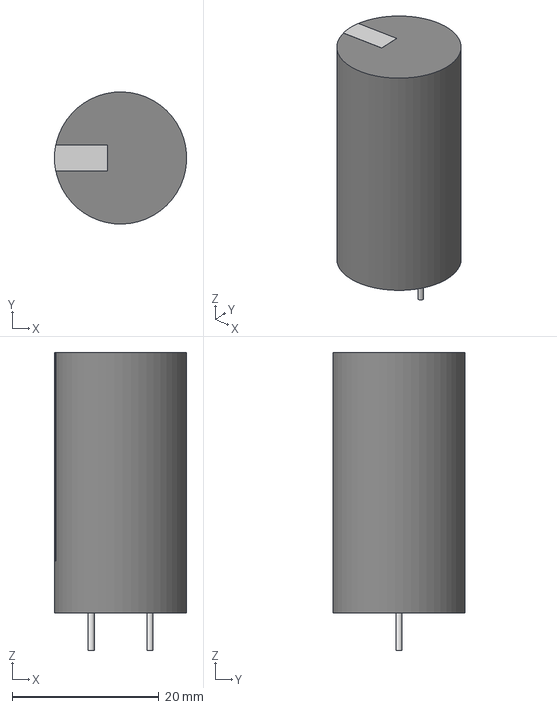
[picture p126: CAD file, 2025-12-09]
AltiumLibrary/steps/PCAP_18x35_5-THRU-ELECT_NCA.step
18.0 x 18.0 x 40.6 mm
