bayavahmed/PCB_LIBS/AltiumLibrary/steps/User Library-R_1210.step

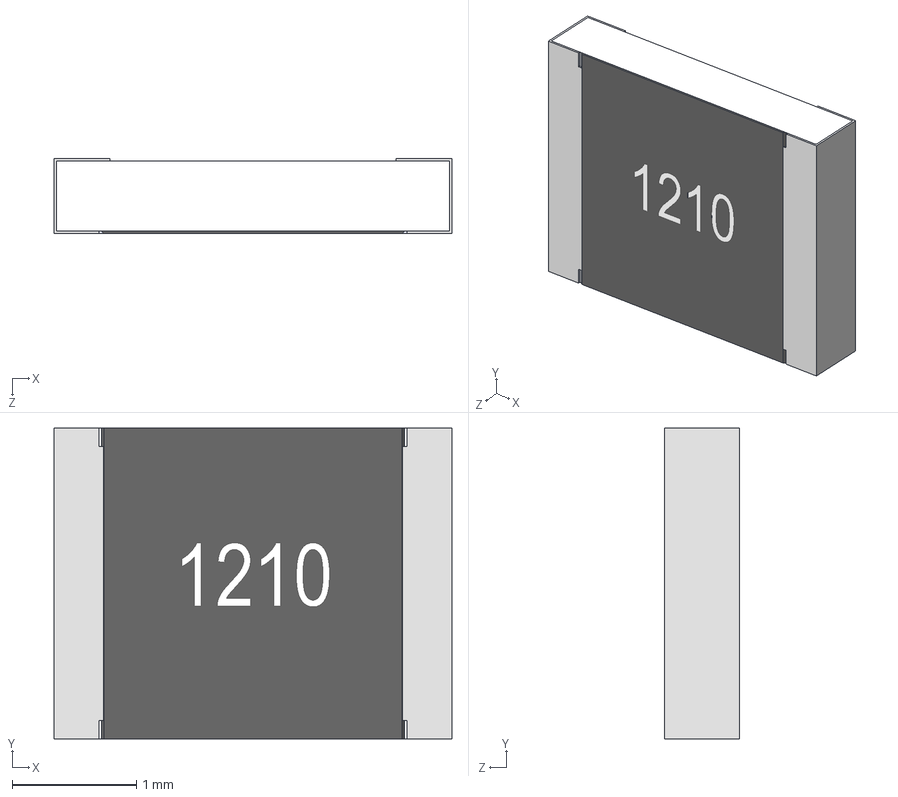
[picture p127: CAD file, 2025-12-09]
AltiumLibrary/steps/User Library-R_1210.step
3.20 x 2.50 x 0.6 mm
