bayavahmed/PCB_LIBS/KiCADLibrary/Personal/3DMODELS/HH-044_ALT.step

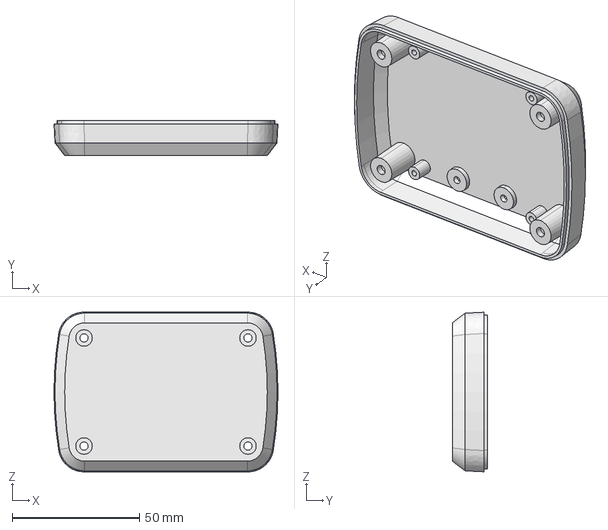
[picture p128: CAD file, 2025-12-09]
KiCADLibrary/Personal/3DMODELS/HH-044_ALT.step
88.1 x 13.9 x 62.8 mm
