bayavahmed/PCB_LIBS/AltiumLibrary/steps/A Case SMT Capacitor.step

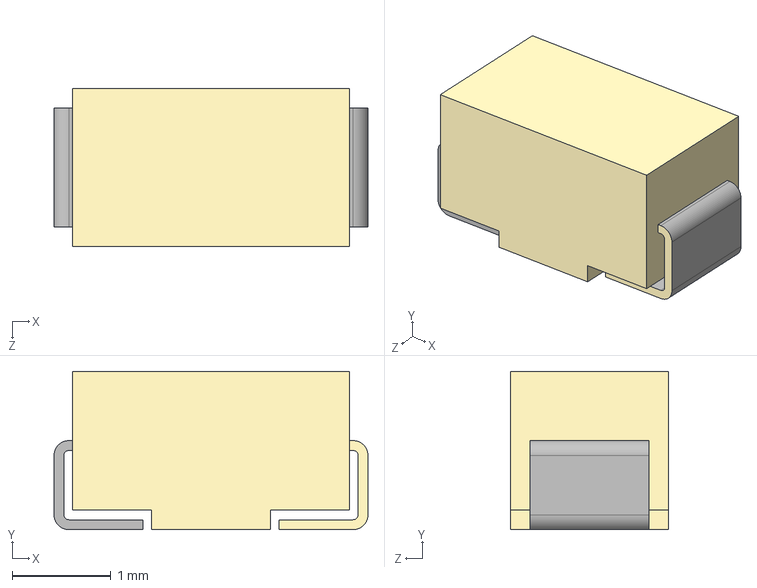
[picture p129: CAD file, 2025-12-09]
AltiumLibrary/steps/A Case SMT Capacitor.step
3.17 x 1.60 x 1.60 mm
