bayavahmed/PCB_LIBS/AltiumLibrary/steps/HPH1-B-07-UA.STEP

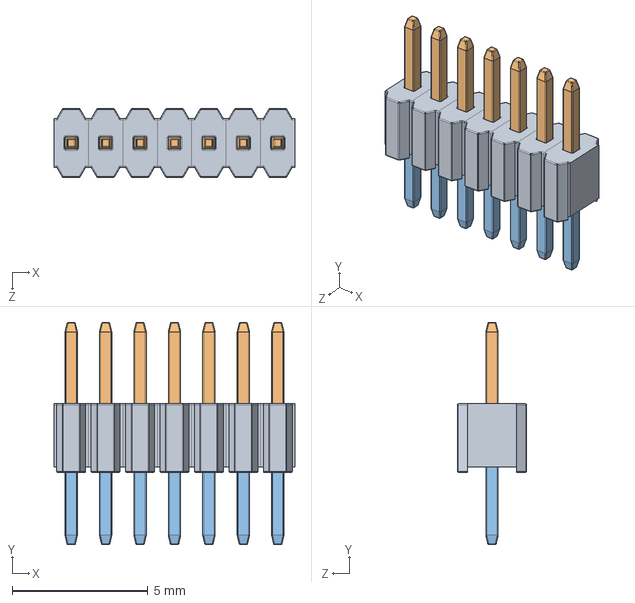
[picture p130: CAD file, 2025-12-09]
AltiumLibrary/steps/HPH1-B-07-UA.STEP
8.89 x 8.20 x 2.54 mm
