bayavahmed/PCB_LIBS/KiCADLibrary/Personal/3DMODELS/SO8_W.step

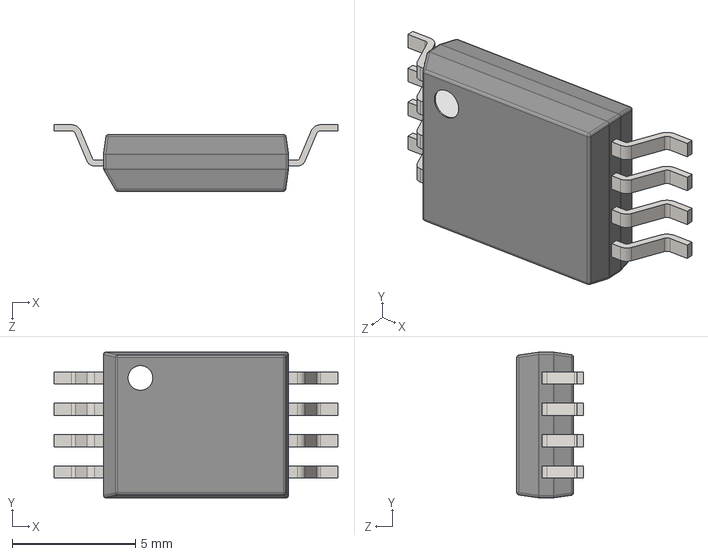
[picture p131: CAD file, 2025-12-09]
KiCADLibrary/Personal/3DMODELS/SO8_W.step
11.5 x 5.90 x 2.70 mm
