bayavahmed/PCB_LIBS/KiCADLibrary/Personal/3DMODELS/HH-1515_YAN.step

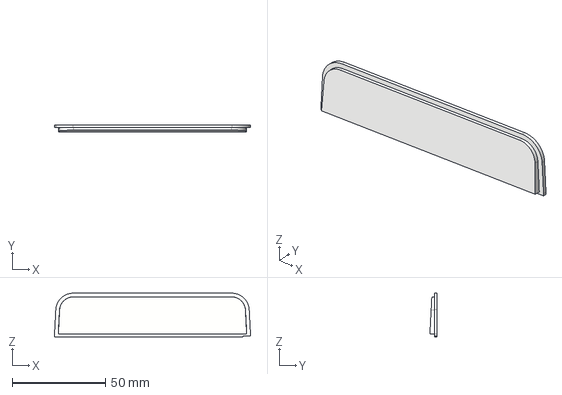
[picture p132: CAD file, 2025-12-09]
KiCADLibrary/Personal/3DMODELS/HH-1515_YAN.step
105.0 x 3.86 x 23.4 mm
