bayavahmed/PCB_LIBS/KiCADLibrary/Personal/3DMODELS/rt_204.step

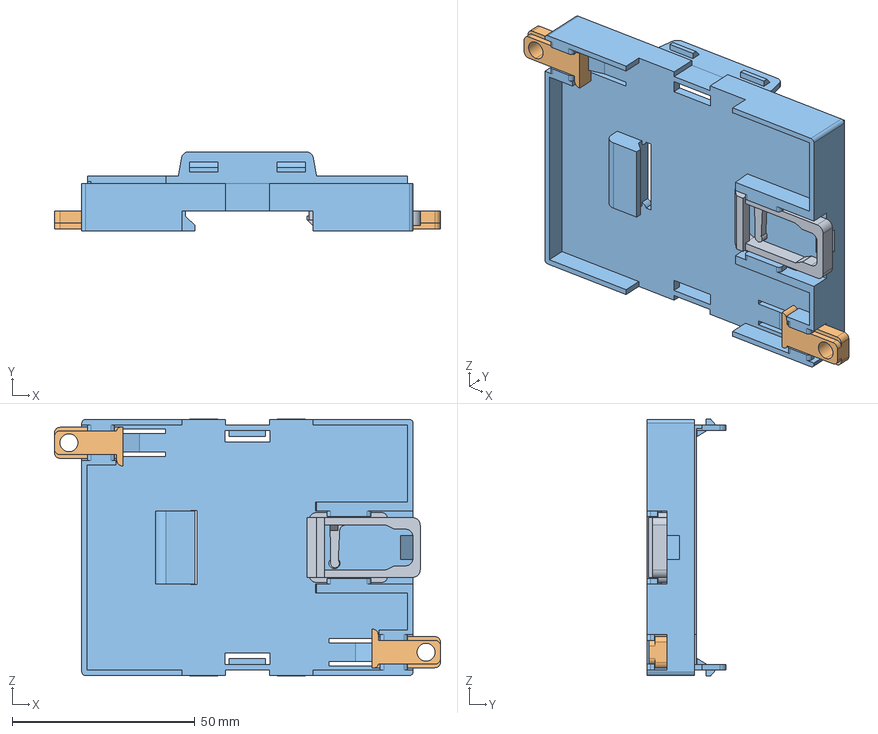
[picture p133: CAD file, 2025-12-09]
KiCADLibrary/Personal/3DMODELS/rt_204.step
105.5 x 21.7 x 70.2 mm
ray_kilidi
Rail_Lock001 x 2
base
