bayavahmed/PCB_LIBS/KiCADLibrary/Personal/3DMODELS/weldingTerm11,5x9,2.step

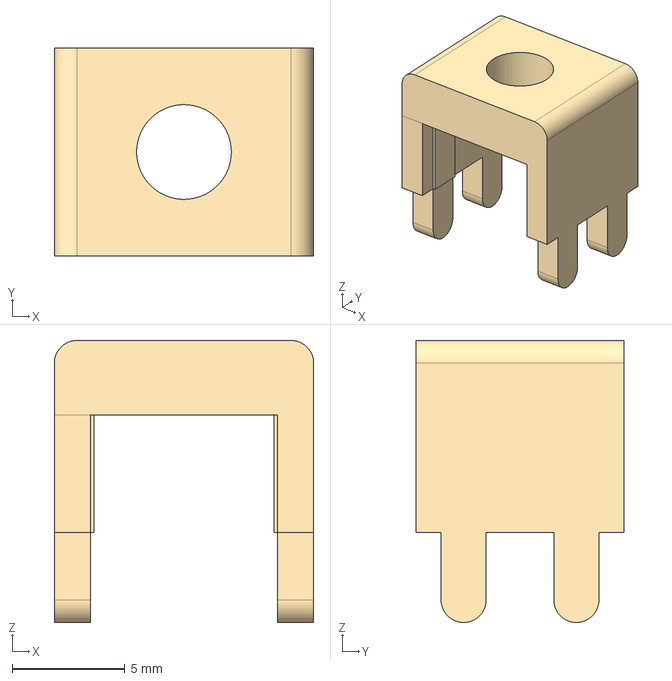
[picture p134: CAD file, 2025-12-09]
KiCADLibrary/Personal/3DMODELS/weldingTerm11,5x9,2.step
11.5 x 9.20 x 12.5 mm
