bayavahmed/PCB_LIBS/AltiumLibrary/steps/User Library-TSSOP-28_P065.STEP

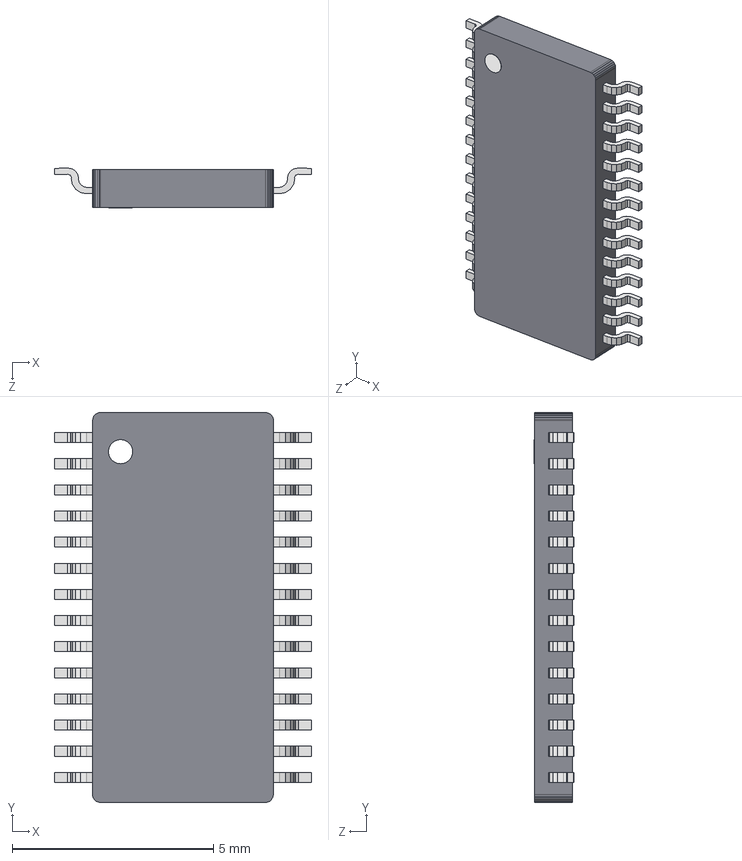
[picture p135: CAD file, 2025-12-09]
AltiumLibrary/steps/User Library-TSSOP-28_P065.STEP
6.40 x 9.70 x 0.989 mm
Extruded2
Extruded3 x 28
Board3 x 28
Board2
