bayavahmed/PCB_LIBS/KiCADLibrary/Personal/3DMODELS/weldingTerm10,5x10.step

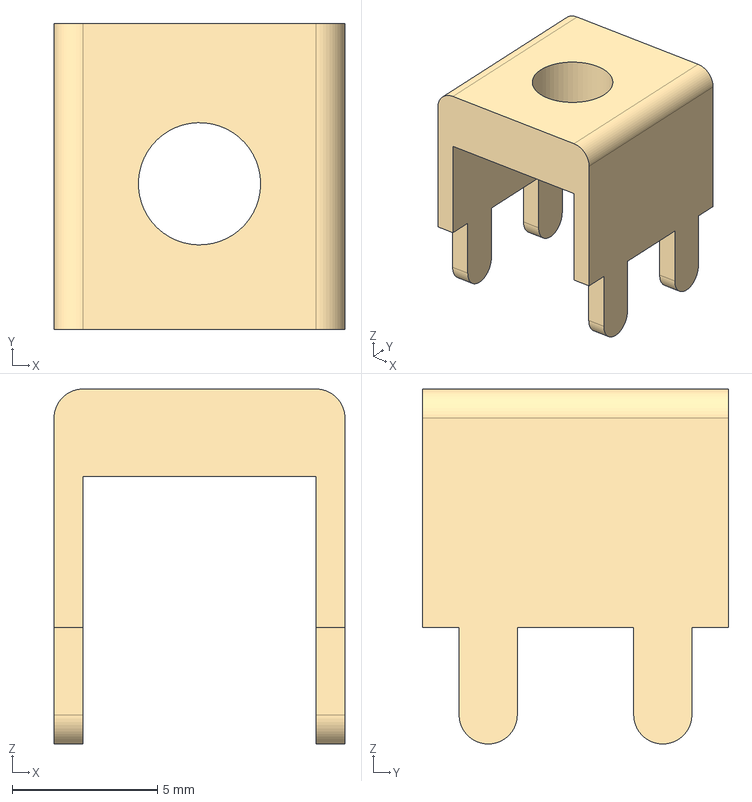
[picture p136: CAD file, 2025-12-09]
KiCADLibrary/Personal/3DMODELS/weldingTerm10,5x10.step
10.0 x 10.5 x 12.2 mm
