bayavahmed/PCB_LIBS/AltiumLibrary/steps/QFN-28_UFD_LIT-M.step

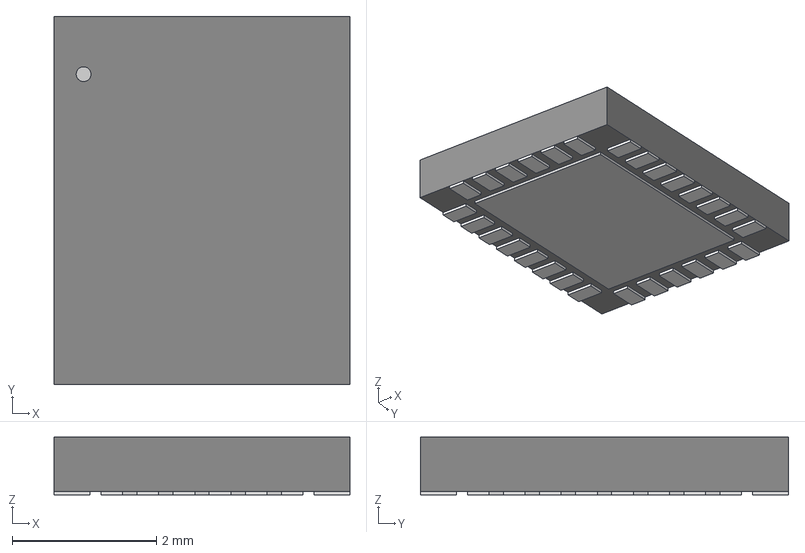
[picture p137: CAD file, 2025-12-09]
AltiumLibrary/steps/QFN-28_UFD_LIT-M.step
4.10 x 5.10 x 0.803 mm
