bayavahmed/PCB_LIBS/AltiumLibrary/steps/pxc_1758047_04_MSTBV-2-5-5-G-5-08_3D.stp

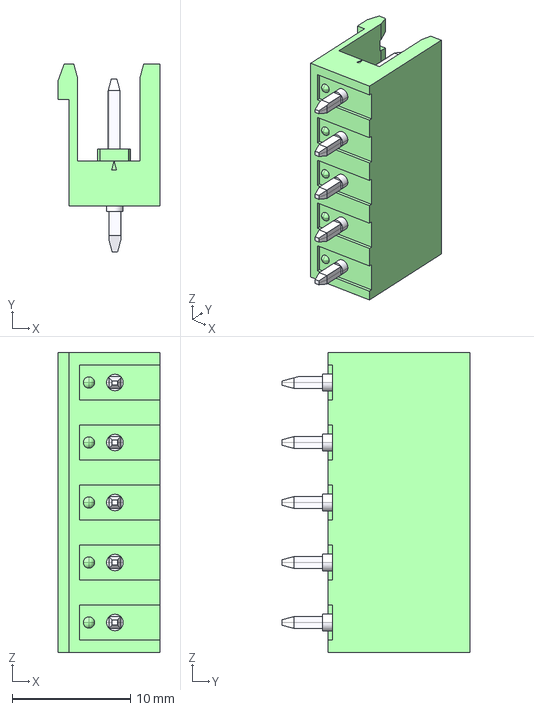
[picture p138: CAD file, 2025-12-09]
AltiumLibrary/steps/pxc_1758047_04_MSTBV-2-5-5-G-5-08_3D.stp
8.60 x 15.9 x 25.4 mm
