bayavahmed/PCB_LIBS/AltiumLibrary/steps/c-1571625-1-c-3d.stp

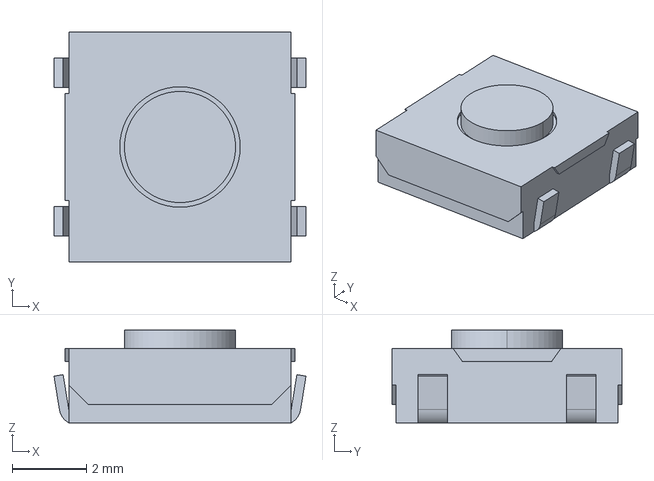
[picture p139: CAD file, 2025-12-09]
AltiumLibrary/steps/c-1571625-1-c-3d.stp
6.80 x 6.20 x 2.50 mm
