bayavahmed/PCB_LIBS/KiCADLibrary/Personal/3DMODELS/B1212S-1W.step

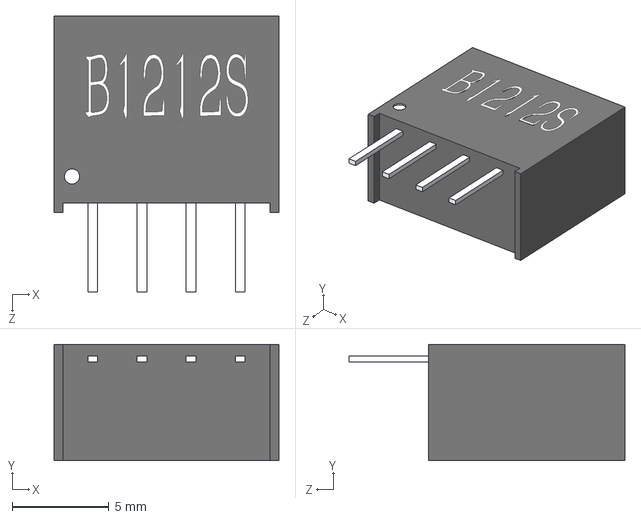
[picture p140: CAD file, 2025-12-09]
KiCADLibrary/Personal/3DMODELS/B1212S-1W.step
11.6 x 6.01 x 14.3 mm
