bayavahmed/PCB_LIBS/AltiumLibrary/steps/BGA_CPG236.STEP

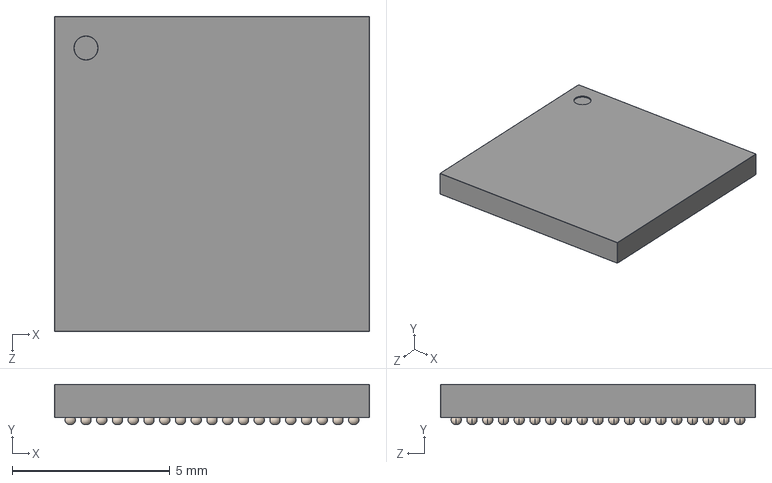
[picture p141: CAD file, 2025-12-09]
AltiumLibrary/steps/BGA_CPG236.STEP
10.0 x 1.28 x 10.0 mm
Ball x 238
