bayavahmed/PCB_LIBS/AltiumLibrary/steps/LED DIP 3MM.step

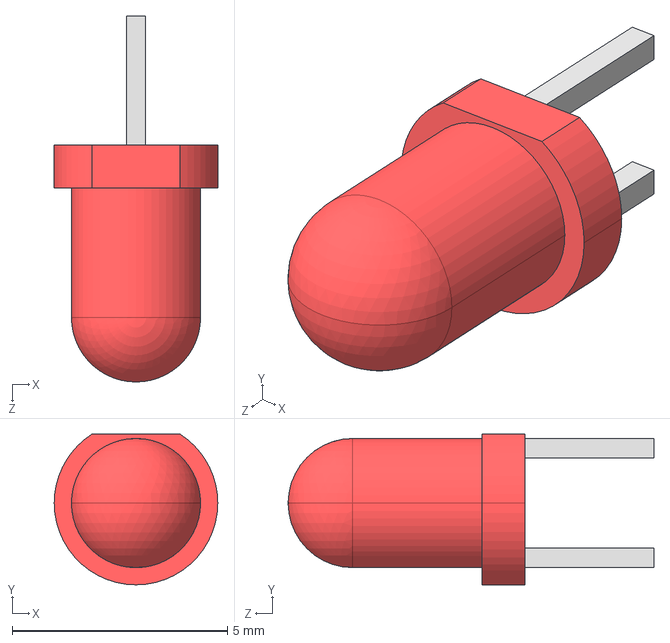
[picture p142: CAD file, 2025-12-09]
AltiumLibrary/steps/LED DIP 3MM.step
3.80 x 3.50 x 8.50 mm
