bayavahmed/PCB_LIBS/KiCADLibrary/Personal/3DMODELS/250-203.stp

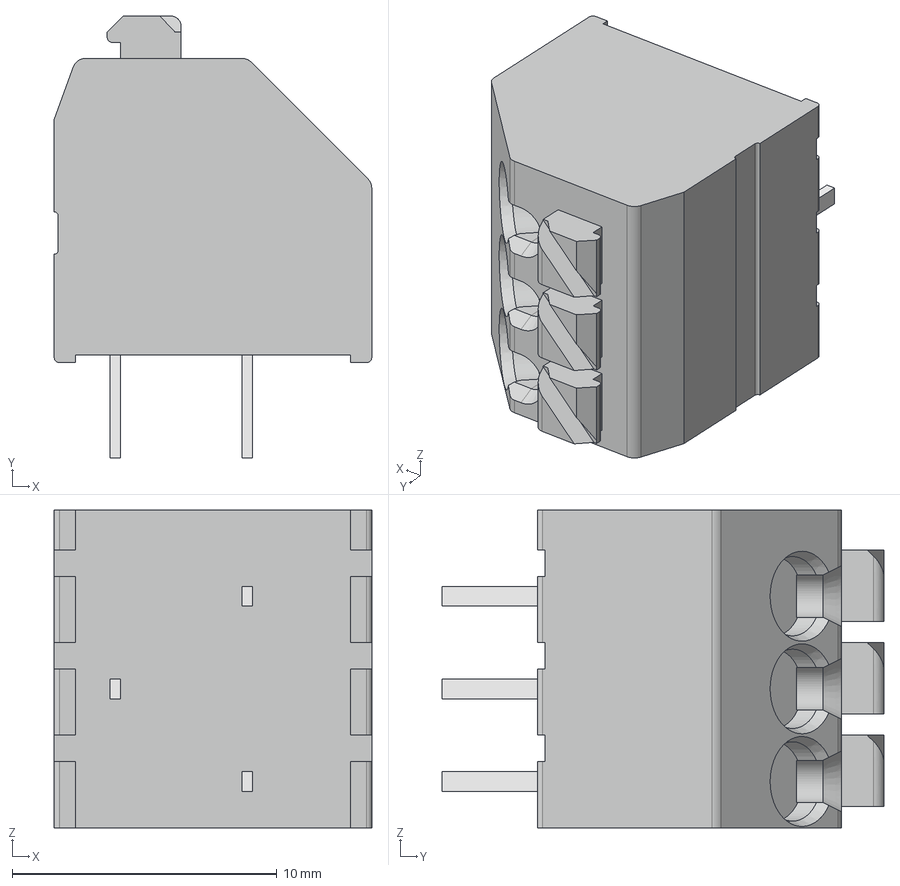
[picture p143: CAD file, 2025-12-09]
KiCADLibrary/Personal/3DMODELS/250-203.stp
12.0 x 16.7 x 12.0 mm
