bayavahmed/PCB_LIBS/(list of files, cad)

Other CAD files:
AltiumLibrary/steps/User Library-TO-92_Str_Free-Models.sldasm
AltiumLibrary/steps/User Library-TO-92_Str_Open_CASCADE_STEP_translator_6.2_1.1.sldasm
AltiumLibrary/steps/User Library-TO-92_Str_547225856.sldasm
AltiumLibrary/steps/User Library-TO-92_Str_BODY.sldasm
AltiumLibrary/steps/User Library-TO-92_Str_577959568.sldasm
AltiumLibrary/steps/STL/G-188.stp
AltiumLibrary/steps/STL/G-188-M.stp
KiCADLibrary/Personal/3DMODELS/tny284.stp
AltiumLibrary/steps/PCAP_8x10-ELECT-L.stp
AltiumLibrary/steps/User Library-TO-92_Str_Extruded_2.sldprt
AltiumLibrary/steps/User Library-S10K275_1.sldprt
KiCADLibrary/Personal/3DMODELS/WE_PUSH_3B.stp
AltiumLibrary/steps/MSOP-8_MS_LIT.step
KiCADLibrary/Personal/3DMODELS/WE_PUSH_4B.stp
AltiumLibrary/steps/022288041.stp
AltiumLibrary/steps/0ZCJ.step
AltiumLibrary/steps/14057.SLDPRT
AltiumLibrary/steps/14125.stp
AltiumLibrary/steps/1758050.stp
AltiumLibrary/steps/1803426.stp
AltiumLibrary/steps/1803439.stp
AltiumLibrary/steps/197054003.stp
AltiumLibrary/steps/197054101.stp
AltiumLibrary/steps/197054203.stp
AltiumLibrary/steps/197124001.stp
AltiumLibrary/steps/20020107D071A01LF.stp
AltiumLibrary/steps/20020107H031A01LF_01.SLDPRT
AltiumLibrary/steps/20020107H031A01LF_02.SLDPRT
AltiumLibrary/steps/20020107H031A01LF_03.SLDPRT
AltiumLibrary/steps/2010_smd.step
AltiumLibrary/steps/20428.stp
AltiumLibrary/steps/206-10.STEP
AltiumLibrary/steps/206-12.STEP
AltiumLibrary/steps/206-1S.STEP
AltiumLibrary/steps/206-2.STEP
AltiumLibrary/steps/206-3.STEP
AltiumLibrary/steps/206-4.STEP
AltiumLibrary/steps/206-5.STEP
AltiumLibrary/steps/206-7.STEP
AltiumLibrary/steps/206-8.STEP
AltiumLibrary/steps/206-9.STEP
AltiumLibrary/steps/20886.stp
AltiumLibrary/steps/2512 SMD Resistor.step
AltiumLibrary/steps/2x16_LCD_NHD.STEP
AltiumLibrary/steps/3216_tantalum_cap.step
AltiumLibrary/steps/330uH_1.stp
AltiumLibrary/steps/330uH_2.stp
AltiumLibrary/steps/395105007.stp
AltiumLibrary/steps/4.14mm_6pin_vert.stp
AltiumLibrary/steps/43740.stp
AltiumLibrary/steps/5.08_6way.stp
AltiumLibrary/steps/5.08mm_10way.stp
AltiumLibrary/steps/500SSPxS2M2xEA.stp
AltiumLibrary/steps/61300611121_Download_STP_61300611121_rev1.stp
AltiumLibrary/steps/61300811121.stp
AltiumLibrary/steps/61300811121_Download_STP_61300811121_rev1.stp
AltiumLibrary/steps/68001-x08.prt
AltiumLibrary/steps/68002-x02.prt
AltiumLibrary/steps/691412320004 (rev1).stp
AltiumLibrary/steps/6pindip.stp
AltiumLibrary/steps/7.5mm_disc_cap.stp
AltiumLibrary/steps/7.62mm_3way_90drc.stp
AltiumLibrary/steps/70324200.stp
AltiumLibrary/steps/76877530_Download_STP_WE-PD2-HV-7850_rev1.stp
AltiumLibrary/steps/77957.stp
AltiumLibrary/steps/87583-2010blf.stp
AltiumLibrary/steps/87583-2010rlfc.stp
AltiumLibrary/steps/96-FBGA (14X9).step
AltiumLibrary/steps/961107-6404-XX.stp
AltiumLibrary/steps/A-934-P-1.STEP
AltiumLibrary/steps/A-934-P-2.STEP
AltiumLibrary/steps/A23 12v Battery.stp
AltiumLibrary/steps/A27 Battery.STEP
AltiumLibrary/steps/ABLS.STEP
AltiumLibrary/steps/Blue_Pill v6.step
AltiumLibrary/steps/C0201C104K9PACTU.step
AltiumLibrary/steps/C1812X104KBRACTU.step
AltiumLibrary/steps/CAPACITOR 0603.SLDPRT
AltiumLibrary/steps/CAPACITOR 0603.step
AltiumLibrary/steps/CAP_10x12_5-THRU-ELECT.step
AltiumLibrary/steps/CAP_3216-L.step
AltiumLibrary/steps/CAP_3216-M.step
AltiumLibrary/steps/CAP_3216.step
AltiumLibrary/steps/CAP_ALUM_16x315_PAN.step
AltiumLibrary/steps/CAP_EEE_D8_6.6x6.6.step
AltiumLibrary/steps/CAP_L_10X12P5_RUB.step
AltiumLibrary/steps/CAP_YX_8X11P5_RUB.step
AltiumLibrary/steps/CL_series_size6.3x6.3.step
AltiumLibrary/steps/CL_series_size8x10.step
AltiumLibrary/steps/CR2032_HOR_HOLD.step
AltiumLibrary/steps/CUI_DEVICES_TBLH10-350-04BK.step
AltiumLibrary/steps/Cap electro 6_3x11x2_5mm.step
AltiumLibrary/steps/Cap_cer_1206_C474MMREC7210.step
AltiumLibrary/steps/CaseA.step
AltiumLibrary/steps/D2PAK.step
AltiumLibrary/steps/D8-L.stp
AltiumLibrary/steps/D8-M.stp
AltiumLibrary/steps/D8.stp
AltiumLibrary/steps/DCC6C.STEP
AltiumLibrary/steps/DCK(R-PDSO-G6).step
AltiumLibrary/steps/DFN-8-2.step
AltiumLibrary/steps/DFN8_3x3MC_MCH-L.step
AltiumLibrary/steps/DFN8_3x3MC_MCH.step
AltiumLibrary/steps/DIP4.step
AltiumLibrary/steps/DIP_switch_6P.stp
AltiumLibrary/steps/DO-214AC(SMA).step
AltiumLibrary/steps/DO-221AC.step
AltiumLibrary/steps/DS1040-02 (DIP_switch).stp
AltiumLibrary/steps/DS1040-04 (DIP_switch).stp
AltiumLibrary/steps/DS1040-05 (DIP_switch).stp
AltiumLibrary/steps/DS1040-06 (DIP_switch).stp
AltiumLibrary/steps/DS1040-07 (DIP_switch).stp
AltiumLibrary/steps/DS1040-08 (DIP_switch).stp
AltiumLibrary/steps/DS1040-09 (DIP_switch).stp
AltiumLibrary/steps/DS1040-10 (DIP_switch).stp
AltiumLibrary/steps/DS1040-11 (DIP_switch).stp
AltiumLibrary/steps/DS1040-12 (DIP_switch).stp
AltiumLibrary/steps/ECS-3X8X_ECS.step
AltiumLibrary/steps/ECW-V-L.step
AltiumLibrary/steps/ECW-V-M.step
AltiumLibrary/steps/ECW-V.step
AltiumLibrary/steps/E_2750-1110_03.STEP
AltiumLibrary/steps/F92-P-L.stp
AltiumLibrary/steps/F92-P-M.stp
AltiumLibrary/steps/F92-P.stp
AltiumLibrary/steps/Fuse 1812.step
AltiumLibrary/steps/G5V_1.step
AltiumLibrary/steps/G_SIZE_10X10.2.stp
AltiumLibrary/steps/Green 10w Plug 5_08mm PCB.step
AltiumLibrary/steps/HPH1-A-05-UA.STEP
AltiumLibrary/steps/Header_Male_4Pin.STEP
AltiumLibrary/steps/IND_EPCOS_B82472G6.step
AltiumLibrary/steps/KLS1-DC-022A.step
AltiumLibrary/steps/LC1K0601.STEP
AltiumLibrary/steps/LCD_CHARACTER_2x16.STEP
AltiumLibrary/steps/LED RED 5mm.SLDPRT
AltiumLibrary/steps/LED Red 5mm V.step
AltiumLibrary/steps/LED_d3-BLU.STEP
AltiumLibrary/steps/LQFP-32-L.step
AltiumLibrary/steps/LQFP-32.step
AltiumLibrary/steps/LS085xx05FxxxC1A.stp
AltiumLibrary/steps/Line Filter 7_3x7_3x4_2H.step
AltiumLibrary/steps/M50-3530442.STEP
AltiumLibrary/steps/M50-3530642.STEP
AltiumLibrary/steps/M50-3530842.STEP
AltiumLibrary/steps/MB6S.STEP
AltiumLibrary/steps/MB6S_Bridge.STEP
AltiumLibrary/steps/MOC3063S-TA1.stp
AltiumLibrary/steps/MOLEX_MALE_1718560005.stp
AltiumLibrary/steps/MSOP-8_MS_LIT-M.step
AltiumLibrary/steps/PAN_ALD.step
AltiumLibrary/steps/PCAP_10x10-ELECT_NCA-L.step
AltiumLibrary/steps/PCAP_10x10-ELECT_NCA-M.step
AltiumLibrary/steps/PCAP_10x10-ELECT_NCA.step
AltiumLibrary/steps/PCAP_8x10-ELECT-M.stp
AltiumLibrary/steps/PH1-10-UA.STEP
AltiumLibrary/steps/PTS636SMG25JSMTRLFS.stp
AltiumLibrary/steps/PTS645SL43SMTR92-LFS.STEP
AltiumLibrary/steps/Phoenix Contact 3.81mm Pluggable Terminal Block.SLDPRT
AltiumLibrary/steps/Phototransistor_1541021NCA170 (rev1).stp
AltiumLibrary/steps/QFN 44.step
AltiumLibrary/steps/QFN-28_UFD_LIT-L.step
AltiumLibrary/steps/QFN-28_UFD_LIT.step
AltiumLibrary/steps/QFN44_8x8.step
AltiumLibrary/steps/QFN4_3P2X2P5_MCH-M.step
AltiumLibrary/steps/QFN4_3P2X2P5_MCH.step
AltiumLibrary/steps/QFN64-2.step
AltiumLibrary/steps/R46-CB.step
AltiumLibrary/steps/R463I3100DQM1K.step
AltiumLibrary/steps/R463N347000N0K.step
AltiumLibrary/steps/R46KI310050M1K.step
AltiumLibrary/steps/R46KI3100JBM1K.step
AltiumLibrary/steps/RC0402N-L.step
AltiumLibrary/steps/RC0402N-M.step
AltiumLibrary/steps/RC0402N.step
AltiumLibrary/steps/RELAY5-496X1142_1004-P3_5.step
AltiumLibrary/steps/RELAY_JQ1_PAN.step
AltiumLibrary/steps/RES1206-2.step
AltiumLibrary/steps/RES_0402 SMD Resistor.step
AltiumLibrary/steps/RES_HHV1WS_11P5X4P5.step
AltiumLibrary/steps/RJ12.stp
AltiumLibrary/steps/RN114-x-02.stp
AltiumLibrary/steps/RN114.step
AltiumLibrary/steps/SIOV-S10K300.step
AltiumLibrary/steps/SMCW-0805-rev1.stp
AltiumLibrary/steps/SMD Ceramic Capacitors_1812 (4532)_GO.step
AltiumLibrary/steps/SMD-4.stp
AltiumLibrary/steps/SO8C- pin 3.step
AltiumLibrary/steps/SOCKET_5.08_2WAY_90DRC_CLOSE_BLACK.stp
AltiumLibrary/steps/SOD-80--MiniMelf-2.SLDPRT
AltiumLibrary/steps/SOD123.step
AltiumLibrary/steps/SOD80-MiniMelf-2.step
AltiumLibrary/steps/SOIC14-150.step
AltiumLibrary/steps/SOT-223-1.SLDPRT
AltiumLibrary/steps/SOT-223-1.step
AltiumLibrary/steps/SOT-89-1.step
AltiumLibrary/steps/SOT353.step
AltiumLibrary/steps/STL/G-188-L.stl
AltiumLibrary/steps/STL/G-188-M.stl
AltiumLibrary/steps/STL/G-188.stl
AltiumLibrary/steps/T491D476K016AT.step
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
