bayavahmed/PCB_LIBS/(list of files, drawings)

Other design files:
AltiumLibrary/AltiumMechanicalLibraryPCB.PcbLib
AltiumLibrary/AltiumMechanicalLibrarySchematic.SchLib
