bayavahmed/PCB_LIBS/KiCADLibrary/KiCadDeviceSheet/SMPS/smps.kicad_pcb

## KiCad design KiCADLibrary/KiCadDeviceSheet/SMPS/smps.kicad_pcb (2025-12-09)

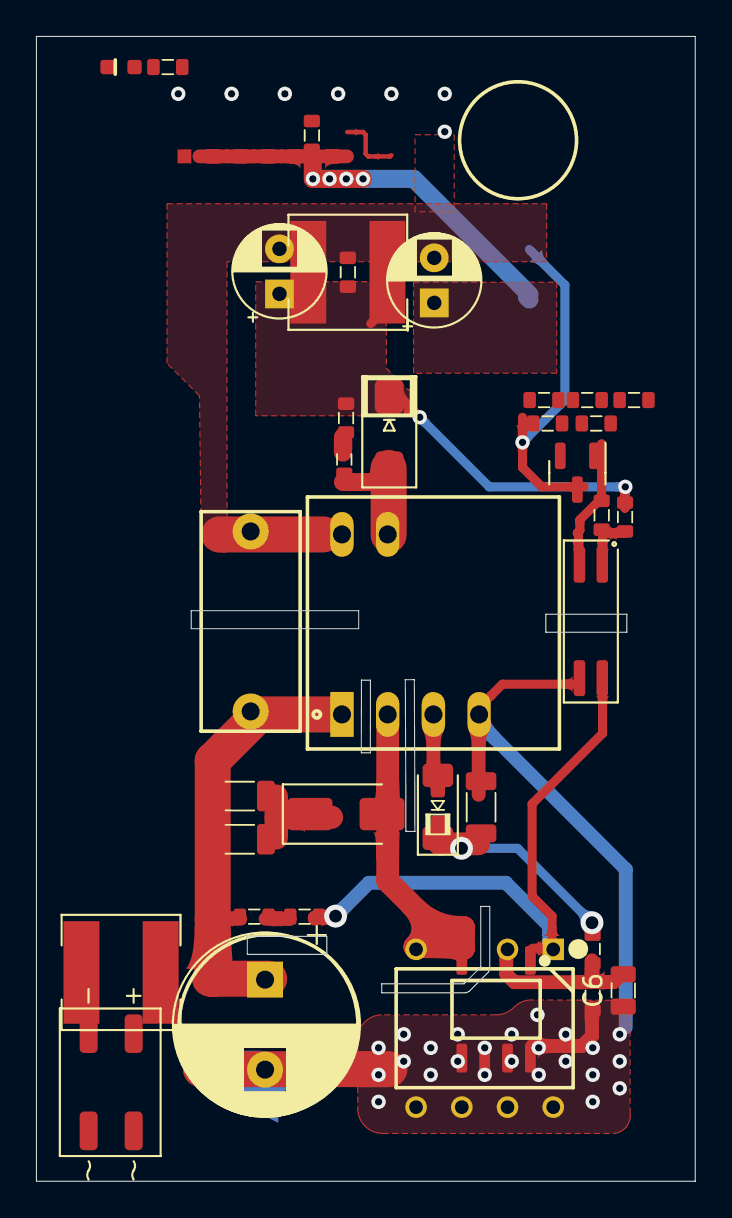
[picture p144: board smps.kicad_pcb from above]

Board: 2 copper layers, 36.6 x 63.6 mm, 37 parts (0 on the bottom side), 20 nets.

Parts:
C1: 10uF/4000VDC; CP_Radial_D10.0mm_P5.00mm
C2: 10nF/500V; C_1206_3216Metric_Per
C3: 10uF / 25V; C_1206_3216Metric_Per
C4, C9, C13: 100nF; C_0603_1608Metric_Per
C5: 2.2nF/2000V; CAP-Y1 10mm
C6: 10uF; C_0805_2012Metric_Per
C7: 470pF; C_0603_1608Metric_Per
C8, C12: 100uF; CP_Radial_D5.0mm_P2.50mm
C10: 10nF; C_0603_1608Metric_Per
C11: 1uF; C_0603_1608Metric_Per
D1: US1M; D_SMA
D2: LL4148; D_MiniMELF
D3: 1N4148WS; SOD-323F_Per
D4: SS26; D_SMA_Per
D5: LED_RED; LED_0603_1608Metric_Per
D6: MB10S; Diode_Bridge_MBS
L1: 1mH/100mA; L_6x6_SMD
L2: 22uH/0.7A; L_6x6_SMD
OC1: LTV-217; SO-4_4.4x2.3mm_P1.27mm
R1: 220kΩ; R_1206_3216Metric_Per
R2: 16.9kΩ; R_0603_1608Metric_Per
R3, R4: 2MΩ; R_0603_1608Metric_Per
R5: 75Ω; R_0603_1608Metric_Per
R6: 220Ω; R_0603_1608Metric_Per
R7: 1kΩ; R_0603_1608Metric_Per
R8: 100Ω/%1; R_0603_1608Metric_Per
R9: 6.04kΩ/%1; R_0603_1608Metric_Per
R10: 1.58kΩ/%1; R_0603_1608Metric_Per
R11: 10kΩ; R_0603_1608Metric_Per
T1: smps_trafo_3Winding_TNY284; SMPS_Trafo_3Winding - TNY284
U1: TNY284D; TNY284D_SMD
U2: TNY284PG
U3: TL431DBZ; SOT-23

Connections:
+12V: C11.2, C12.1, C13.2, L2.2, R9.1, R11.2
GND: C5.1, C8.2, C11.1, C12.2, C13.1, D5.1 (K), R10.2, T1.10, U3.3 (A)
GNDPWR: C1.2, C3.2, C4.1, C6.1, OC1.3, T1.4, U1.5 (S), U2.5 (S)
unnamed: C7.2, R5.2
unnamed: C10.2, R8.2
unnamed: D1.2 (A), T1.2, U1.4 (D), U2.4 (D)
unnamed: C2.2, D1.1 (K), R1.1
unnamed: D2.2 (A), D3.2 (A), T1.3
unnamed: D4.2 (A), R5.1, T1.9
unnamed: C7.1, C8.1, D4.1 (K), L2.1, R6.1
unnamed: D5.2 (A), R11.1
unnamed: D6.1 (+), L1.1
unnamed: OC1.1, R6.2, R7.1
unnamed: R3.2, R4.1
unnamed: C4.2, C6.2, R2.1, U1.2 (BP/M), U2.2 (BP/M)
unnamed: OC1.4, R4.2, U1.1 (EN/UV), U2.1 (EN/UV)
unnamed: C9.2, OC1.2, R7.2, R8.1, U3.1 (K)
unnamed: C9.1, C10.1, R9.2, R10.1, U3.2 (REF)
VCC: C3.1, D2.1 (K), D3.1 (K), R2.2
VDC: C1.1, C2.1, C5.2, L1.2, R1.2, R3.1, T1.1
