bayavahmed/PCB_LIBS/(commit log)

2025-12-09 pcb kutuphaneleri birleştirildi
    [022288041.stp, 0ZCJ.step, 1206.step, 14057.SLDPRT, 14125.stp, 14500 battery.step, 1758050.stp, 1803426.stp]
2025-12-14 slide switch eklendi. step modeli eklendi
2026-01-04 kicad MCP3911 düzeltme
2026-01-18 usb extender ve konnektör
    [0484050004.stp, WURTH_USB3_A_F_692122030100.stp]
2026-03-17 rakorlu kutu eklendi. RF shield düzenlendi.
    [TB-1712-M5-NOCOVER.FCStd, TB-1712-M5-NOCOVER.step, TB-1712-M5.STEP]
