bayavahmed/PCB_LIBS/(notices)

Notices in the files:
AltiumLibrary/steps/DCJ250-10-A-K1-K.stp:
FILE_NAME( 'p:/temp/worker_657/temp/exporttempdir_8052_140_mlTEg/format_0/DCJ250-10-A-K1-K.stp', '2020-11-30T19:56:45', ( 'License CC BY-ND 4.0' ), ( 'CADENAS' ), ' ', 'PARTsolutions', ' ' );
KiCADLibrary/Personal/3DMODELS/250-205.stp:
author */ ('License CC BY-ND 4.0'),
